Lautstark/vorlaut-diy-talker/docs/cable.md

# Content over the cable

How the editor gets pictures and sentences onto the device once there is no
server left to fetch them from: down the USB-C cable it is charged through
anyway.

The way that is being replaced — the search, the five digits, the manifest over
HTTP — is in [software.md](software.md), and it is worth reading first. Almost
every decision here is that one turned around, and the reasons it is turned
around are the interesting part.

## Why the old way stopped being possible

The device used to **pull**. It looked for the computer with a UDP broadcast,
paired itself, fetched a manifest and then fetched the files it did not have.
That worked because there was a server: something with an address, listening.

The editor is becoming a page and nothing else. Two things follow, and neither
is a matter of taste:

- **A browser tab cannot be an HTTP server.** There is no address for the
  device to fetch from. Nothing in the browser can be given one.
- **A page served over HTTPS may not talk to a plain-HTTP device on the local
  network.** That is mixed content, and it is blocked. Serving the page over
  plain HTTP instead would cost every other browser API the rewrite depends on,
  because those need a secure context too.

So the device cannot pull, and it has to be pushed to. The only wire left
between the two is the one that was always there: the cable that charges the
battery. That is why the USB-C socket has to reach an edge of the case — see
[hardware.md](hardware.md), where it is a requirement for a different reason.

## Lines, and a mark on every one of them

Everything here is `keyword value` lines, for the reason
[software.md](software.md) gives at length for the manifest and the pairing
format: **a JSON parser on the ESP32 means a library, a heap and a class of
failure a fixed line format does not have.** A reader skips keywords it does
not know, so either side can gain a field later without the other falling over.

What is new is that every line is **marked**, in both directions:

```
> hello                    the browser speaks
< vorlaut 1                the device answers
```

This wire is not a private channel. It is the same USB CDC serial port the
firmware prints its log to, and it prints all the way through a transfer —
`menu opened`, `key 1: /a8c1….wav`, `LittleFS: 486400 of 1441792 bytes used`.
Without the marks, the browser would have to guess whether a line was an answer
or a diary entry, and the device would take a serial monitor's stray keystrokes
for commands.

With them, the rule on each side is one line long:

| | |
|---|---|
| the browser | ignores everything that does not begin `< ` |
| the device | ignores everything that does not begin `> ` |

The device's log survives that instead of being crushed by it: the browser puts
every unmarked line in the transfer sheet's log, which is the most useful thing on the wire
when something has gone wrong. `tools/serialcheck.html` shows them mixed in,
and the mock in `loader/tools/cable_mock.js` chatters on purpose so that a client
which only works on a silent wire fails here rather than on a bench.

## The device is deliberately stupid

Seven verbs, and each of them is one thing:

```
> hello                      who are you
> list                       what have you got
> crc <name>                 checksum one file
> get <name>                 hand one back, as raw bytes
> put <name> <size> <crc>    one file follows, as raw bytes
> rm <name>                  throw one away
> done                       that is all
```

It does **not** work out what is missing. Over Wi-Fi the device did exactly
that — it compared the server's manifest against its own file system — and it
had to, because the server could not push. Here the browser can, and the
browser is the end with the memory, the language and the whole layout in front
of it. Everything the device would have had to hold in a `String` to do the
comparison is a `String` it does not allocate.

**`get` is the seventh verb and the newest, and it is here to keep that
sentence true rather than to soften it.** Once a device holds several
collections, removing one means working out which tiles and recordings the
collections that *stay* still name. Something has to read those layouts, and
there were only two candidates: the device parses its own files and answers a
question about them, or it hands the files over and the browser does the
arithmetic it already does for every `put`.

A device that walked its own layouts would be a device with an opinion — the
first thing here that decides rather than does, and the exact shape the Wi-Fi
version had before the push turned it around. Handing a file back is one more
thing the device *does* and no more thinking, which is the same shape `crc`
already had: the browser asks a narrow question, the device answers it without
knowing why. So the vocabulary grew and the stance did not.
[ADR 0021](../adr/0021-the-device-holds-several-collections.md) argues it at
length.

Nobody probes for the verb. `collections` in the greeting says whether a device
holds more than one, the verb and the capability arrived in the same firmware,
and only a device that named a number above one is ever sent a `get` — so an
older talker is never asked something it cannot answer. If one were, `err verb`
comes back, which is a word to act on rather than a silence to guess at.

So `list` walks the directory and prints it as it goes, and the diff happens in
`loader/tools/cable.js`. The answers:

```
< vorlaut 2                  it is one of ours, and 2 is the protocol version
< firmware v0.4              and this is the build it is carrying
< total 1441792              the partition
< free 1146880               what is left of it
< collections 16             how many collections it will hold
< tiles vt1                  and which tile forms it can draw
< audio va1                  and which recording forms it can play
< end hello

< file t3bd7….bin 26912
< file a8c1….wav 41008
< end list 37

< crc layout.bin 1a2b3c4d
< data c3bd7….bin 5104 1a2b3c4d   a file coming back: length, checksum, then bytes
< sent c3bd7….bin 5104       and that is what really went
< go 4096                    send at most this much, then wait
< ack 8192                   this much is in the file system
< ok a8c1….wav 41008
< gone t3bd7….bin
< bye 12 3 486400            stored, removed, bytes
< err nospace                may replace any of the above
```

**`hello` is how the browser knows what it is talking to at all.**

There used to be a `files` line here, and taking it out on 2026-09-02 is worth
a paragraph because of how it was found. The device could not say the number
without walking its whole root, a lookup per entry, and on a 7040 KiB partition
holding 322 files that walk took 6.4 seconds against a browser that gave any
one answer five. So a talker that had been filled up stopped answering the
loading page, and said so in the words for a device that is not there - the
cable was in and the device was awake. The browser end got patience for the
walks that remain, and then the walk that nothing needed was taken out: nothing
read the number. The page works in `total` and `free`, and what is on the
device it asks for with `list`, which walks once, when somebody wants it.

Dropping a line costs no protocol version for the same reason gaining one does
not, and the notes below say it several times over: a browser that hears no
`files` keeps whatever it started with. The direction that needs holding is the
other one - every talker flashed before that release still says it - and that
is held on the browser's side, where the reader is. The person
picks a port out of a dialog, and a laptop has several — a dongle, a printer,
another dev board. A port that does not answer `vorlaut` within a moment is
not the talker, and saying so is nicer than timing out later mid-transfer.
`free` earns its place in the same answer: it is what lets the browser refuse a
payload that will not fit *before* it starts sending one.

The `total` above is a device on the 1536 KiB table — 1441792 is what LittleFS
makes of it — because that is the number `device/fixtures/` was frozen with and
those fixtures are not re-cut for a partition table. A device flashed since
2026-08-31 answers with the 7040 KiB one instead, and nothing on either end has
to be told which: that is the point of the number being in the greeting.

**`firmware` is a different question from `vorlaut`, and that is why it is a
different word.** The protocol version moves only when the two ends can no
longer drive each other, so every talker says the same number for releases at a
time; asking it which build a device is carrying gets an answer that was true
of a dozen firmwares. So the greeting names the build as well: a release says
its own tag, because `release.yml` compiles with `-DVORLAUT_VERSION` out of
`GITHUB_REF_NAME`, and anything compiled anywhere else says `dev`. Nobody edits
a constant to cut a release — see
[`firmware/vorlaut/version.h`](../firmware/vorlaut/version.h) for why a number
somebody has to remember to move is worse than no number at all.

Nothing on either side orders two of these words. The device names its build,
the browser writes the name down, and a page that wants to say "two releases
behind" has to hold it against a version it brought itself. **A device that
says nothing here is not a fault**: it is any talker flashed before
2026-08-28, and refusing one would refuse every device already in a drawer.
`fixtures/cable/firmware-named-in-the-hello` is the transcript that names a
build, and the eight beside it are the ones that do not.

That keyword is also the first this protocol has ever gained, and it is the
extension rule the header has claimed since it was written actually running:
the device says a word older browsers skip, and `CABLE_VERSION` did not move.

**`tiles` is the second, on 2026-08-31, and it is the rule paying for itself.**
A tile may now travel compressed ([ADR 0019](../adr/0019-tiles-travel-compressed.md)),
and a device flashed before that day would draw a compressed one as a palette
followed by noise — a full panel of it, silently, in a house nobody here knows
about. So the browser sends the compressed form only to a device that named it,
and every device that says nothing keeps getting exactly the bytes it got
yesterday. `fixtures/cable/tiles-named-in-the-hello` is the transcript that
names a form; the nine beside it are devices that do not.

The word is matched whole and never ordered. There is no "newer" here: a
browser that read an unknown form as probably-compatible would be sending a
file it cannot know the other end can read, and neither end would say anything
when it was wrong.

**`collections` is the third, on 2026-09-01, and it decides whether a transfer
adds or replaces.** A talker used to carry one collection in `layout.bin`, so
what the payload did not name was stale and the sweep below is a correct sweep.
A talker that holds several has no way to tell "stale" from "belongs to the
other game" — every tile is named for its content, so two collections that use
the same picture use the same file — and there the sweep is the one edit that
silently breaks a collection nobody touched.

So the device says how many it will hold, and **silence means one**, which is
what every talker flashed before that day really holds. A number, not a flag:
the browser has to refuse a payload that would push a device past what it can
keep, and it cannot do that against a boolean.
[ADR 0021](../adr/0021-the-device-holds-several-collections.md) is the decision,
and `fixtures/cable/collections-named-in-the-hello` is the transcript.

It also runs the other way, and this is the half that is easy to get wrong. A
page that knows about collections sends `c<hash>.bin`; a device that does not
opens `/layout.bin` and no other name. Sent the new name it would store a file
it never reads and — being a one-collection device, so a device every transfer
replaces — sweep away the one it does, coming back with five black keys from a
transfer that reported success. **So the greeting picks the name too:** one
collection gets `layout.bin`, more than one gets `c<hash>.bin`, decided in
`underDeviceNames()` in `loader/src/cable.ts` at the same point the tiles pick
their form, because that is the first place that knows who is listening.

**`audio` is the fourth, on 2026-09-01, and it is the same rule with a louder
failure behind it.** A recording may now travel as IMA ADPCM
([ADR 0022](../adr/0022-recordings-may-travel-compressed.md)) — four bits a
sample instead of sixteen, still a WAV, distinguished only by the tag in its
`fmt` chunk. A device flashed before that day never opens `fmt`: it plays
whatever is in `data` as 16-bit PCM, so a compressed recording comes out as a
full-volume hiss where a word should be, at the moment somebody pressed a key
expecting one.

Two words rather than one, and that is not tidiness. Every talker flashed
between 2026-08-31 and 2026-09-01 draws a compressed tile and plays no
compressed recording, so a browser that read `tiles vt1` as a general yes would
send that device a file on the strength of an answer about pictures.
`fixtures/cable/audio-named-in-the-hello` is exactly that device, and
`fixtures/cable/audio-form-named-in-the-hello` is one that names both.

Naming the form is only half of what has to be true before a recording is
compressed. **The other half is a person**, because nothing in a package says
whether its recordings are words in a game or things somebody is understood
through, and four bits a sample is bearable only in the first case. The loader
page asks, above the button, and the answer is not remembered — ADR 0022 has
why.

**A verb the device does not know is answered, not ignored.** `err verb` comes
back. A browser waiting for a reply that never arrives looks exactly like a
broken cable, and the two are worth telling apart.

**And the number in `vorlaut 2` is compared.** It had not been until
2026-08-27: `findTalker()` tested it for truthiness, so any non-zero version was
accepted and then driven as whatever the browser spoke, and the only thing that
read it at all was a test grepping `tools/cable.js` for the digit. That was
survivable while there was one protocol. The acknowledged transfer made it two.

A version that is not this browser's is **refused, in both directions**, and
the reason is what the number means rather than caution. `cable_format.h` bumps
it exactly when the two ends can no longer drive each other, and says outright
that gaining a keyword is not that — unknown keywords are skipped on both sides
and cost no version at all. So a different number is a statement that these two
do not work together, and there is no field saying a particular bump was safe
one way round. Sending anyway means finding out mid-transfer: a browser waiting
forever for an `ack` it will not get, or a device overrun and failing on a
checksum. Either can leave a talker with silent keys, which is worse than a
sentence before anything is sent.

The two directions get different sentences, because the remedies are opposite
and neither of them is "the device is broken":

| The device says | What it is | What fixes it |
|---|---|---|
| a version below this page's | firmware older than the page | flash the device |
| a version above this page's | the page is the stale half | reload the page |

`hello` does not refuse either of them. It is also how the browser tells a
talker from a dongle, and throwing there would file a device that answered
under the same heading as a port that said nothing — which reads as "nothing
answered" and sends somebody to check a cable that is fine. So the greeting
comes back whole, `versionVerdict()` says what it means, and `findTalker()`
keeps walking the remaining ports before it reports anything: two boards
plugged in should still reach the one that works.
`fixtures/cable/version-older-device` and `version-newer-device` are the two
transcripts.

## The names already say what changed

The file names are hashes, so the manifest thinking from
[software.md](software.md) carries over whole: **the same symbol or sentence in
three sets is one file, and a name that is already on the device is already the
right content.** The browser lists, subtracts, and sends the difference. In use
that means almost nothing moves — changing one symbol and one sentence in a
five-set layout sends three files and deletes two.

`layout.bin` is the exception at both ends, exactly as it was over Wi-Fi. Its
name never changes, so presence proves nothing about it, which is why `crc`
exists as a verb. It is the only file the browser has to ask about, and asking
about it costs one line.

## A name is not a checksum

This is the trap in the paragraph above, and it is easy to read past in
[software.md](software.md), which states it plainly and then moves on:

> the names are hashes of the **input** — source image plus pipeline version,
> or text plus voice configuration — not of the output bytes.

So a name tells the device which content was *meant*. It cannot tell it what
actually *arrived*. Every `put` therefore carries a CRC-32 of the bytes, and
the device refuses the file if what it received does not match.

CRC-32 rather than something cryptographic, because what is being guarded
against is a transfer that went wrong, not somebody choosing bytes to fool us —
whoever is holding the cable can write whatever they like anyway. What it
catches is the silent set: a truncated transfer, a byte count one out, a
partition that quietly stopped accepting writes. All of those otherwise end as
a file under a name that promises whole content. It is the same CRC-32 as
`zlib.crc32`, so a value can be checked by hand.

## The order, and why layout.bin goes last

A push is: send what is missing, send `layout.bin`, then delete what is stale.

That order is not arbitrary. `layout.bin` is the table that says which file
belongs to which key, so **it is the commit**. Until it lands the device still
reads the old one — and the old one still points at files that are all still
there, because nothing has been deleted yet. The moment it lands, every file it
points at has already arrived. There is no instant at which the device holds a
layout referring to a file that is not there.

Doing it the other way round — clearing out first — has a failure that is quiet
and nasty: a transfer that breaks off halfway leaves the old layout pointing at
symbols that have been deleted, and the device comes up with silent keys and no
explanation.

The cost of the safe order is room. For the length of the transfer both the old
files and the new ones sit on the same partition — **6.9 MB** since 2026-08-31
(`spiffs` in [`firmware/vorlaut/partitions.csv`](../firmware/vorlaut/partitions.csv),
7040 KiB), and **1.5 MB** before it, on every device that has not had a whole
image written since. A full payload is around 950 KB, so on the old table
replacing *every* symbol and *every* sentence at once did not fit; on the new
one it fits several times over.

What the browser does about it has not changed and should not: the size is the
device's answer, not the page's assumption. `free` came back in the `hello`, and
if the new files will not fit alongside the old ones it falls back to clearing
out first and says so on the page. If it will not fit even then, the payload is
simply too big for the partition and nothing is sent at all. That the fallback
is now rare on a device with the new table is a property of that device, and
the page finds it out by asking.

## Half a file, and the handshake that prevents worse

Files land under `/.part` and are renamed only once they are whole and their
checksum agrees — the same rule `sync.h` followed, for the same reason. **A
transfer that breaks off leaves a fragment behind, never half a file under a
name that promises whole content.** The name was shared with the Wi-Fi sync
while both existed — deliberately, since the two never ran at once — and it is
this one's alone now.

The `go` in the middle of a `put` is the other half of that:

```
> put a8c1….wav 41008 1a2b3c4d
< go 4096
<4096 raw bytes>
< ack 4096
<4096 raw bytes>
< ack 8192
    …
<432 raw bytes>
< ack 41008
< ok a8c1….wav 41008
```

**The bytes are sent only after `go`.** By then the device has checked the name,
checked that the file will fit, and opened `/.part`. Without the handshake, a
device that refused the file would be followed by 41008 bytes of WAV arriving in
its line reader — and somewhere in a WAV there is eventually something that
looks like a command. The round trip costs about a millisecond and removes the
whole category.

**And the bytes go a window at a time.** That is the subject of [the window is
the flow control](#the-window-is-the-flow-control) below, and it is the reason
this document no longer has a receive buffer in it.

**The name is created by the rename and by nothing else.** That is worth
stating on its own, because more rests on it than on any other line of the
device's code. The order is: write every byte into `/.part`, check the
checksum, and only then rename. There is no point at which the final name
exists holding bytes that have not been checked — an interrupt leaves a
fragment under a name nobody consults, or it leaves nothing.

Two things follow that would otherwise both be wrong:

- **Keeping a file because its name is present is sound.** The browser skips
  what the device already has, on the name alone. If a transfer could leave a
  short file under its real name, that file would be kept for its name, never
  sent again, and `layout.bin` would eventually point at a truncated tile or a
  truncated recording. Silent, and permanent, because nothing ever looks at it
  again. The rename is what makes the skip safe.
- **Stopping is free, at any moment.** A cancelled push costs the fragment in
  `/.part` and nothing else, so cancelling is a matter of not sending the next
  thing rather than of undoing the last one.

The browser compares the size as well as the name — one comparison, and `list`
already reports sizes. That is a net under the rename rather than a second
opinion: if the invariant above were ever broken, by another implementation or
a damaged file system, a wrong length turns a silent-and-permanent fault into a
file that is simply sent again.

The bytes are raw rather than base64 or hex. Base64 would cost a third of the
budget — on the 1.5 MB partition of the day, a third of everything there was —
and, worse, would make the *device* do work per
byte to undo it. The device reads exactly `size` bytes and then goes back to
reading lines; it never has to look for a newline inside file content.

## Losing the thread, and finding it again

The one thing that can genuinely desynchronise this protocol is a `put` that
does not finish: the browser tab was closed, the person walked off, the cable
came out and went back in. The device is then counting down to a byte total
that will never arrive, while the rest of a file may still be in flight.

Three rules handle it, and they are the part of this protocol that most wants a
real device to be tried on:

1. **Give up on silence.** Four seconds without a byte and the transfer is
   abandoned, `/.part` is deleted and `err short` goes back. Nothing here may
   hang: a device parked in a transfer is a device that has stopped being a
   talker, which is the same rule the setup portal's three-minute timeout
   follows. A file system that stops accepting bytes partway through says
   `err lost`, which is a different word from the `err write` of a file that
   could not be opened at all — the distinction is not cosmetic, it is
   whether there are still bytes in flight to be thrown away.
2. **Drain before listening.** What is left of the window may still be coming,
   so the device throws bytes away until the wire has been quiet for 400 ms.
   Only then does it read lines again. The window is what makes that a few
   thousand bytes rather than most of a WAV — but it is not why the rule
   exists, and the rule does not change with it.
3. **Only `hello` gets back in.** Everything else is answered `err session`
   until the browser introduces itself again. A stretch of a WAV that happens
   to contain `\n> hello\n` would have to be chosen on purpose, and whoever is
   holding the cable has easier things to do.

### The four seconds, and what they are now for

`CABLE_QUIET_MS` used to be the one constant here with a real design risk
behind it: it had to be longer than any pause LittleFS could take in the middle
of a transfer, and nothing on a computer could say what that was. A run that
worked only showed the pause did not exceed four seconds *once*.

**That risk went with the window.** The device now waits only for bytes it has
just asked for, so what four seconds has to outlast is one round trip and a
browser's own scheduling — milliseconds against seconds. It stays where it is
rather than being tuned down, because what it is really for is a browser that
has gone away, and noticing that a little late costs nothing.

The browser has the mirror of it and waits five seconds for any one answer.
Longer on purpose: both ends are waiting on each other during a transfer now,
and whichever gives up first is the one that gets to say why. The device gives
up first, sends `err short` and shuts the session — which reaches the browser
as a word to act on instead of a silence to guess at.

So the device measures and reports, before every `ok`:

```
< gap 12         longest stretch this file spent with nothing arriving
< stall 340      longest single write into LittleFS
```

Two numbers, because they are two different risks and one would hide the
other. `gap` is what `CABLE_QUIET_MS` is actually compared against. `stall` is
where a garbage collection pause shows up — and it does **not** appear in `gap`,
because while it happens the device is inside `file.write()` rather than
waiting for bytes.

**What `gap` means changed with the window**, and it is worth knowing which
number is being read. It used to be the browser running late, and under a full
receive buffer it read 4001 ms because the bytes were not late at all but gone.
Now the device waits after every `ack` for a window it has just asked for, so
`gap` is a round trip: expected to be small and **not zero**. A zero over a
whole payload no longer means nothing was ever late — it means no window was
ever waited for, which is a client that is not acknowledging.

Both are ordinary keyword lines, so a reader that does not know them steps over
them. That rule is stated all through this document; these are the first lines
to depend on it, which is worth saying because until they existed the browser
client did not actually follow it. It does now, and the mock reports fixed
values so every test run goes through that path rather than only the one test
aimed at it.

The bench shows the worst of each after a push, with the margin.

**The numbers that were here were taken under version 1 and do not carry over.**
They are kept below because the reasoning is still worth reading, but they
describe a protocol in which the browser sent whether or not the device was
listening, and that is no longer what happens.

| measured 2026-08-23, protocol version 1 | |
|---|---|
| longest `gap` over a full payload | 0 ms |
| longest `stall` over a full payload | 53 ms |
| the same payload before `CABLE_RX_BUFFER` | `gap` 4001 ms, dead on the first file |

A full payload of ten files and 199 KiB, across in 3.3 s at 60 KB/s. The `gap`
of 0 did not mean the wire was fast; it meant a 64 KB buffer was swallowing the
burst, so the device never had to wait. And the 4001 ms before that buffer
existed was not lateness — the device was waiting for bytes that had been
**thrown away**, which no value of `CABLE_QUIET_MS` could have rescued.

**What version 2 has to show is different, and it is still a prediction.**
Version 2 *has* run on hardware since — that is the six-row table at the end of
this document — but every run so far was driven by hand, and none of these three
numbers was read off the page while it was sending. So this stays written down
before the measurement rather than remembered after it:

| what a bench run has to report | what it should say, and why |
|---|---|
| longest `gap` over a full payload | **small and not zero.** The device waits after every `ack` for a window it has just asked for, so the gap is now a round trip. Zero would mean no window was ever waited for. |
| longest `stall` over a full payload | around 53 ms still, or worse on a fuller partition — and it no longer matters what it is. A stall is a pause now, not a hole. |
| the rate | slower than 60 KB/s, by one round trip per window. 55 of them for that payload, so the question is whether it is 5% or 50%. |
| bytes lost | **zero, and this is the one that is not a matter of degree.** A short file, a wrong checksum or an `err short` on a payload the device had room for means the window is not doing its job. |

The last row is the whole change. The others are the price of it, and the price
is worth knowing before anybody decides it is too high.

### The window is the flow control

The device sends a number with its `go` and takes no more than that before
saying it has the bytes:

```
< go 4096          at most this much
<4096 raw bytes>
< ack 8192         and this much is now in the file system
```

`ack` carries the **running total**, not the size of the piece. A per-piece
count agrees with itself all the way down a stream that has slipped; a total
disagrees with what the browser has sent, at the first window, out loud. The
browser compares them and stops.

Three things follow, and the third is the point:

- **The browser reads the number, it does not choose one.** The device is the
  end that knows how much room it has. A browser with a chunk size of its own
  is the guess this replaced, one layer up.
- **The end of the file ends the window.** The last one is short and is
  acknowledged like the rest, so neither side has a full-or-partial case to get
  wrong. An empty file has no windows and no acks, which is the rule read
  literally rather than an exception to remember.
- **The bytes in flight are bounded by a number the device chose**, so the
  receive buffer is sized from it — `Serial.setRxBufferSize(CABLE_WINDOW)`,
  4 KB where 64 KB used to be. That is not a saving, it is the difference
  between a promise and a hope.

**`CABLE_RX_BUFFER` was a workaround and it has gone.** It was arithmetic
rather than comfort — USB fills an empty buffer at about 490 KB/s, the longest
LittleFS write measured 46 ms, so 22 KB could arrive with nowhere to go, and
16 KB had already been tried and lost 214 bytes of 26912. But it was a *bound
and not a guarantee*: a longer stall on a fuller partition would have overrun
64 KB in exactly the same silence, because the interrupt reads the USB FIFO,
finds no room and discards, and CDC has no way to tell the other end. The
browser reports every chunk written and the device is quietly short.

There is no number to get wrong now. The device cannot fall further behind than
it asked to.

**It cost a version.** `CABLE_VERSION` is 2, and the break is in both
directions: a version 1 browser pushes a whole file into a device waiting to be
asked, and a version 1 device never sends the window a version 2 browser waits
for. There is no compatibility path and there should not be one — no devices
are in the field, every one is on the desk, and a protocol carrying a path
nobody needs is worse than a clean one. It was free exactly once.

**And it did not add a second idea of a session.** That was the thing to watch:
an acknowledgement scheme is where "in a transfer" quietly becomes state that
outlives the transfer. The window and the running total live for one file and
die with it. `open` in `serve()` is untouched, so the rule below still reads the
way it did.

That third rule is not a special case. **A device that has not been greeted is
in exactly the same state as one that has just lost a transfer** — refusing
everything but `hello`. One rule, two uses, and no separate idea of "in a
session" to get wrong.

Before a greeting the device only waits a quarter of a second for a whole line,
rather than four. Until a browser has said `hello`, whatever is on this wire is
as likely to be a serial monitor or one stray byte, and every millisecond spent
here is a millisecond the keys are not being read.

## Stopping halfway on purpose

A push takes a cable's worth of time, and the page needs to be able to stop —
a dialog closing, a navigation, somebody changing their mind. That is an
`AbortSignal` passed into `push()` rather than a `cancel()` on the connection:
all the time is inside that one function, and a signal composes with the page's
own reasons to stop through `AbortSignal.any()` in a way a bespoke method
cannot.

**It is checked between files, not inside one.** It could be checked inside
one — the rename above makes stopping safe at any instant — but a push stopped
mid-file leaves the device counting down its four seconds to bytes that will
never arrive, after which the session is shut until `hello`. A step boundary is
at most one file away, well under a second, and leaves the connection usable.

An aborted push never sends `done`, which is the point: `done` is what makes
the device read its new layout in, and a half-sent payload is not one to start
reading. Closing the connection is the caller's business, not `push()`'s — the
cable was handed in, and a caller that wants to abort and retry should not find
its port shut underneath it.

## No pairing, and no key

Over the network, the device showed five digits and somebody typed them into
the page. That existed to answer one question: is the thing asking for this
content actually standing in front of the device? The digits were a way of
proving physical presence over a wire that anybody on the network shares.

**The cable is that proof.** Whoever has hold of it is in the room, with the
device in their hand. There is nothing left for five digits to establish, and
so there is no pairing, no secret, no token and nothing stored in NVS.

That does mean anyone who can plug into the device can rewrite its content.
That is worth saying out loud, and it is the same trust the project already
extends to physical access — anyone who can plug in can also reflash it
entirely. What has genuinely gone away is the harder case the digits were
really guarding: a second machine *on the network* claiming to be the device.
There is no network.

## Two facts about the browser that shaped this

**`requestPort()` needs a click; `getPorts()` does not.** Opening the port
picker requires transient user activation, which expires in about five seconds
in Chrome — so it cannot be called after a long build, and it cannot be called
from a timer. But `getPorts()` returns ports the person has already granted,
with no gesture at all. That decides the shape of the whole interaction:

> **one explicit connect, the first time, and silent reconnect forever after.**

So the page must not do anything slow between the click and the call, and it
should try `getPorts()` by itself on load. `tools/serialcheck.html` does both.

**WebSerial needs a secure context.** `https://` and `http://localhost` both
qualify; a page opened as a `file://` does not. That is not a constraint the
static site has to work around — it needs a secure context for several other
reasons already — but it does mean the harness has to be *served*.

The baud rate is a formality. `port.open()` will not run without one and the
sketch calls `Serial.begin(115200)`, so both say 115200; on the ESP32-S3's
native USB there is no UART in the path to run at it, and the throughput is
whatever USB and LittleFS manage between them.

One thing to leave alone: **DTR and RTS.** Toggling the two together in the
right pattern is exactly how `esptool` drops an ESP32 into its bootloader.
Raising DTR on its own is wanted — it is what makes the device's own `Serial`
report a connection — but nothing should ever drive the pair in sequence.

## What this does not do

- **It cannot wake a sleeping device.** After its idle timeout the talker goes
  into deep sleep, and USB traffic is not one of the things that wakes it.
  Press any key first, then push. The device stays awake for the whole session
  because every line resets the idle timer.
- **There is no other path to fall back to.** `sync.h`, `discover.h`,
  `networks.h`, `pairing.h` and `pair_format.h` were deleted on 2026-08-23,
  along with the radio and the five digits — see [The Wi-Fi path is
  gone](#the-wi-fi-path-is-gone) for why that happened before this had run once.
  The one thing the two used to share is handled: a device that was synced
  before still has `/version` on it, and because the name is now an ordinary one
  the first cable session sweeps it off.
- **The timing rules are the part a board has proved least.** A board ran
  version 1 on 2026-08-23 and produced the two numbers in [the four
  seconds](#the-four-seconds-and-what-they-are-now-for) above; version 2 has
  since run on real hardware too, and five of the six rows below are ticked —
  see [The Wi-Fi path is gone](#the-wi-fi-path-is-gone). What those runs did
  *not* produce is a number: `gap`, `stall` and the rate are reported by the
  page while it sends and nobody has written them down. So the three timing
  rules above, which are exactly the part no test without a clock can exercise,
  rest on a talker that visibly worked rather than on a measurement. Everything
  else has been checked on a computer; see [Where it lives](#where-it-lives-and-what-is-checked).

## Running it on a device

Nothing here needs sound or the case — a flashed board and a cable are
enough, so this can be tried well before [bring-up.md](bring-up.md) reaches its
last stage.

**1. Check the one setting that stops everything.** *Tools → USB CDC On Boot*
must be **Enabled**, or `Serial` is not the USB CDC and no part of this can
work. Under `arduino-cli` it is already the default for this board.

**2. Flash the firmware.** The content does not have to go with it — that is
what the cable is for — so the program alone is enough:

```bash
arduino-cli compile --fqbn esp32:esp32:adafruit_feather_esp32s3_nopsram:PartitionScheme=default_8MB firmware/vorlaut
```

Upload it with the same `--fqbn` and `-p /dev/cu.usbmodemXXXX`, as in
[firmware.md](firmware.md). A device with an empty file system is a fine
starting point here and is worth using at least once: it is the first row of
the table below.

**3. Serve the bench.** Any static server will do — it needs no back end, and
`localhost` is a secure context, which is all WebSerial asks for:

```bash
python3 -m http.server 8799
```

**4. Export the Sammlung, then open the loader page.** These are two steps and
two pages now, and [ADR 0011](../adr/0011-editor-exports-the-talker-repository-sends.md) is
why: the editor writes a file for the talker — the `⋯` beside the Sammlung's
name — and says where to take it, and `/loader/` is the page that takes one.

**5. Connect the talker there, and then send.** The page opens on one card
with one press on it. Connecting is what answers everything else — the greeting
carries the build, the free space and the collection count in one line — so the
view behind that press is the talker itself: what it is running, what it is
holding, and the way to take a collection off it.

*Send a collection* is a task entered from there rather than the page itself,
and it runs four steps down one column, saying what it found at each: what is
in the file, anything the device will not be able to do with it, what it
compiled, and then the transfer with the device's own serial output inline in
the log. Four and not five, because connecting already happened at the door;
the connect step comes back only when the connection wants something again — a
talker that went to sleep halfway, a port that was never granted.

The log stays on the page when it is over — it is the most useful thing there
is when something has gone wrong, and it must not disappear with the last
line.

**The door is not a gate.** WebSerial is Chrome and Edge, and so is
`showDirectoryPicker()`; the same card carries a second way in that needs no
device at all, and in a browser without a cable that way in is the primary
button. Checking a file and seeing the boards is worth opening this page for on
any browser, and a page that asked for a talker before it would say so would be
the mistake `gate()` was written to undo, in a better-looking shape.

**Connecting is the first press**, because a port has to be granted and
`requestPort()` needs transient activation that expires in about five seconds.
It used to be the fourth step, behind a build; at the door there is nothing
waiting behind it at all, which is the shape that rule always wanted. The card
explains what the browser is about to ask and puts *Connect the talker* under
it; that button's own click is the activation. Chrome's chooser is drawn
in the browser's chrome and no token of ours reaches it, which is why
everything around it is ours and it is not.

**Closing that chooser does nothing at all** — nothing compiled again, nothing
logged, nothing changed, and the page is still standing on the step it was on.
That is the case this got wrong twice while it lived in the editor: it used to
build anyway and then report that nothing was sent, which read as the dialog
having been ignored; then the chooser was moved out of the press altogether,
which fixed it by removing the thing somebody had pressed the button for. What
made it expensive there was that a wrong port cost a whole build — minutes of
synthesis — and that cost is gone: the compile here needs no network and takes
seconds, so a wrong port costs a second press. Every attempt after the first
goes straight through — `getPorts()` hands the port back with no gesture at
all, and the
sheet names it rather than asking again.

**Choosing a different port later needs no settings panel**, and since
2026-08-25 there is not one. A port that stops answering — a different cable, a
different talker, or one that was never the talker — fails the transfer with
`cable_no_device`; that sets `askAgain` in `release.ts`, and the next press is
back at the step with *Choose the device* on it. The error text says so, so
somebody knows a second press is worth making rather than guessing.

**What that costs is one build, and it is a real cost.** `run()` builds and
then sends, so the press that discovers a dead port has already paid for a full
build with every synthesis in it. One press, one wasted build, then the chooser
and a second build.

The fix would be to find the talker before building rather than after. Two ways
of writing it have been ruled out, and the second is why this is still the way
it is.

**Holding the cable open across the build does not work.** `hello` starts a
session, and the device ends one after `CABLE_QUIET_MS` — four seconds — of the
browser not talking (`firmware/vorlaut/cable.h`, the loop that reports "the
browser stopped talking"). A build is minutes, so that breaks every transfer
rather than only the unlucky ones. Holding it open *without* greeting is no
better: before a hello the wait is `CABLE_GREET_MS`, a quarter of a second,
after which `serve()` simply returns. There is nothing there to keep alive.

**So the probe has to be a session of its own** — open, hello, **close**, build,
open again — and that is where it stops, because `hello` is not free at the
device. It is not a quiet question: `cable.h` calls `progress("hello")`, and
`vorlaut.ino` puts *Kabel* on all five displays for it, which is deliberate and
says so in as many words — it is meant to be obvious at a glance that the keys
have stopped. Closing the port does not undo it, because nothing on the wire
tells the device the browser has gone: it waits out its four seconds, gives up,
delays 1500 ms so a count can be read, and only then redraws. **About five and
a half seconds of a talker showing *Kabel* and answering no key** — before a
build that then takes minutes, and before the real transfer greets it a second
time.

That is the trade backwards: a visible freeze on every good transfer, on a
device a child may be holding, to save one build on the rare bad one. So the
build stays first. Checked against the firmware on 2026-08-25 and deliberately
not built.

**What would make it cheap is a way to ask "are you a vorlaut" that does not
open a session** — something a device answers before `hello`, without reaching
for the displays. That is a change to `firmware/` rather than to the page, and
it is the only thing that turns this from a bad trade into a good one.

**The bench is still here for what that button cannot be.** `tools/serialcheck.html`
is where a payload can be invented with no build behind it — so that a failure
is the wire or the firmware and not one of several new things at once — or read
off the disk with *Pick a `data/` folder*. Serve it as in step 3 and open
<http://localhost:8799/tools/serialcheck.html>. It cannot reach into the
editor's storage — a different origin is a different IndexedDB — which is why
the editor writes the folder and the bench reads it.

Close the serial monitor first if one is open, and close whichever of the page
and the bench you are not using. Two programs cannot hold the same port, and
the symptom is a port that simply will not open.

**5. Watch the device, not only the page.** All five displays should show
*Kabel* with a count climbing, and the talker should come back by itself
afterwards holding the new content. The sheet's log shows the device's own
serial output inline — that is where a mount failure or a wrong partition
scheme will say so.

If nothing answers, the page says so within a moment rather than hanging: a
port that does not reply `vorlaut` to `hello` is not the talker, and that is a
different problem from a transfer that failed.

## The Wi-Fi path is gone

It was deleted on 2026-08-23, and none of the six rows below had been ticked.
This section used to say that must not happen, so it says what changed instead.

**The bar was one real end-to-end success**, and it was met on 2026-08-27 —
five of the six rows at the end of this section, recorded one at a time. The
reasoning behind it was sound: `tiles.py`, `tts.py` and `layout_format.py` had
been *oracles* — the only reason anybody knew the browser ports were right — but the firmware Wi-Fi stack
was an oracle for nothing. It was just the old transport, kept because a working
way to get content onto a device is worth having while the new one is unproven.

**What expired was not the bar but the fallback.** That argument rests entirely
on the Wi-Fi path still being a way in, and it stopped being one when `app.py`
was deleted: the device could still find a network, and there was nothing on it
to find. `build.py` and `flashing.py` went the same day. So what was being kept
as insurance was a radio, a captive portal, four stored networks and a token in
NVS, all serving a path whose other end no longer existed — 850 KB of program
space and 24 KB of RAM, and a device that would have spent seconds looking for a
server nobody was running.

**Prove first, delete second, in separate commits** was the other rule, and that
one was kept. The cable landed on its own, with the browser test that drives it
against the mock; the deletion is the commit after it. A revert of either is
still a revert of one thing.

**What that cost, and what closed it.** For a day it cost the only way back:
if the cable turned out to be wrong on hardware there was no way at all to put
content on a device — not because the radio went, but because nothing wrote the
files to disk. `build.py` had written `firmware/vorlaut/data/`, the browser
build writes IndexedDB, and the backup export leaves build output out on
purpose, so `mklittlefs` had nothing to image and this bench's folder picker
had nothing to pick.

That is what *Write the build into a folder* is for — in the `⋯` beside the
Sammlung's name, with the two exports, because it writes that one Sammlung's
files. It writes exactly what the cable would send, into a folder you choose,
and it is the second way in:

- **The bench can send it.** Pick that folder under *Pick a `data/` folder*
  below. The page and the bench are then two independent clients of the same
  protocol, which is worth having when one of them is the suspect.
- **`mklittlefs` can image it**, and `esptool` writes the image straight into
  the partition. That path uses no cable protocol at all, so it is the one that
  still works when the wire itself is wrong.

It refuses to write a build that no longer matches the board, which is the one
failure a folder cannot show you: yesterday's content looks exactly like
today's once it is on a disk.

It is no longer the gate on a deletion; it is the gate on trusting the only
path there is.

What has to be true, written down before the run rather than remembered after
it. **Results belong in this table as they come in** — a row that was checked
once and remembered is a row nobody can audit later:

| | | 2026-08-27 |
|---|---|---|
| a full payload transfers | all five sets, worst case near the 1.5 MB partition, **with nothing lost** — see the version 2 table above for what each number should say | ✅ **yes.** 25 tiles at exactly 32768 B each — five keys × five sets, none short — 20 WAVs, and a `layout.bin` of 932 B that parses. `free` 131072 of 1572864, so 91.7% full: the worst case this row asks for, met rather than approximated. |
| an incremental transfer moves only what changed | the whole point of the content-addressed names | ✅ **yes, in its strictest form.** A second export was sent and the device came back **byte-identical** — same 46 files, same `free`. Content-addressed names mean a changed file arrives under a *new* hash, so an unchanged listing is proof that **nothing** moved rather than proof that nothing was checked. A naive sender would have pushed 1.4 MB again. Still worth doing once more with one symbol altered, to watch exactly one file move. |
| an interrupted transfer leaves a fragment | pull the cable mid-transfer: `.part` and no half-file under a real name | ⬜ not tested. No `.part` appears in `list`, which is consistent with a clean run and is **not** evidence for this row. |
| the device *speaks* the new content | not merely reports success | ✅ **yes**, reported by the person at the bench. The device also names its own set — `set 1: Sprechen` — where before the transfer it said *"No content on the device."* |
| a second transfer needs no port picker | `getPorts()` finds the device again — **this one decides an interface question, see below** | ✅ **yes.** A later session found the device again with no picker: `getPorts()` returned the previously-granted port after the board had re-enumerated. This is the row that could have put a picker on every transfer, and it did not — see below for why it was never a nicety. |
| a device that already holds content is updated | rather than confused by what is already there | ✅ **yes.** The device held 46 files from an earlier build and answered *"No content on the device"*; after the transfer it holds a valid layout and speaks. |

**Five of six.** Row five was ticked after this table was first filled in, and
what is left is the one row that needs a *deliberate* act: a cable pulled
mid-send. That does not happen by accident during a run that goes well, which is
why it is still blank rather than inferred from one that did.

**Row two was nearly recorded as the wrong row.** It was reported as "a partial
transfer" and that phrase fits row three just as well; the device could not
settle it, because an incremental transfer that moves nothing and an interrupted
one that was cleaned up leave the same listing. It took asking. Worth
remembering, because the six rows are close enough in ordinary language that a
run described afterwards can tick the wrong one.

**The version 2 numbers were not captured, and still have not been.** `gap`,
`stall` and the rate are what the page reports while it is sending, and every
run so far was driven by hand without them being written down. They are not
derivable afterwards: the device answers what it *holds*, not how it came to
hold it. Next run, read them off the page as it goes — this is the one thing
above that a run which goes well will keep failing to produce, because nothing
about a good run makes anybody look.

**What the file listing does settle**, because it needed no instrumentation:
every tile is exactly 32768 bytes, which is 128 × 128 × 2 — a short file would
show here and none does. That is the *bytes lost* row of the version 2 table,
and it is the one that is not a matter of degree.

**The third is the one still open**, and the two facts about it are the same
fact: it is the only row the bench cannot produce — pulling the cable out
mid-transfer is a thing only hands can do — and the only one whose device-side
behaviour has no test at all, since it is the timeout, the drain and the refusal
that only `hello` clears. It outlasted the other five for that reason rather
than because anybody doubts it.

Two of them now have a version that runs in a browser: `e2e/loader.spec.ts`
feeds the loader page a real package, presses Send against `cable_mock.js` and
checks that the device ends up holding exactly what was compiled, and that a
second press sends nothing. That
is the second and sixth rows in everything except the part that matters here —
there is no flash, no re-enumeration and no clock in it. It is what says the
wiring is right, so that a failure on the bench is about the hardware rather
than about which file the page read. A board has since done both for real, and
that is what the two ticks record — the browser version is what makes a red run
mean something, not what earns the tick.

**Row five is not a convenience.** *Connect* on the loader page is meant to
find the talker without asking, on every session after the first. That rests
entirely on `getPorts()` returning a previously-granted port without a gesture.
If a granted port does not survive the device re-enumerating, there is a picker
on *every* transfer — so this row settles an interface question rather than
measuring a nicety, and it should be reported as such.

**The shape of that promise changed with [adr/0011](../adr/0011-editor-exports-the-talker-repository-sends.md), and the row did not.**
It used to be the editor's single button that built *and* sent, and then the
argument was sharper still: the press that would open the picker was the same
press that started the build, and by the time a build was over the transient
activation `requestPort()` needs had long expired. The loader page pulled those
apart — connecting is a step with a button of its own, for exactly that reason,
and `loader/src/main.ts` says so at the top. What survives is that a picker
appearing on every transfer is a worse page, not a broken one.

**It survived.** A later session reached the device with no picker, so the
promise holds and nothing has to be withdrawn. Worth keeping the paragraph
above rather than deleting it: what it describes is the shape of a failure that
would have arrived looking like an unreliable protocol, and the next section is
the list of things to check if it ever does.

**Before blaming the wire format, check whether opening the port resets the
board.** On classic ESP32 boards the USB-UART bridge has DTR and RTS wired to
EN and BOOT, so merely opening a connection reboots the chip. The Feather S3
has no such circuit — it is the S3's own USB — but the Arduino core's CDC stack
watches for the DTR/RTS pattern `esptool` uses and resets in software, which is
why flashing needs no buttons pressed. Whether a plain `port.open()` from
Chrome trips that depends on which signals Chrome asserts, and that is not
knowable from here.

If it does trip it, every transfer starts with a reboot, the port handle goes
stale mid-session, and the whole thing presents as an unreliable protocol
rather than as a reset. `setSignals({ dataTerminalReady, requestToSend })` is
the lever; the bench already raises DTR alone and never drives the pair in
sequence. It also asks `hello` up to three times on a first connect, so that a
board which *is* rebooting costs a second rather than looking dead — if that
retry turns out to be load-bearing, that is the symptom, and it is worth
knowing rather than being quietly absorbed.

Three things about the hardware that bear on that list, from
[bring-up.md](bring-up.md):

- ***Tools → USB CDC On Boot* has to be Enabled.** Without it `Serial` is not
  the USB CDC at all and none of this can work. It is already the default under
  `arduino-cli` for this board and a setting to check in the IDE.
- **The S3 re-enumerates when it resets**, and can come back under a different
  `/dev/cu.usbmodem…`. That is the one thing likely to make the fifth row above
  fail for a reason that is not this protocol's fault, so it is worth being
  deliberate about: reset the board between the two transfers on purpose and see
  whether the granted port survives it.
- **None of this needs sound or the case.** A flashed board and a cable are
  enough, so it can be tried at the bench well before stage 7 is finished.

When that list is genuinely true, the deletion is a clean follow-up — and it
takes the five-digit pairing with it on both sides, which is a satisfying
amount of code to remove and deserves to say so in its own commit.

## Where it lives, and what is checked

| | |
|---|---|
| [`firmware/vorlaut/cable_format.h`](../firmware/vorlaut/cable_format.h) | the wire format, with no Arduino in it |
| [`firmware/vorlaut/cable.h`](../firmware/vorlaut/cable.h) | the session: Serial, LittleFS, the half-written file |
| [`firmware/vorlaut/version.h`](../firmware/vorlaut/version.h) | what the build calls itself in the greeting, and why nobody edits it |
| [`loader/tools/cable.js`](../loader/tools/cable.js) | the browser's half, and the diff |
| [`loader/tools/cable_mock.js`](../loader/tools/cable_mock.js) | a device made of a `Map`, for when there is no board |
| [`tools/serialcheck.html`](../tools/serialcheck.html) | the bench, standalone |
| [`loader/src/cable.ts`](../loader/src/cable.ts) | the page's side: which port, where the files come from, what the page is told |
| [`loader/src/main.ts`](../loader/src/main.ts) | the page — choose a file, check it, compile it, connect, send, with progress and a way to stop |
| `tests/test_cable_format.py` | the wire format, held against the firmware's own reader |
| `device/fixtures/cable/several-windows` | the ack cadence as a transcript, with a window of its own |
| `e2e/loader.spec.ts` | the wiring: a file, a press, against the mock served into a real browser |

The split between the last two is the useful one. `loader/tools/cable.js` is the
protocol and is checked by the C; nothing above it in `src/` has any business
knowing what a `put` line looks like. What the page adds is everything the C
cannot see — that a press builds, that the build is read back out of storage
rather than passed around, that the diff is against what the device really
holds, and that a second press sends nothing. Those are the two tests, and they
are deliberately not the same test.

The format header is deliberately free of any Arduino dependency, like
`layout_format.h` and `pair_format.h`, so that the same code the device runs
can be compiled and examined on a computer.

A protocol whose two halves are only ever run against their own author's idea
of the other one is not tested, it is asserted. So the check that matters is
the one in the middle: the browser client is driven through whole sessions
against the mock, **every byte it wrote is recorded**, and those exact bytes
are then replayed into the C reader compiled out of the sketch, which starts
with an empty file system and can only be reached through the wire. Both ends
are then asked what files they are holding, and the answers have to agree down
to the checksums. The other direction is closed the same way: the C formatters
print one of every line the device can send, and the browser client is made to
read them back.

```bash
.venv/bin/python tests/test_cable_format.py
```

That needs a compiler and Node, like the other format tests.

### How we know those checks bite

A fixture that catches nothing looks exactly like one that catches everything,
because both of them pass. So the faults are introduced on purpose and the
suite is watched:

```bash
python3 tools/cablemutate.py
```

Thirty of them, one at a time, plus two changes that alter no behaviour and are
expected to survive — a run in which everything fails proves only that the
harness is broken. **30 of 30 caught, both controls surviving.**

Seven of the thirty are the acknowledged transfer, and they are worth listing
because most of them are not caught by anything the client *says*:

| the fault | what catches it |
|---|---|
| the browser sends a chunk of its own instead of the window it was given | the mock throws away what arrives past its window and gives up, the way a full receive buffer does |
| the browser stops waiting to be acknowledged | the same |
| the window is assumed rather than read off the `go` | the same, and `device/fixtures/cable/several-windows`, which announces a different number from every other transcript |
| the browser stops comparing the ack with what it sent | a scenario that forces the mock to acknowledge one byte short — nothing that is working can produce it |
| the mock stops minding a host that outruns it | a client driven past the window by hand, which has to fail |
| the mock's flash stops taking any time | a transfer that would then be too quick to have waited for anything |
| the mock can no longer be made to acknowledge the wrong total | the scenario above, which then has nothing to catch |

The last three are the guards on the guards. A mock that minds nothing and
answers instantly would let every one of the first four through, so **the
control that a client which does not wait really is caught is itself a test**,
and it runs beside them.

It did not start there. The first run caught 12, and each of the five misses
was a real hole rather than a missing assertion:

| what went unnoticed | why |
|---|---|
| a checksum losing its zero padding | every value in the fixture happened to have eight significant digits, so the case the format string exists for was the one case not present |
| `done` sent after an abort | the check inside the loop covered everything except aborting on the *last* step, which is the only case the guard before `done` is for |
| `layout.bin` no longer sent last | nothing looked at the order at all |
| the browser no longer skipping unknown keywords | it read the timing line where it expected `ok`, took a number out of it, and nothing compared that number with what was sent |
| the device no longer reporting its timings | nothing asked for them |

Two of those were worth fixing in the code rather than in the test. `put()` now
compares the length the device echoes back with what was sent — agreeing on the
name but not the length is what a slipped stream looks like from this end, and
it was the one failure that would have stayed quiet, because the next command
would still have been answered normally. And the transcript is now walked the
way the device walks it, counting the bytes after each `put` instead of
searching for text: a file's content is followed straight by the next command
with no newline between them, so counting is the only exactly right reading.

**What none of this reaches is `cable.h`.** It needs Arduino and LittleFS and
is not compiled here, so the `.part` rule, the timeouts and the drain have no
mutation testing behind them — they are the same half a run on the bench has to
answer for. The device's side of the acknowledgement is in there too: the loop
that acks *after* writing rather than before is mutated by nothing. The
stand-ins next door in `tests/` are harnesses rather than implementations, so
breaking one of those would only be breaking the test.

One thing does compile it, and it is worth naming because nothing in the suite
does:

```bash
arduino-cli compile --fqbn esp32:esp32:adafruit_feather_esp32s3_nopsram:PartitionScheme=default_8MB firmware/vorlaut
```

That is a compiler, not a bench. It says the header builds against the real
Arduino core and nothing more.

## Trying it without a device

`tools/serialcheck.html` runs against the mock with nothing plugged in, which
is the whole path apart from the wire itself: connect, list, work out what is
missing, push it, and read every file back off the device to compare. Serve the
repository and open it — WebSerial and the directory picker both need a secure
context, and `localhost` is one:

```bash
python3 -m http.server 8799
```

Then <http://localhost:8799/tools/serialcheck.html>. **Use the mock instead**
needs no hardware; **Make a payload up** needs nothing set up at all, and
**Pick a `data/` folder** takes whatever the last build left in
`firmware/vorlaut/data/` — which is now the only payload there is, since
nothing can make a new one. Ticking *change two files and the layout* is how to
see the case that matters: the second push should send three files and delete
two, and leave the rest alone.

**Take the build from the editor** was a fourth button here, and it has gone.
It could not have worked: this bench is served on its own port so that
`localhost` gives it a secure context, and a different origin is a different
IndexedDB — there is nothing of the editor's for it to read. The editor sends
its own build now, through this same `loader/tools/cable.js`, which is the answer that
button was standing in for.

What is left here is what that button cannot be: a payload with no build behind
it, and a folder read straight off the disk. Both are better for a first bench
run than anything that goes through a build, because a failure is then the wire
or the firmware rather than one of several new things at once.

Two things it did that the editor's own path does instead, and both are worth
naming because they are easy to leave out:

- **Yesterday's content is not sendable.** The bench had to check the build's
  `current` flag, because it could be pointed at a stale `data/`. The editor
  cannot be: the press builds first and then sends what that build produced, so
  there is no window in which the two disagree.
- **Each file is checked against the length the manifest declared**, which is
  what a build moving underneath the read looks like. `loader/src/cable.ts`
  does this and refuses the whole transfer rather than sending a mixture of two
  builds — a device that is half one and half another is wrong in a way nothing
  downstream would notice.

And one rule that outlives all of it. `/api/build/*` was page-facing;
`/api/device/*` was **not**, and must never be called from a page — those sat
behind the talker's own token, and handing that to anything served to a browser
hands it to whoever asked for the page. Both are gone with `app.py`, and the
test that asserted the difference went with them, so whoever writes the next
pair has only this paragraph to go on.
