Lautstark/vorlaut-diy-talker/docs/frozen-references.md

# What checks the browser, now that the Python is gone

Five subsystems used to exist twice — tile rendering, the layout binary, the
speech chain, symbol search and the Open Board Format converter — because the
app was being rewritten from a Python web app into a browser-only static site.
The Python halves were also, for a while, the only reason anybody knew the
JavaScript halves were correct.

They have now been deleted. This document is what was recorded first, and what
that recording does and does not still cover.

The precaution came from [`mitreden`](https://github.com/Lautstark/mitreden):
when that project deleted its Python half, it found that its browser audio
tests measured the output with the same function that had decided the gain. A
wrong loudness implementation would have satisfied every one of them. Real
`ffmpeg` was the only outside opinion available and it was minutes from being
deleted; it was used one last time to freeze three reference tones, and those
numbers are now the only external check left in that repository.

**A test that can only compare a thing against itself passes forever.** So the
outside opinions here were written down while there were still outside
opinions to write down. That turned out to be the last chance: on 2026-08-22
the Python halves were deleted, and this is what is left behind them.

## The five lock files

| | frozen from | needs, to check it | what it protects |
|---|---|---|---|
| [`tests/reference/tts.lock.json`](https://github.com/Lautstark/vorlaut-editor/blob/main/tests/reference/tts.lock.json) | real `ffmpeg` 9.0.1, and `tts.py` driving it | node | `node_modules/@lautstark/stimmquelle/` |
| [`tests/reference/tiles.lock.json`](../tests/reference/tiles.lock.json) | Pillow, through `tiles.py` | node | `loader/src/tiles.ts` |
| [`tests/reference/layout.lock.json`](../tests/reference/layout.lock.json) | `layout_format.py`, confirmed by the firmware's C reader | node, a C++ compiler | `loader/src/layout_format.ts` |
| [`tests/reference/symbols.lock.json`](https://github.com/Lautstark/vorlaut-editor/blob/main/tests/reference/symbols.lock.json) | `metacom._scan_files()` | node | `src/data/symbols.ts` |
| [`tests/reference/obf.lock.json`](https://github.com/Lautstark/vorlaut-editor/blob/main/tests/reference/obf.lock.json) | `obf.py` and `normalize_layout()` in `layout.py` | node | `src/data/obf.ts` |

Each was written by a tool that could only run while the Python half was here
— `tools/ttsfreeze.py`, `tools/tilefreeze.py`, `tools/layoutfreeze.py`,
`tools/symbolfreeze.py`, `tools/obffreeze.py`. The first four went with it;
`tools/obffreeze.py` is still in `tools/`, kept as the record of how its lock
was made, and cannot run — everything it imports went. The lock files carry
what produced them, when, and what would invalidate them, and git has the
tools and their oracles if one is ever needed again.

**`git add -A` before running the suite, when you have just added fixtures.**
The reason is in `tests/run.py`'s docstring and in the Tests section of
[`software.md`](software.md), where it applies to any new file. Freezing is the
worst case of it: these arrived twenty-seven files at a time.

The direction only goes one way, and it is the whole point:

> Changes to `static/` never invalidate a lock file. That is the thing being
> checked. Refreezing to make a red test green would leave the browser
> compared against itself, which is what these files exist to stop.

## What a lock file can and cannot answer

It could not be said often enough while the deletion was pending, and it still
decides what these files are worth:

**A live oracle re-derives the answer for any input. A fixture only answers for
what was recorded.** What is frozen here keeps regression detection on the
recorded set. It cannot work out the right answer for a case nobody recorded —
bump `TILE_PIPELINE`, add a field to the layout, and these files cannot say
what the new correct bytes are. Nothing in the repository can, now.

That makes them a **supplement to the oracles, not a replacement for them.**
They are insurance against a check evaporating quietly; they were never the
check itself.

The bar for removing the Python used to be **replaced and proven on the
bench** — not "replaced", and not "the hardware arrived". On 2026-08-22 that
bar was dropped by a decision rather than met: the halves went before the
cable path had ever touched hardware, on the grounds that the product has no
users, the formats are early, and carrying a second implementation to answer
questions nobody was asking was the worse trade. So this section is no longer
an argument against anything. It is the price, written down.

If that trade ever stops looking right — if the formats settle and somebody
needs to know what a *new* symbol or a *new* layout should produce — the
answer is to restore an oracle from git for as long as it takes to re-freeze,
not to guess.

One removal these do not bear on at all, because the two get conflated easily:
the firmware's Wi-Fi stack — `discover.h`, `networks.h`, `pairing.h`, `sync.h`
and the five-digit code — is not an oracle for anything. It is the old
transport, its bar is one real end-to-end cable transfer, and it is written up
in [`cable.md`](cable.md) under "Before the Wi-Fi path can go".

## What is now checked against something that is not itself

### The speech chain — the one that had nothing

`tests/test_browser_tts.py` was never a behavioural test. It parsed constants
out of `static/tts/level.js` and compared them with `tts.py` — its own docstring
said "the exported numbers out of level.js, without running any JavaScript."
Correct constants over wrong arithmetic passed every check in it. The real
verification was `tools/ttscheck.py`, run by hand,
whose result exists as a table in [`browser-tts.md`](browser-tts.md) that
nothing regenerates.

[`tests/unit/level.test.ts`](https://github.com/Lautstark/vorlaut-editor/blob/main/tests/unit/level.test.ts) now runs the
module, via [`npm test`](../npm test) so
that `python3 tests/run.py` picks it up. Four kinds of frozen reference:

- **The ruler.** Five tones measured by `ffmpeg`'s `ebur128`. `integratedLufs()`
  is what decides the gain, so measuring the output with it proves nothing —
  these break that circle. 1000 Hz at two amplitudes, 440 Hz, 60 Hz and
  10000 Hz, each somewhere the K weighting is doing something different: 440 Hz
  is deliberately not flat, 60 Hz is the only one down the high-pass skirt, and
  10000 Hz is the only one up on the head shelf. Agreement when frozen was
  0.04 LU or better on all five.
- **The peak meter.** `truePeakDb()` is the other half of the gain decision.
  Two tones sampled an eighth of a cycle off their own peaks, so every sample
  sits 3 dB below the real maximum. Three opinions frozen for each: `ffmpeg`'s
  reading, the waveform's actual peak — it is a sine, so that is arithmetic —
  and the loudest sample, which is what a meter that never interpolated would
  report.
- **Resampling.** 22050 Hz down to 16000 Hz, which is what every recording
  goes through. A tone below the new Nyquist rate must keep its level; one above
  it must disappear rather than fold back. The gap between those answers is
  about 50 dB.
- **The whole chain.** Four synthetic utterances, each put through
  `tts.postprocess()` — real `ffmpeg`, the real filter chain — and the finished
  file measured. The browser's own levelling — `static/tts/level.js` then,
  `@lautstark/stimmquelle/browser` now — gets the same bytes and must arrive at
  the same place. This is the check that would have caught anything, and it is only not
  circular because the ruler above is checked first, then used.

The three 440/1000 Hz values reproduce `mitreden`'s frozen numbers exactly
(−23.0, −9.0, −17.7), which is why they were taken rather than reinvented — a
reference that differed by 0.05 LU between two repositories for no reason
anybody could name would be worse than no shared reference.

### Tile rendering — honest, but the reference evaporated

`tests/test_tile_render_js.py` really did render both ways and compare, which
is why it could say 0 of 13456 pixels differ (16384 since the tile grew to fill
the display — see "The one lock that was rewritten" below). But it built its inputs with
`Image.new()` and took its expected bytes from `tiles.render_symbol()`, so both
sides were recomputed by Pillow on every run. Remove Pillow and the reference
did not fail loudly — it evaporated: the test skipped, said Pillow was missing,
and the suite stayed green with the renderer unchecked.

Fourteen tiles are now committed, with the pictures that made them. Frozen as
decoded pixels rather than PNGs, gzipped, so the check needs no PNG decoder and
no Pillow — node's own `zlib` is enough. The five symbols in `example/symbols/`
are in, because a fixture nobody looks at is a worse regression test than the
picture on the device; the other eight were drawn to reach a branch nothing
else reaches:

| fixture | why it is there |
|---|---|
| `wide-opaque` | METACOM's own 706×589, opaque to the edge, all four corners one colour — so the leftover strip takes that colour instead of white. Checkerboard in the middle, which is the hardest thing there is to resample |
| `tall-soft` | taller than wide, soft-edged all round, so premultiply, resample and unpremultiply all see partial alpha |
| `small-wider` | smaller than the tile in both directions: nothing is resampled and the whole answer is where it gets centred |
| `corners-differ` | fully opaque, one corner a different colour — the only fixture that reaches white by the corner test rather than the alpha test |
| `nearly-opaque` | one pixel at alpha 254, with the corners in agreement, so the two paths give *different* grounds and 39 rows of strip to show it in |
| `odd-leftover` | shrinks to 128×63, leaving 65 rows to halve — rounding instead of flooring moves every pixel |
| `quantisation` | 116×116, which `thumbnail()` will not enlarge, so nothing is resampled and the RGB565 conversion is alone. Values sit either side of every bit it throws away. It was exactly tile-sized when it was drawn and is 6 px shy of it now, which adds a centring offset to what it proves rather than taking anything away |
| `fully-transparent` | every pixel transparent over a colour, which must be dropped rather than smeared into the edges |

The test made three comparisons and was explicit about which survives: node
against the frozen bytes (needs nothing else), `tiles.py` against the frozen
bytes (catches a Pillow upgrade, skipped without Pillow), and the constants.
Two are left. `tiles.py` went with the Python half on 2026-08-22 and nothing
replaces that row: from here the frozen bytes are the only opinion there is
about what a tile should look like, and they answer only for the fourteen
symbols recorded. The test's own docstring says so in the same words.

### The layout binary — the instinct was wrong

`tests/test_layout_format.py` compiled the firmware's own C reader — the same
`firmware/vorlaut/layout_format.h` that `vorlaut.ino` includes, calling the
`parseLayout` the device calls. That reader owes Python nothing, so the obvious
conclusion was that this check survives on its own.

It does not, and the reason is worth keeping. The reader survives; what it was
compared against did not. `normalize_layout()` in `layout.py` built every input
and `loader/src/layout_format.ts` has no equivalent — only `normalizeColor`. `expected()` built the field lines the reader was held
against. And `render_layout_bin()` was the only opinion on whether the
JavaScript bytes were right. Delete Python and what is left is a reader that
parses whatever it is handed and a test with nothing to compare.

So seventeen cases are frozen: the normalized layouts, the bytes, and the fields
the reader made of them. [`tests/test_layout_frozen.py`](../tests/test_layout_frozen.py)
needs only the lock file, node and a compiler. Two independent things have to
agree for it to pass, which is what keeps it from being a mirror: the bytes are
a captured value, and on their own would only say the browser has not changed —
but the C reader is *compiled from the firmware's source at test time*, not
frozen, and its field-by-field output is what makes a frozen byte string mean
something.

The three-way comparison is still made, and it is
[`tests/test_layout_frozen.py`](../tests/test_layout_frozen.py) that makes it:
node writes the bytes, the lock says what they have to be, and the compiled C
reader says what they mean. Only the third party changed. In
`tests/test_layout_format.py` it was `layout_format.py` writing every case
alongside node — a live opinion that could answer for an input nobody had
recorded — and here it is a captured value that cannot. That test went with the
Python half on 2026-08-22, and one check went with it: that the frozen layouts
are still what `normalize_layout()` produces. Nothing else would notice that
going stale, and now nothing does — the frozen cases go on agreeing with each
other about a layout no program here generates.

### The board as a document — the only one with no second opinion

The other four have something outside Python to fall back on: Pillow is one
renderer among renderers, `layout.bin` has the firmware's own C reader
compiled at test time, the speech chain has `ffmpeg`, and symbol search is a
naming rule two implementations both state. A `.obf` is a mapping this project
invented — which set becomes which board, what a set key is, where the colour
lives — so `obf.py` was the entire outside opinion on whether
[`src/data/obf.ts`](https://github.com/Lautstark/vorlaut-editor/blob/main/src/data/obf.ts) is right.

`tests/test_obf_js.py` compared the two live and imported `obf` at the top, so
it could not survive the deletion in a form that reported anything: it would
fail to start, be removed with the Python it named, and leave nothing with an
opinion about the converter at all. That is exactly what nearly happened —
this was the last of the five to be frozen, and it was frozen hours before the
deletion rather than days.

So `tools/obffreeze.py` writes down what the oracle says, in the shape the
node driver answers in, and `tests/test_obf_frozen.py` compares the two with
nothing but node:

- **The helpers**, on the arguments where two implementations of one rule
  drift — a symbol reference split and rejoined, `image_id`'s SHA-256 over
  names of one, two, three and four byte characters, `rgb()` out of a colour
  that still needs normalizing, a locale nobody has heard of.
- **Every layout on the way out**, as the document it becomes, field by field.
- **Every document on the way in**, as the layout it becomes — the exporter's
  own, and the foreign ones, which is the half that matters. A third row of
  keys, links by path and by name, an orphan, a picture carried as pixels, a
  label and a vocalization that disagree.
- **`normalize_layout()`**, which is in `layout.py` and decides what a
  complete layout is. The browser has a copy of it now; without this the copy
  is checked against nothing.
- **The licence rule**: nine documents, seven of which have to be refused, and
  the sentence each is refused with.
- **The container.** Thirteen files under
  [`tests/reference/obf/`](https://github.com/Lautstark/vorlaut-editor/tree/main/tests/reference/obf/) — nothing compressed, no
  manifest, a manifest naming a root nobody packed, board ids that are not the
  file names, a board that is a list, three that have to be refused rather
  than answered with an empty layout — and, for every export case, the members
  `write_obz()` packed with their fixed timestamp and mode.

Byte-identical `.obz` files are not the bar and cannot be: `zlib` and the
browser's `CompressionStream` are two compressors that agree about the format
and not about the output. What is frozen is what comes out of the members, and
Python's own `zipfile` — which is not going anywhere — is what opens the
browser's file to get at it.

`tests/test_obf_js.py` kept the live comparison while `obf.py` was here, and
gained one check before it went: that the frozen answers were still the ones
the oracle gave, by running `tools/obffreeze.py --check`. Nothing else would
have noticed that going stale — the browser and a lock file would have gone on
agreeing about a mapping `obf.py` no longer had.

### Symbol search — a paraphrase, not an oracle

A symbol lives in `layout.json` as `metacom:essen`. `metacom.py` keys the
collection by the file's stem and `obf.py` reads it back that way; the browser
gets a path out of the vendored `bildquelle` package and `src/data/symbols.ts`
turns it into the same reference. If those drift, every layout that exists
points at symbols nobody can find.

`tests/test_symbol_reference.py` checked this all along, against
`"metacom:" + Path(path).stem` written out by hand. Two things were wrong with
that once `metacom.py` is going: the paraphrase survives the deletion and then
passes for ever, both sides of it being in the browser's half — and a
paraphrase can already be wrong. This one was. `_scan_files()` globs `"*.png"`
and nothing else, so for the `.jpeg` and `.webp` cases in that test
`metacom.py` files nothing at all, while the restatement confidently supplied
an answer.

So `tools/symbolfreeze.py` asks the real indexer: it builds a folder, runs
`metacom._scan_files()` over it, and writes down what that filed each case
under. Where the glob does not reach a file the name is still frozen from
Python — `path.stem` *is* the expression in `_scan_files()`, and only the glob
kept the file out — but the lock records that nothing resolves for it, which is
a fact about the collection rather than a fault in the adapter.

Those unreachable cases turned out to be load-bearing, and not for the reason
they were added. Every PNG makes *strip the last suffix* and *drop four
characters* the same rule, so a `.jpeg` is the only thing in the set that can
tell those two apart. Without it a mutation doing the latter passed every
check — found by mutation testing, not by reading.

### And one check that needs no oracle at all

Every lock file answers only for the cases in it, and for the OBF converter
that limit bites hardest: `obf.py` is gone, so no case can ever be added.

[`tests/unit/obf_roundtrip.test.ts`](https://github.com/Lautstark/vorlaut-editor/blob/main/tests/unit/obf_roundtrip.test.ts)
asks something a lock file structurally cannot:
`documentToLayout(layoutToDocument(x)) == x`. That holds for any correct
mapping on any input, recorded or not, and needs nothing outside the converter
— which is why it survives having no Python. The idea is the seam session's.

It caught something on its first run. A layout with **no sets** cannot round
trip: Open Board Format carries the locale *on a board*, and a layout with no
sets becomes a document with no boards, so the language has nowhere to travel
and comes back as the default. No change to the converter could fix that
without inventing a field nobody else would read. The case is kept, with
`language` exempted by name and the reason beside it — the only exemption in
the file.

What it cannot see is the half of the format that exists for other programs.
Breaking `border_color` on the way out passes every check in it, because the
converter reads the colour back out of `ext_vorlaut_color`. A round trip is
blind to every field written for somebody else's software, and those are the
fields that make an interchange format worth having. The lock is the only
opinion on those, for the boards in it, and there is no third thing.

## How we know the checks bite

Every claim above was tested by breaking the implementation and confirming the
suite went red. Nine of ten mutations to `level.js` were caught, and the tenth
was too after the trim check was tightened; ten of ten to `tiles.js`; nine of
ten to `layout_format.js` and the firmware header, with the tenth an equivalent
mutant that produces identical bytes for every input the format allows.

Representative, with the check that fired:

| broken on purpose | caught by |
|---|---|
| the adapter dropping four characters instead of finding the dot | the one `.jpeg` case, and nothing else |
| the OBF sleep timeout or a set colour dropped, either direction | the round trip, naming the field that went |
| the OBF set order reversed on import | the round trip, naming the first set that moved |
| OBF `border_color` written from the wrong field | **nothing here** — written for other programs, read back from elsewhere. Only another program opening the file would catch it; see the gaps list |
| the adapter cutting at the first dot | the fixture whose name carries a dot that is not the extension |
| K-weighting head shelf removed | 10000 Hz and 1000 Hz tones |
| K-weighting high pass removed | the 60 Hz tone, and only that |
| BS.1770's −0.691 offset dropped | all five tones |
| relative gate removed | the `burst` utterance against `tts.py` |
| true peak taken over the samples only | both peak tones, by 3 dB |
| resampling by linear interpolation | the 10 kHz tone folding back instead of going |
| the −1.5 dBTP ceiling ignored | `burst` landing 2 LU loud and over the ceiling |
| Lanczos support 3 → 2 | nine tiles |
| centring rounds instead of flooring | `odd-leftover`, and four others |
| RGB565 rounds instead of truncating | twelve tiles |
| alpha 254 read as opaque | `nearly-opaque`, and only that |
| `NAME_BYTES` changed under the fleet | the C reader's fields |
| a frozen case edited by hand, hash refreshed | the JavaScript writer disagreeing |
| a symbol reference losing its collection | `symbolOf`, and every board with a METACOM key in it |
| the manifest's root ignored on read | the one fixture whose root is not its first board |
| `sort_keys` dropped from the board JSON | the members of every written `.obz` |
| the zip's fixed timestamp moved to today | the stamps on all eight written zips |

## What no longer works at all

The sections above are about checks. This one is not, and the distinction
matters: a check that is missing lets a mistake through, and a capability that
is missing stops the work. The deletion on 2026-08-22 took both, and only the
first was noticed at the time. The WebSerial session read the commit rather
than its summary and found the rest.

**Nothing could build content, and now something can.** `build.py`,
`builder.py`, `manifest.py`, `tiles.py`, `tts.py`, `layout.py` and
`layout_format.py` are gone, and for a while nothing stood in for them:
`runBuild()` in the editor threw by its own admission and both sides refused.
It was written — the orchestration that was `builder.py`, against the ports of
`tiles.py` and `tts.py` that were already here and already measured — and it
has since moved rather than gone: `compileDevice()` in
[`loader/src/compile.ts`](../loader/src/compile.ts) does the same work on the
page that sends, out of a file rather than out of a store
([adr/0011](../adr/0011-editor-exports-the-talker-repository-sends.md)). Changing a symbol or a
sentence renders again.

**Both routes onto a device went, not one.** `flashing.py` made the LittleFS
image and drove `esptool`, so the cable is not merely the only *new* path — it
is the only path, and it had never touched hardware when the Python was
deleted. **That is closed as of 2026-08-27**: the browser drives it end to end —
the editor exports a file, the loader page compiles and pushes it, and
`e2e/loader.spec.ts` holds that against the mock — and a talker has now been on
the far end of it, flashed, filled and speaking. The wire format was never the
doubtful part; `tests/test_cable_format.py` feeds the client's own bytes to the
firmware's reader. What the deletion actually bet on was that the *only* path
would work, and the bet has been settled the right way. [`cable.md`](cable.md)'s
six-row table is where it is settled, one row at a time, and one row is still
open.

The Wi-Fi stack went too, on 2026-08-23, with the six-row table still unticked.
[`cable.md`](cable.md#the-wi-fi-path-is-gone) has the reasoning. For a day it
left this document's worst entry: nothing wrote the build to disk, so if the
cable turned out wrong on hardware there was no second way in — not for want of
a radio, but for want of a folder. **That is closed.** The Device panel writes
the build into a folder somebody picks, and from there the bench can send it and
`mklittlefs` can image it. `tests/unit/build_export.test.ts` holds the half that
could destroy something: which names the tidy-up may remove.

**Content is not backed up, and that is deliberate.** `firmware/vorlaut/data/`
and `content/` are both gitignored, so they survived the deletion by never
having been in git — the last built payload, the board being worked on, its
symbols and twenty recorded sentences. A board can be built again now; the
recordings cannot be reproduced whatever happens, because piper renders the
same sentence differently every time.

It is test data and its loss was accepted deliberately when this was raised.
Recorded here only so that nobody later mistakes the gitignore for an
oversight, or spends an afternoon trying to recover something nobody wanted
kept.

## The one lock that was rewritten

Every other entry in this document is about a lock that could not be rewritten.
`tiles.lock.json` was, on 2026-08-26, and how it went is the reason the rule
above is a rule and not a superstition.

**Why it could not be narrowed.** The tile stopped being the 116×116 square
inside a border and became the whole 128×128 display. Nothing about that is a
deletion: a different target size means a different scale factor, different
Lanczos weights and a different centring offset, so every pixel of every
fixture changes. There is no field to drop and no bytes to strike out — this
lock *is* the pixels. Narrowing it would have meant deleting it, and tile
rendering would have become the one subsystem here with no outside opinion at
all.

**So the oracle came back.** `tiles.py` and `tools/tilefreeze.py` were restored
from `6be078e^`, along with the four modules they import — `config`, `metacom`,
`buildbase`, `texts` — into a throwaway virtualenv with **Pillow 12.3.0**, the
version named in the lock's own provenance.

**The step that made it worth doing** was running `tilefreeze.py --check`
*before* changing anything. It answered `unchanged - this Pillow renders what
the fixtures hold`: the restored oracle reproduced all fourteen frozen tiles
byte for byte. Without that the re-freeze would have been a new opinion of
unknown relation to the old one. With it, the new bytes come from the same
renderer at the same version, differing only in the one constant that was meant
to differ.

Then `TILE_SIZE` moved in both implementations independently, `TILE_PIPELINE`
went 2 → 3, the tool re-rendered, and the browser's own hand-written Lanczos
was held to the result: **0 of 16384 pixels differ, on every one of the
fourteen**. That is the check doing its job on a reference it did not produce.

The restored files were deleted again the same session; they are in git and
nowhere else. `--check` before `--freeze` is the part to copy.

## What two locks have stopped answering for

Two things have gone out of the talker, and both locks recorded both. The
`active` flag marked which of an author's sets went onto the device, from when
one Sammlung was everything the product had; a Sammlung is the selection now,
ships all its sets, and the flag was deleted rather than migrated. The per-set
**colour** went on 2026-08-26 — from the editor, from `layout.bin`, from the
firmware and from both exports — and it reached further into these files than
the flag did. Neither can be asked again, and neither lock was touched; the
tests were narrowed instead, each naming what it gave up:

- `tests/test_layout_frozen.py`, `THE_FILTER_IS_GONE`. One case of seventeen —
  three sets with the middle one switched off — is set aside. Its right answer
  is now three sets and nothing here can say what those bytes are: `label`,
  `images` and `sounds` were frozen per *active* set, so the middle set has no
  names to be written with. The hash check still covers it, so hand-editing
  that case into agreement is still caught. The other sixteen are untouched.
- `tests/test_layout_frozen.py`, `THE_COLOUR_IS_GONE`. The per-set colour left
  the talker on 2026-08-26, so a set entry is 184 bytes where every frozen case
  has 186, and the version byte is 2 where every frozen case has 1. This one is
  not a case set aside but a transformation applied: the frozen bytes have two
  struck out of each set entry and the version raised, by hand, at a stated
  offset, and *then* the comparison runs. Every other byte is still what
  `layout_format.py` wrote, and the C reader still has to read them into the
  frozen fields, so a wrong offset shifts the name and all sixteen slot hashes
  and fails loudly. It is a deletion rather than a guess, which is the only
  reason it is not the refreeze this document forbids — nothing new had to be
  known. What is lost outright is `older_file`: a layout.bin from before the
  language byte, frozen to show that it stayed readable, is refused for its
  version now and is held to being refused for *that* rather than for its
  length.
- `tests/test_obf_frozen.py`, `ACTIVE_IS_GONE` and `THE_CAP_MOVED`. Two field
  names — `active` on a set, `ext_vorlaut_active` on its board — drop out of
  every comparison, 151 recorded answers between them. Separately, the two
  caps collapsed into one of five sets, so six `normalizeLayout` cases that
  hand it more than that are held to *refusing* rather than to the sentence
  `obf.py` refused them with; one of the six the oracle answered rather than
  refused. Everything else keeps its full value, including the zip members,
  which are still compared as text and so still hold the writer to sorted keys
  and its indent.
- `tests/test_obf_frozen.py`, `THE_COLOUR_IS_GONE`. The widest of the four, and
  worth reading for how differently its three parts land. `color` on a set
  drops out of every compared layout — 27 imports, 54 `normalizeLayout` calls,
  the containers' layouts, the round trip. `ext_vorlaut_color` on a board and
  `border_color` on every button drop out of the exports and out of the zip
  members, **but only where this module wrote them**: a document read back from
  a container keeps both compared, because a foreign board arrives as the
  dictionary it was parsed from and preserving a field nobody here writes is
  the one thing about those names still worth checking. That scoping was
  verified by breaking it — dropping `border_color` on read turns the container
  comparison red, which is what says the narrowing is a narrowing and not a
  hole. The third part is a straight loss: `cssColor()` is gone, so its ten
  frozen answers about malformed colours can be asked of nothing.

Each is the case its lock's own `invalidated_by` anticipates — "a change to
render_layout_bin()", "a change to the structure in
firmware/vorlaut/layout_format.h", "a change to the mapping in obf.py". That is
what makes them a price rather than a fault, and none is recoverable: the
oracles went on 2026-08-22, and the only thing left that could write either
lock is the module it checks.

**Anticipated is not the same as answerable, and that is the distinction to
carry forward.** An `invalidated_by` line says a change of this kind was
expected to break the lock. It does not say the lock can be rewritten
afterwards, and here it cannot. So the question a change of this kind faces is
not "may I refreeze" but "how much of the frozen answer survives the change" -
a case set aside, a field dropped from the comparison, or two bytes struck out
of it. Refreezing from the module under test is still the one thing that is
never the answer.

## What is still only checked against itself

An honest list is worth more than a claim of coverage. In rough order of how
much it would cost to be wrong:

1. **A real browser is in CI, but only far enough to open the page.**
   `e2e/page.spec.ts` drives headless Chrome over the DevTools
   protocol from plain node, and asserts that the page loads with no exception,
   no console error and no 404, that a board renders, and that nothing asks a
   server for anything. It runs against the clone in the suite and again
   against `dist/` before the deploy — which is the check whose absence let a
   page that rendered nothing at all ship green.

   It is shallow on purpose, and everything below it is still unexercised in a
   tab. The vendored chain and `loader/src/tiles.ts` are checked under node,
   where they are deliberately free of the DOM, so node is a fair stand-in for
   the arithmetic — but `tools/ttscheck.html` and `tools/tilecheck.html`, the pages
   that drove them in a real tab, were deleted with the Python harnesses that
   fed them, and nothing has replaced those.
2. **No other program has ever opened a `.obz` this wrote**, and that is the
   only real test of an interchange format. Not a unit test, not a freeze, not
   the round trip: export a container and load it in something else that reads
   Open Board Format. That is the one thing which checks the fields nothing
   here can — `border_color`, the grid, `load_board`, each image's
   `symbol.set` — because they exist for somebody else's software and this
   project never reads them back. It needs no code and no oracle and can be
   done by hand in an afternoon, and until somebody does, "other AAC software
   can read this" is a claim rather than a result. The seam session's point,
   and the honest answer to the row in the table above where the answer is
   otherwise "nothing".

3. **PNG decoding is not covered at all.** The tile fixtures are frozen
   *after* the decode, because that is the one step the browser does and this
   test does not. `tools/tilecheck.py` measured it lossless for these symbols
   — once, by hand, and it no longer exists. A browser that decoded a PNG differently would not be
   noticed here.
4. **No real speech is frozen.** `piper` is not installed on this machine and
   is not deterministic anyway — three renders of one sentence gave three
   different files. The utterances are synthetic. Agreement on real sentences
   is still only [`browser-tts.md`](browser-tts.md)'s hand-run table, and
   nothing regenerates it.
5. **The voice path has no behavioural test.** `static/tts/speak.js` is now
   `@lautstark/stimmquelle`'s, and vits-web and Azure are reached through it;
   nothing here runs one. What checked the vendored side at all was
   `tests/test_browser_tts.py` — that the bundle, the catalogue and
   `CONTRACT.md` were present, and that `tts.py`'s constants matched the
   contract's — and it went with the Python half on 2026-08-22. The
   `onnxruntime-web` pin is written in three places, `package.json`,
   `src/backend/local.ts`'s CDN URL and `src/types/cdn.d.ts`; `renovate.json5`
   explains in a comment why they have to name one version, and no test says
   it.
6. **Symbol search is frozen for the name only.** What the adapter makes of
   a path is now checked without `metacom.py` — but that is the whole of it.
   Whether the vendored `bildquelle` *finds* the right symbol is the package's
   own business and has its own tests upstream; nothing here exercises the
   search or the index it builds. The METACOM `.asar` reader was
   `metacom.py`'s, and `tests/test_metacom_index.py` was the only thing that
   checked it; both went on 2026-08-22, and no `.asar` reader of this
   repository's remains to check.
7. **`normalize_layout()` now exists in the browser too**, in
   `src/data/obf.ts`, because an imported board has to be given a colour and its
   four slots. It was checked against `layout.py` in `tests/test_obf_js.py`;
   both went on 2026-08-22, so what is left is the frozen answers in
   `obf.lock.json`, read by `tests/test_obf_frozen.py` — only on the inputs
   recorded there, and no case can be added to them. `tests/reference/layout.lock.json`'s
   layouts are still `layout.py`'s output rather than something the browser
   reproduces.
8. **Tolerances.** The speech checks allow 0.15 LU on the ruler and 0.2 LU
   end-to-end, against agreement of 0.04 and 0.05 when frozen. The slack is
   room for a different `ffmpeg` build, not measured error — but a systematic
   mistake smaller than it would pass.
9. **`ffmpeg` 9.0.1 is taken on trust.** If it is wrong, everything here
   inherits that. Two things argue against it: `mitreden` froze the same three
   tones from an earlier build and got the same numbers, and
   `Lautstark/stimmquelle` ported this measurement independently and agreed
   within 0.03 dB.
10. **The lock files only answer for what was recorded**, which is the whole
   shape of the deal with golden files and is why "this does not make the
   Python removable" is at the top of this document rather than here. All
   four freeze tools import Python modules, deliberately: it is what stops a
   red test being "fixed" by refreezing, and it is what makes regenerating
   them impossible after a deletion rather than merely inadvisable.
