Lautstark/vorlaut-diy-talker/adr/0008-audio-masters-derived-artefacts.md

# ADR 0008 — One master per utterance, at the voice's native rate; everything else is derived

**Status:** accepted · **Date:** 2026-08-24 · **Applies to:** the recording
chain in vorlaut, SPEC.md 1.0.0 §6

## Context

Two consumers want the same spoken sentence in two different shapes.

**The DIY talker** wants 16 kHz mono 16-bit PCM WAV. That is not a preference:
it is what the ESP32 firmware plays through the MAX98357A, and the recording
chain is called with `rate: 16000` for it.

**An app package** wants Ogg Opus — royalty-free, decoded natively by Android
since API 21, and about a tenth the size, which decides whether a vocabulary of
several hundred utterances is a file you can send in a message.

piper synthesises at neither. Its voices are native at 22.05 kHz or 24 kHz
depending on the voice, with exactly one exception in the catalogue:
`de_DE-kerstin-low` is native at 16 kHz, which is why she alone reaches the
device without a resample.

So both artefacts involve a rate conversion, and there is an obvious shortcut in
front of anyone implementing the second one. The WAVs already exist — the talker
path has been rendering them all along. Encoding Opus from those WAVs is one
ffmpeg invocation and needs no new synthesis at all.
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
