Lautstark/vorlaut-diy-talker/example/symbols/hilfe.png

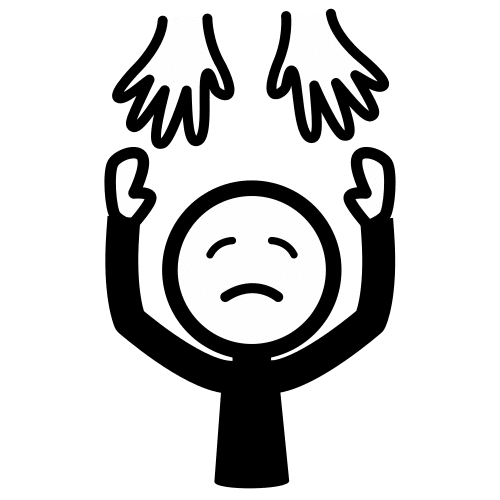
example/symbols/hilfe.png
