Lautstark/vorlaut-diy-talker/example/symbols/start.png

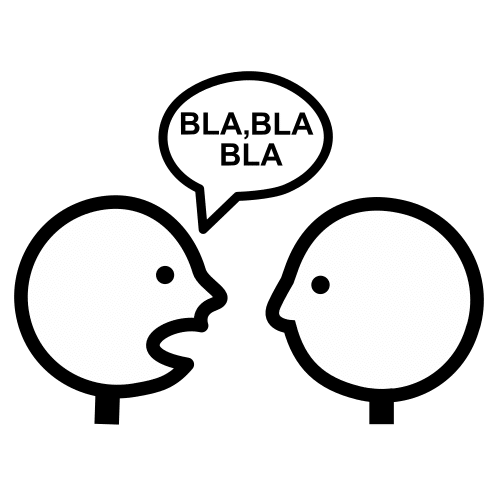
example/symbols/start.png
