Lautstark/vorlaut-diy-talker/example/symbols/stopp.png

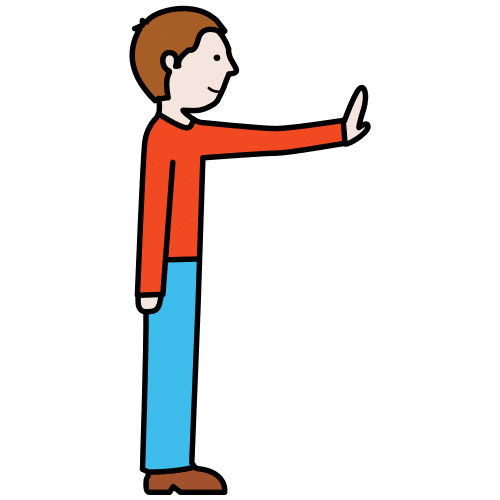
example/symbols/stopp.png
