Lautstark/vorlaut-diy-talker/(list of files, cad)

Other CAD files:
gehaeuse/vorlaut-gehaeuse.scad
