Lautstark/vorlaut-diy-talker/case/building.md

# Building the case

Three printed parts, six screws, an evening's work. All the dimensions are in
[`vorlaut-case.scad`](vorlaut-case.scad); this file explains what to do with
them.

> **Once built.** The first set of parts was printed and assembled in August
> 2026, and five things came back from it: the carrier fouled the speaker
> chamber wall, the ScreenKeys turned out to screw from behind and not into
> bosses on the front plate, the key cutouts were a touch loose, the case was
> too shallow above the carrier, and the raised logo wanted feet it no longer
> needs. All five are in the model now. What is still assumption rather than
> measurement is below under [Measure first](#measure-first).

## The three parts

| Part | What it does | Outer size |
|---|---|---|
| **Tub** | front plate, walls, speaker chamber, lid bosses | 129.9 × 111.4 × 35.5 mm |
| **Carrier** | holds the five ScreenKeys and the Feather, separates wiring from battery | 124.7 × 106.2 × 29.7 mm |
| **Lid** | back panel with the logo cut into it | 127.1 × 108.6 × 3.0 mm |

All three sizes are measured on the exported STL, not merely calculated. The
tub's footprint on the bed is exactly 145.9 × 99.4 mm — with the logo cut in
rather than raised, nothing stands proud of the walls any more.

The case lost 16 mm of width and 9.9 mm of depth in one pass, and neither came
from a clever rearrangement — both were slack. The width was air between the
keys; the depth was the Feather standing on stilts and a cable allowance
measured before the wiring was dressed. Both are covered below.

The carrier changed job without changing shape. It used to be a floor; it is
now also the plate the five ScreenKeys hang off — but it holds them with
nothing but twenty holes, because each module brings its own 8 mm threaded
spacers. So it is still the same flat plate, and it still prints flat.

```bash
openscad -o tub.stl -D 'part="tub"' case/vorlaut-case.scad
```

The same with `carrier` and `lid`. `part="assembly"` shows everything put
together, `part="exploded"` pulled apart, `part="printbed"` all three side by
side in print orientation.

If OpenSCAD does not start — on macOS Gatekeeper blocks the app when launched
from Finder — opening it once via *right click → Open* helps. For checking the
dimensions you do not need OpenSCAD at all:

```bash
python3 case/verify.py
```

The script reads the dimensions from the `.scad` and checks them independently
— key spacing, depth budget, collisions, wall thicknesses, print bed, centre of
gravity. Exit code 0 means everything works out.

And once the STL files exist, a second script checks what OpenSCAD actually
built — outer dimensions and whether the decisive places hold material or air:

```bash
python3 case/check-stl.py tub.stl carrier.stl lid.stl
```

That catches mistakes which stay invisible at parameter level: a cutout with
the wrong depth, say, or a boss that another solid has cut away. Both scripts
need nothing but Python 3.

> **Read what OpenSCAD says, not just its exit code.** A misspelled module is
> not an error:
>
> ```
> WARNING: Ignoring unknown module 'carrier_umriss' in file vorlaut-case.scad
> ```
>
> It leaves that part out, warns, and writes an STL anyway. Renaming a module
> and missing one call site cost the tub 12400 of its 30990 triangles once,
> and the exit code stayed 0. So after every rename, compare the geometry -
> triangle count, volume and bounding box - against the previous render.
>
> Byte comparison does not work for that: OpenSCAD does not order the
> triangles deterministically, and two runs of the same file give different
> checksums. Volume via the divergence theorem and the bounding box are
> independent of the order.

## Printing

Simple FDM printer, one colour. The tub and the lid need **no support
material**: the inner space gets wider towards the back in steps, so every step
is an upward-facing bearing surface instead of an overhang, and all chamfers
are 45°.

**The carrier is the exception, and it is deliberate.** The Feather's bracket
hangs off its underside, and that face is otherwise flat — so support goes
under the bracket and nowhere else, a 51 × 8 mm footprint 19 mm deep. The
battery brackets, the amp bed and everything else still grow upward and take
none. That is what standing the Feather on edge costs, and it buys 13.3 mm off
the case.

Worth knowing that an earlier draft wanted support for a worse reason: printed
poles standing off the carrier to reach the ScreenKey boards, putting geometry
on both faces for nothing. The modules already carry 8 mm threaded spacers —
those poles were bridging a bridge.

| Setting | Value | Why |
|---|---|---|
| Nozzle | 0.4 mm | the wall thicknesses are whole multiples of it |
| Layer height | 0.2 mm | plates are whole multiples of it |
| Perimeters | 3 | 3 × 0.4 = 1.2 mm per side, a 2.4 mm wall is then solid |
| Bottom / top | 5 / 5 layers | 1.0 mm — the front plate carries the keys |
| Infill | 25 % grid | more gains nothing, less flexes |
| Material | PLA or PETG | PETG is tougher, PLA holds size better |
| Supports | **off** for tub and lid, under the Feather bracket on the carrier | see above |
| Brim | 5 mm on the tub | 146 mm of flat surface tends to lift |

No ABS: the device lies around near a small child, and ABS edges splinter when
something is dropped.

### Orientation on the bed

Print all three parts **exactly as they sit in the `.scad`** — `part="printbed"`
shows it. Do not rotate them, that is no accident:

- **Tub**: front face on the bed, opening upwards. The front plate becomes
  smooth that way (bed side), and the lid bosses grow upwards. The other way
  round the key cutouts would be overhangs and the bosses would need support.
- **Carrier**: flat, ribs upwards. The face that goes down is the one the
  ScreenKeys bolt against, so it wants to be the bed side: flat and true, which
  is what sets how far the key caps stand out of the front.
- **Lid**: **inside on the bed, logo upwards.** The logo is a pocket that only
  ever widens going up, so it is no overhang at all — the same reasoning the
  screw countersinks are already built on. Nothing stands proud of this face
  any more, so the lid is 3.0 mm on the bed instead of 4.6.

The only unsupported span is the top edge of the USB window: an **8.4 mm
bridge** in a vertical wall. Every printer manages that; if the first layer
above it sags, turn the fan up.

### What can go wrong

- **Key cutouts too tight.** If the printer runs a little wide, the cap jams.
  The air gap is 0.3 mm all round (`gap_cap`) — half what it was, so this is
  now worth a test print of one corner of the front plate before committing to
  the whole part.
- **Elephant foot on the tub.** The front face lies on the bed; a squashed
  first layer makes the key cutouts smaller. Set *elephant foot compensation*
  to 0.2 mm in the slicer.
- **Lid bosses break off.** Only if you insist on pre-drilling. Do not
  pre-drill, the pilot holes are already there. The ScreenKey holes in the
  carrier are a different matter — those are *clearance* holes, not pilot
  holes, because their screw goes into the module's spacer and not into
  plastic. Nothing to drill there at all.
- **Speaker grille.** 37 holes of 3.0 mm at a 4.6 mm pitch — 1.6 mm of web, four
  passes with a 0.4 nozzle, and about 31 % open area over the cone. Do not make
  the holes bigger to "let more through": 31 % is already far more than a voice
  needs, and from about 4 mm a child's pencil reaches the cone. The cone is the
  one part of this device that cannot be repaired. `verify.py` holds both ends
  of that — the web and the open area.
  Only whole holes are placed, never part-holes cut off at the rim: those come
  out as slivers a fraction of a millimetre wide and stay behind on the print
  bed, because the front face is the face that lies on it.

## Tolerances

All clearances are named variables in section 3 of the `.scad`.

| Where | Variable | Value | Meant for |
|---|---|---|---|
| Around the key cap | `gap_cap` | 0.30 mm | the key must never jam — but no child's finger in it |
| Around the Feather in its well | `feather_play` | 0.30 mm | tighter than the rest — see below |
| Lid in the rebate | `lid_play` | 0.40 mm | the lid should drop in, not jam |
| Carrier | `carrier_play` | 0.40 mm | same |
| Around battery and amplifier | `part_play` | 0.40 mm | insert the part without force |
| Around the speaker frame | `chamber_clearance` | 2.00 mm | the driver never sits tight in the frame |

`gap_cap` was 0.60 mm on the first build and the caps visibly floated in their
holes. 0.30 mm is what it is now: still four times the layer width, still far
too narrow for a finger, and no longer readable as a gap from across the room.

If the printer generally prints fat, do **not** fiddle here but calibrate the
extrusion multiplier. These numbers are design dimensions, not printer
corrections.

## Screws instead of snap fits

Six **M3 × 12 countersunk**, from the back through the lid into the bosses of
the tub. Plus four **M2 × 6 countersunk** per ScreenKey (20 pieces), from the
back of the carrier into the module's own spacers. **Nothing for the speaker** —
see below.

The ScreenKey screws went into printed bosses on the front plate until the
modules were in hand, and that was wrong twice over. **The thread is in the
module, not in the case**, so a screw needs material *behind* the board to pull
against — and the only thing behind the board is the carrier. And the standoff
that gets it there is not something the case has to supply either: each module
carries **threaded spacers, 8 mm**, off the back of its PCB. Those are the
poles. The carrier's whole contribution is twenty clearance holes and twenty
countersinks.

Getting that wrong in the other direction is worth recording, because the model
briefly did: poles printed onto the carrier, reaching forward to the boards
across a gap that the spacers already fill. Two standoffs in series, and a part
that no longer printed flat.

Screw length follows and the `.scad` prints it: 2.4 mm of plate + about 4 mm
into the spacer = 6.4 mm, so **M2 × 6**. If the spacer thread turns out to be
M2.5 rather than M2, `sk_screw_d` and `sk_csink_d` both move.

Why no snap hooks:

- A snap hook is a thin, flexible tongue. Exactly that kind of thing breaks off
  and then lies inside the device as a swallowable small part — with a
  three-and-a-half-year-old that is the deciding factor.
- Printed snap hooks fatigue. This case is a prototype; it gets opened often,
  not once.
- A hook does not pull the joint closed. For the speaker we need as sealed a
  volume as possible at the back, and that means: lid tightened firmly onto a
  flat bearing surface.

The default is **self-tapping M3 straight into the plastic**
(`boss_core = 2.5`). That needs no tool but a screwdriver and lasts a
prototype's lifetime. Whoever opens the case often sets, at the top of the
`.scad`,

```
threaded_insert = true;
```

and gets bosses for **M3 heat-set threaded inserts** (Ø 4.0 × 5 mm). The bosses
grow to 8 instead of 6 mm, and because they sit against the inner wall the case
grows along with them to 149.9 × 103.4 mm. That is not an oversight but
derived: `inner_margin` follows the boss size.

## The speaker is not screwed down

`spk_front_screws = false` in the `.scad`. The driver is located sideways by
the four guide ribs, sealed against the front plate with tape or foam, and
pressed onto that seal by a block of open-cell foam behind it that the lid
compresses. No fastener, and nothing visible on the face of the device.

That is not laziness. Bolting through the front plate costs three things at
once:

- Four countersunk heads sit on the front, next to the grille, and they are the
  only visible hardware on an otherwise plain face.
- The front plate is 2.4 mm of PLA and holds no thread, so each screw needs a
  **nut inside the chamber** — a chamber that can only be reopened by taking
  the driver out again. A nut that works loose in there rattles against the
  cone.
- Four 2.9 mm holes go straight through the front plate into the sealed volume.
  The chamber is meant to be closed; those are four leaks that no amount of
  hot glue on the cable passage makes up for.

Pressing the rim onto the seal was the only real job those screws had, and the
lid already does that — its six M3 pull the whole stack together, which is the
same reasoning that ruled out snap hooks.

**Open-cell foam only.** That is stuffing, and acoustically it behaves like
slightly more volume, not less. A closed-cell block would take 11 cm³ straight
out of the box and lift the resonance with it.

The block got a good deal thicker when the case did. There are now **20.7 mm**
of chamber behind the magnet, not 6.7 — cut the foam to roughly 40 × 40 × 22 mm
so it still goes in with a little compression. The chamber came out at about
78 cm³ net instead of 41.5, which is the one side effect of the extra depth
that is pure gain: a bigger sealed box behind a small driver puts its
resonance lower, not higher.

If the driver rattles once it is playing, set

```
spk_front_screws = true;
```

and the four countersunk holes come back, along with `verify.py` checking the
countersink depth against the front plate. You then need four **M2.5 × 8** with
nuts — and it is worth checking first whether the driver's own frame holes
carry a thread, in which case the nuts are spare.

## No feet on the lid

There used to be four pads, 10 mm across and 1.6 mm proud, near the corners.
They are gone, and the argument that removed them is the one that put them
there in the first place.

The lid is the back of the device, so whatever stands proudest of it is what
the device lies on. With the logo embossed 0.8 mm proud, that was a 70 mm
speech bubble and nothing else: the thing rocked on a table and the embossing
was the first surface to wear through. Four pads taller than the logo fixed
that, at the cost of four pads.

Cut the logo **in** instead and the problem does not need fixing. Nothing
stands proud of the lid, so the device lies on the whole of its flat back —
144 × 97 mm of bearing surface instead of four 10 mm discs. It cannot rock,
there is no embossing left to wear through, and the lid is 3.0 mm on the bed
instead of 4.6.

Bare PLA still slides on a table. Four self-adhesive rubber discs near the
corners land on a flat face just as well as on a printed pad, and now they are
optional rather than structural.

Both decisions are one word each, and both checks stay in place:

```
logo_recessed = false;   // back to the raised logo
feet_on       = true;    // and then the feet are needed again
```

`verify.py` refuses the combination that does not work — raised logo, no feet —
rather than letting it through quietly.

## How small it goes, and what stops it

Two numbers set the width and one sets the depth, and all three are now at or
near a wall rather than at a comfortable guess.

**The key grid.** The floor is 12.00 mm and `gap_block` is set to **14.00**.

The floor is where two independent rules land almost on top of each other: a
child's hand wants at least 12 mm between caps or it presses two at once, and
the *boards* underneath want `pitch_y > sk_board_h + 2`, which is 11.99.

The two millimetres above it are bought deliberately. At the floor, three
separate clearances on the carrier sat within 60 microns of their limits *at
the same time* — board to board 2.010, ScreenKey screw to support post 0.509,
Feather pad to peg hole 0.561 — and a first layer running 0.1 mm fat moves all
three together. At 14 they are 4.010, 1.668 and 0.811. Two millimetres of case
width for that is cheap; the last millimetre of width costs every remaining
margin in the part.

`gap_set_block` is 20.00 mm, its own absolute floor, still 1.4× the air inside
the block — the four speech keys go on reading as one group and the set key
goes on reading as not part of it.

**The depth.** The battery lying on the carrier, at z = 31.9, and behind it the
40 mm driver needing 31.7. Nothing else is close — which is the point, because
the Feather used to set this number on its own.

`feather_headroom` is 14.0 mm and it is a requirement, not an allowance: the
cables arrive in black push-on Dupont shells that slide down over the headers
and stand well above them, and they have to go on and come off. What changed is
the *direction* it is needed in. Standing the board on edge turns the shells
sideways, so the 14 mm comes out of the plan instead of the depth.

Worth writing down how that number nearly got lost. It went in as
`extra_above_carrier`, generic "cable headroom" above whatever part happened to
be tallest, and generic allowances are exactly what gets trimmed when somebody
is shrinking a case. It was cut to 6.00, then to 0.00, and each time that looked
like removing slack when it was really taking the connectors' room away. Named
after the thing that needs it, it stops moving by accident.

## The Feather stands on edge

It is not on the carrier any more, it hangs under it, on edge, in a bay in the
top margin. The board runs from the front plate at z = 2.4 up to z = 25.2, so
its 22.8 mm of width is what it occupies in depth — and the connectors point
sideways instead of up.

That last part is the whole trick. Turning the board on the spot buys nothing:
its 22.8 mm width and its 22.0 mm connector stack are the same number, so on
edge it would simply swap them. What buys the depth is getting it out of the
stack above the plate altogether, and that needs somewhere to put it.

The price is plan area — a bay of 50.8 × 22.3 mm that did not exist. It goes in
the **top margin**, which grows from 7.00 to 19.00 (`margin_top`): the block
already left 6 mm of the component rectangle above it, so the case grows 12 mm
on that one edge and loses 15.9 mm of thickness. Nothing else moves. The key
grid is built from board sizes and the two gaps, never from margins, so the
keys, the speaker and the chamber all stay exactly where they were.

Three things fall out of it:

- **The USB-C swaps sides.** The board's length runs along x, so its short edge
  — where the socket is — faces the −x wall, which from the front is the
  child's right. The window turns with it: 10.4 mm tall and 4.6 wide instead of
  the other way round, and low enough (z 13.8) to sit in the thicker wall of
  the board plane rather than above the carrier ledge. `usb_y_shift` then moves
  it 5.00 mm further up that wall — measured on the printed case rather than
  derived.
- **One lid screw moves.** The −x top boss would sit in the bay, so it drops
  down the same wall to just below it, and that corner of the lid is held by
  its neighbours.
- **The amplifier moves** to where the Feather used to lie. That is the only
  piece of carrier left which takes 24.2 × 22.6: the battery fills everything
  to the −x side and the chamber everything above y = 34.49.

### How the board is held, and the one thing still unknown

A bracket hanging off the **underside** of the mid plate: a wall the full
length of the board on the face the connectors do *not* come out of, plus one
clip at the far end wrapping three sides so the board cannot lean away from it.

Two details there are deliberate. The clip is at the far end because the near
end is where the USB socket is. And the bay starts *at* the board rather than a
bracket-wall below it — cut the bay down to the bracket and the bracket hangs
off a 1.7 mm tab at one corner, which is neither strong nor 2-manifold. The
strip of plate below the bay is what it hangs from.

### What the first build changed

Three things came back from the printed parts:

- **The mid plate reaches 2 mm further toward the speaker.**
  `carrier_chamber_gap` goes 2.80 → 0.80. That is the cutout's edge, so no hole
  moves — and 0.80 is still four times the 0.20 that made the very first plate
  run into the chamber wall. A side effect worth knowing: at 0.80 the cutout's
  edge is already past the set key's upper screws, so the tabs that used to be
  kept under them are no longer cut or needed.
- **The USB window moved 5 mm up the wall** — `usb_y_shift`.
- **The bracket's slot went from 2.00 to 5.00 mm**, below.

**The slot is 5.00 mm, not the board plus a little.** That was the first build's
mistake and a plain one: the header pin tails stick out of one face of the
board, and the bracket's long wall is on exactly that face. At 2.00 — board 1.60
plus 0.40 — the Feather would not go in at all. 5.00 leaves 3.40 mm for the
tails.

**Widening it loosens where the board sits, and the socket goes with it.** In a
5.00 mm slot the board can lie anywhere across 3.40 mm. `usb_y_shift` was
measured against the old 2.00 mm slot — the one nothing fitted into — so that
5 mm is owed a re-measurement on the first case a Feather actually goes into.

**`feather_br_clip` is 8.00 mm and it is still the open question.** The clip has to
miss the Feather's header rows, and where those start along the board is the
one figure here taken from a drawing rather than from the board itself.
Dry-fit before printing.

**What can't be shrunk.** The 40 mm driver. It needs 25.3 mm plus 4 mm of
clamping foam, so front plate + driver + foam + lid is **34.7 mm** whatever
happens to the electronics, and its 40.3 mm frame plus the set key below it is
what fixes the 99.4 mm height. Every remaining millimetre of case is the cable
headroom, and that is a number to re-measure rather than reason about.

## The Feather's pins go through the carrier

It used to stand on four 2 mm standoffs on top of the plate. Those standoffs
existed for one reason: to give the header pin tails somewhere to go. Cut a
**well** through the plate under the board and the tails go through it instead,
and the board lies straight on the plate's top face — 2.0 mm lower, top at
z = 31.8 instead of 33.8, just under the battery's 31.9.

It is worth being exact about where the saving comes from, because the first
attempt at this got it wrong in a way that looked right. That version sank the
board *into* the well, resting it on four 1.20 mm pads made of the plate's own
bottom layers. Same 1.9 mm — but it left the M2 three threads of PLA to bite,
and 2.10 mm of hole to bite them in, which is a clearance hole and not a pilot
at all. **The saving was never the sinking. It was deleting the standoff.**

So the pads are ordinary plate, full 2.4 mm thickness — they are what is *left*
of the plate, not something added back to it — and the M2 self-taps into six
threads, which is what the lid bosses already rely on. Pilot `feather_screw_core`
is 1.60, as `sk_boss_core` was.

Three things fall out, and two of them are free:

- **1.9 mm of case.** The Feather stops being the tallest thing behind the
  plate and the battery takes over.
- **It still prints flat, with no support.** The well is a hole and the pads
  are plate. Each pad is hulled out to the edge of the well so it hangs off the
  surrounding plate — a disc on its own in the middle of a cutout is neither
  printable nor connected to anything.
- **The USB-C window drops 2.0 mm**, to z = 27.0, because it is measured off
  the board and the board came down by the height of the standoff. It stays
  above the carrier, so nothing needs notching for it — but the well still has
  to reach the plate edge or the plate stands in front of the socket, and
  `verify.py` checks that it does.

`feather_pad_d` is 4.50 rather than 5.00 on purpose: the nearest header pin is
not far from the corner mounting hole, and the pad has to miss it. **Dry-fit one
Feather before printing the plate** — this is the one dimension here taken from
a drawing rather than from the board.

**`feather_y` is not free.** The well has to pass *between* the set key's two
rows of screw pads, which leave 25.00 mm clear for a 23.40 mm well: 0.8 mm of
play each side. 6.25 sits in the middle of that. At 8.00 — where it sat before
the case was narrowed — the well swallows the set key's two upper screws
outright. That was found by hand and is now an assert, so it cannot come back.

The cable slot that used to run up the gap between the set key and the block is
gone. The well occupies that gap and is a far bigger opening than the slot ever
was; squeezing the slot into the 5 mm of plate left beside it would have left a
rib half a millimetre wide.

## Assembly

The order is not arbitrary — front to back, because each layer holds down the
one beneath it.

1. **Deburr.** Run a finger over all edges once. The front edge has a 1.2 mm
   chamfer, the key cutouts 0.8 mm; if a string is still hanging, remove it.

2. **Speaker into the tub.** From the inside against the front plate, into the
   four guide ribs — they locate it, nothing is screwed. **First put a strip of
   sealing tape or foam between the driver rim and the front plate** —
   otherwise air whistles around the driver and the closed volume is not one.
   Then cut a block of **open-cell** foam to roughly 40 × 40 × 22 mm and lay it
   in behind the magnet: **20.7 mm** of chamber depth are free there, so it goes
   in with a little compression. That block is what holds the driver — the lid
   presses on it in step 10, and you should feel the lid meet the foam before it
   seats. Nothing else holds the driver: no block, and it sits loose in its
   ribs and buzzes on the words that move it, which is how this was found on
   2026-08-31.

   > This step said **8 mm** against 6.7 mm of depth until then, which was the
   > shallower case. The depth trebled when the case grew and the corrected
   > figure was written into *The speaker is not screwed down* above; the step
   > somebody actually builds from was left behind. A block cut to 8 mm is
   > 14 mm short of touching the lid, so it holds nothing at all. Lead the wires out through the passage in the
   chamber wall — it goes through on the amplifier's side of that wall.

3. **Seal the chamber passage.** The cable passage is deliberately generous
   (7 × 5 mm). After threading, close it with hot glue — that is the only
   remaining leak of the chamber.

4. **Five ScreenKeys onto the carrier — outside the case.** This is the step
   that changed. The modules do not go into the tub on their own any more:
   they bolt to the carrier first, on the bench, where you can see what you are
   doing. Each module stands on its own four **8 mm threaded spacers**; the
   carrier lies against the ends of those, and four **M2 × 6 countersunk** per
   key go in from the carrier's back side, heads down into their countersinks.
   Metal thread into metal thread, so these may be pulled up properly — nothing
   printed is being clamped.

5. **Wire it up, still outside the case.** Everything according to
   `docs/hardware.md`. Far easier now than it used to be: the five boards sit
   on a flat plate on the bench instead of in the bottom of a box. Bring the
   cables up through the slots in the carrier as you go, and leave enough slack
   that the 6 mm between board and carrier is where the connectors live.

6. **Lower the carrier assembly into the tub.** All five caps go through their
   cutouts from the inside at once, so bring it down square and take it slowly.
   It comes to rest on the step all round; the two locating pegs it still meets
   keep it from wandering sideways. The caps should stand **9.6 mm** out of the
   front face, 6.6 mm with a key held down. **Check now: does every key press
   cleanly and spring back?** If a key is stiff it is catching on its cutout —
   stop and read [Measure first](#measure-first) below.

7. **Feather into the carrier.** It drops into the well now rather than standing
   on top of the plate: board down onto the four pads in the floor of the well,
   header pin tails through into the space below, USB-C socket out through the
   notch at the plate edge and into the window in the side wall the speaker
   chamber stands against — the same end of the case as the speaker and the set
   key, which from the front is the child's left. The socket has to **reach**
   the wall and not jam in it: side loads on the cable should be taken by the
   wall, not by the soldered socket.

8. **Amplifier.** Into the rib bed on the far side of the chamber wall from
   the speaker, with a strip of double-sided tape. Two screw holes would be
   guesswork as long as the hole positions have not been measured.

9. **Battery.** Flat into the four corner brackets, JST connector to the
   Feather. The battery is **not** glued — it is the part the case can be
   opened for. Do not lay cables under the battery.

10. **Lid on, tighten six M3.** Crosswise and hand tight only. Going down, the
    lid meets the foam block behind the driver first — that resistance is
    expected, it is what clamps the speaker. The lid no longer touches the
    carrier on its way past: there are 24.6 mm above the carrier now, and the
    carrier is held where it is by its step and by the five modules bearing on
    the front plate.

## Measure first

These numbers are assumptions. If they are wrong, the design changes — in part
considerably.

### How far do the caps stand out?

**The number the whole stack now hangs off.** Three measured figures set it and
nothing else does:

| | |
|---|---|
| `sk_total_depth` | 23.0 mm — cap face to the back of the PCB, key not pressed |
| `sk_total_depth_pressed` | 20.0 mm — the same with the key held down, so 3.0 mm of travel |
| `sk_spacer_l` | 8.0 mm — the threaded spacers off the back of the PCB |
| `sk_hole_pitch_x/y` | 20 × 30 mm — where those spacers sit, centre to centre |

The mid plate lies against the ends of those spacers, so the plate sits
23.0 − 9.6 + 8.0 = **21.4 mm** behind the front face, and the caps stand
**9.6 mm** proud — 6.6 mm with a key pressed. That is 1.0 mm further out than
the first build managed with bosses on the front plate, which is exactly the
"too sunken" complaint, fixed by the change rather than tuned away.

If you want them further out or further in, `sk_cap_overhang` is the one
number: the mid plate and its ledge in the tub follow it. `verify.py` refuses
to let the plate and the spacers disagree, and it also refuses a cap that would
sit less than 3 mm proud when pressed — a key a child has to find with a
fingernail is not a key.

### Does the key cap sit centred on the board?

It used to be the biggest open unknown, with a budget of 0.595 mm before the
design started dropping bosses. **That budget no longer exists.** Nothing in
front of the board holds it any more — the module hangs off the mid plate on
its own spacers — so there is nothing an off-centre cap can foul.

The number is still there and still worth measuring:

```
cap_offset_y = 0.00;   // offset of the cap centre, positive = upwards
```

Measure: distance from cap top edge to board top edge, minus distance from cap
bottom edge to board bottom edge, divided by two. Enter it, done — the five
front cutouts and their chamfers move with it and nothing else has to change.

The only limit left is the obvious one: the cap has to stay over its own board.
That leaves roughly 5 mm of room vertically and 2 mm sideways, and `verify.py`
says so if it runs out.

### Where the mounting holes sit

Measured on the module, **20 × 30 mm centre to centre** — not worked out from a
margin off the board edge, which is what the first version did and got wrong by
about a millimetre. It could not have got it right, either: a single margin
cannot describe this pattern. 20 × 30 on a 25.94 × 35.29 board leaves 2.97 mm
at the sides and 2.645 mm top and bottom.

So `sk_hole_pitch_x` and `sk_hole_pitch_y` are the input and the twenty screw
positions follow. Everything they have to clear on the mid plate — cable slots,
lid bosses, support posts, the chamber cutout — got roomier when the real
figures went in, which is the usual sign that a guess had been drifting.

### The remaining assumptions

| Variable | Assumed | Check |
|---|---|---|
| `sk_screw_d` | 2.40 mm | is the spacer thread M2? If it is M2.5, this and `sk_csink_d` both move |
| `sk_screw_engage` | 4.00 mm | how far into the spacer the screw goes — it sets the screw length |
| `sk_hole_d` | 2.20 mm | hole diameter |
| `sk_board_d` | 1.60 mm | board thickness |
| `feather_h` | 8.00 mm | the board with its soldered headers |
| `feather_headroom` | 14.00 mm | **measured.** Clear air the push-on connectors need — sideways, now the board stands |
| `feather_br_clip` | 8.00 mm | how much of the board's far end the clip wraps — it has to miss the header rows |
| `feather_br_l` | 19.00 mm | how far down the bracket grips. Only sets the carrier's build height |
| `usb_overhang` | 1.50 mm | how far does the socket protrude past the board edge? |
| `usb_centre_above_pcb` | 1.60 mm | height of the socket centre above the board |
| `amp_b`, `amp_h` | 19.4 × 17.8 | dimensions of the MAX98357A breakout |
| `spk_hole_diagonal` | 46.20 mm | bolt circle of the speaker — only matters with `spk_front_screws = true` |
| `spk_depth` | 25.30 mm | how deep the driver is; what is left behind it is chamber, and 20.7 mm of that is where the foam block goes |

After measuring, run

```bash
python3 case/verify.py
```

once. Whatever no longer works out shows up as `FAIL` — with actual and target
value, so you can see how far off it is.

## The name and the icon on the front

The top margin the Feather's bay opened up leaves a band above the keys, and
the device's name goes there with the speech bubble beside it — icon first,
then the name, as the child reads them.

```
name_text = "Bente";   // "" for none
```

That is the whole customisation. Everything else follows: `mark_y` is derived
from whatever reaches highest on the face — the key cutouts or the speaker
grille — and the top edge less its chamfer, so the band cannot be got wrong by
moving something else. The pair is centred, and at 18 mm of icon, 6 mm of gap
and a 34 mm name it comes to 52 mm on a face with 123.5 mm of flat.

**Cut in, not raised, and that one is not a choice.** The tub prints front face
down on the bed, so anything standing proud of the front would have to print
below it. Raising these would mean turning the tub over, which makes overhangs
of all five key cutouts and stands the lid bosses in mid air.

**The bubble is an outline here and stays filled on the lid**, and that is
because of the same print orientation. Cutting into the bed-facing face means
the floor of the cut is a bridge — and that floor is exactly the surface you
look at. An outline spans nothing wider than its 1.2 mm stroke. A filled bubble
would have spanned its whole width and sagged in the one place it shows. The
eyes and the smile stay solid: at 18 mm they are already only 2.2 and 1.3 mm
across.

### Two things to know before you change the name

**It needs a font, and that is a real dependency.** `text()` draws with
whatever the machine has. Everything else in this file is hand-built geometry
precisely so that nothing outside it can change the part — the logo is
redrawn from the SVG rather than imported, for exactly this reason. `name_font`
is pinned to make the dependency visible rather than accidental, and it is the
price of a name you can type instead of trace. Set `name_text = ""` and the
`text()` call is skipped entirely: no name, no font, no dependency.

`verify.py` cannot check this. A missing font does not fail — OpenSCAD quietly
substitutes another and renders a different name. The check that *does* work is
`check-stl.py`'s probe on the icon, which is fixed geometry: it proves the marks
were cut at all, and that the bubble came out as an outline rather than filled.

**`name_w` has to be set by hand.** OpenSCAD cannot measure text, so this is
how wide the name comes out — 34.00 mm for "Bente" at size 10 in Helvetica,
measured off a render. It only centres the pair and checks it fits; it does not
scale anything. The echo at the end of a render prints roughly what it should
be, and *roughly* is the word: it assumes 0.68 × size per character, and a name
of narrow letters comes out shorter. Get it wrong by a little and the pair sits
slightly off centre; get it wrong by a lot and the fit check fails.

## The logo

Speech bubble with two eyes and a smile, rebuilt from
[`assets/icon.svg`](../public/icon.svg) — not imported. An `import()` of the
SVG would have tied the file to a second path and silently changed the case
with every change to the icon. Instead the SVG coordinates sit unchanged in the
`.scad` (512 box, y downwards), so a glance at both files is enough to compare.

It sits on the device twice, and it is **cut in** both times:

- **On the lid**, 70 mm wide, **0.8 mm deep** — four layers at 0.2 mm. Less
  than that a worn printer no longer reproduces cleanly; more and it starts
  eating into a 3 mm plate. The floor of the pocket is 0.4 mm narrower than its
  mouth: the same printed chamfer as before, turned over, so the edge is not
  sharp and the pocket only ever widens going up.
- **On the bottom edge**, 20 mm wide, 0.6 mm deep — where the device is picked
  up. That leaves 1.8 mm of the 2.4 mm wall standing.

Raised was the earlier decision, and the case against recessing it was that a
recess in a single colour reads only as a shadow and collects dirt. Both are
still true. What outweighed them is what the raised version cost: the lid is
the back of the device, so a 0.8 mm bubble was the only thing the device stood
on, and it took four printed feet to stop it rocking on its own logo. Cut in,
the device lies flat on all of its back, the feet are unnecessary, and there is
nothing left that can wear through — a shadow that stays a shadow beats an
embossing that rubs off. Feeling it out with a finger works either way; a
groove is as legible to a hand as a ridge.

One word puts it back, and the feet come with it:

```
logo_recessed = false;
feet_on       = true;
```
