Lautstark/vorlaut-diy-talker/firmware/vorlaut/vorlaut.ino

// vorlaut - small talker with five Screenkey buttons
//
// Four keys speak, the fifth switches the set. While the device is awake all
// five displays are on. After the configured idle time it goes into deep
// sleep and wakes on any of the five keys - that first press deliberately
// triggers nothing.
//
// The collection files and the content beside them are produced in the browser
// - renderLayoutBin() in loader/src/layout_format.ts writes the table, and
// either the cable or the folder export puts the lot on the file system. They
// were layout.h and data/, written by build.py, until the Python half went on
// 2026-08-22.
//
// There may be several collections and the menu switches between them, which
// is 2026-08-31 and adr/0021. A device holds one file per collection, reads
// the name out of the head of each and parses only the one it is showing, so
// what it costs to hold a second game is disk and not RAM. A talker carrying a
// single /layout.bin from before that day goes on working, as the one
// collection it has always been.

#include <Arduino.h>
#include <SPI.h>
#include <LittleFS.h>
#include <Adafruit_GFX.h>
#include <Adafruit_ST7735.h>
#include <ESP_I2S.h>
// Where the volume is kept. The only thing in NVS - see volumeNow below.
#include <Preferences.h>
#include <driver/rtc_io.h>
#include <driver/gpio.h>
#include <esp_sleep.h>

// --- Display ----------------------------------------------------------------
// The image files contain the symbol area only; the border in the set colour
// is drawn by the firmware itself.
#define DISPLAY_W 128
#define DISPLAY_H 128
// The menu draws its own frame; the talker's tiles have none, and fill the
// display edge to edge. TILE_W and TILE_H are what is left of a tile that used
// to be the square inside a border - the file is the whole panel now.
#define MENU_BORDER 6

// TILE_W and TILE_H were two more #defines here, which is the reason nothing
// ever compared them with the browser's TILE_SIZE: a number in a .ino is a
// number no test can include. They are in a header of their own now and the
// two ends are held against device/fixtures/tile/ from either side.
#include "tile_format.h"
static_assert(TILE_W == DISPLAY_W && TILE_H == DISPLAY_H,
              "a tile file is the whole panel - see tile_format.h");

// --- Structure of the content ------------------------------------------------
// How many sets there are and which file belongs to which key is NOT in the
// firmware but in a collection file on the file system. Otherwise a new set
// would have to be flashed over a cable.
//
// Structure and read logic live in layout_format.h - the same file gets
// compiled on the computer by tests/test_layout_frozen.py and checked against
// a real layout.bin. That was tests/test_layout_format.py's job until
// 2026-08-22; what changed with it is what the bytes are compared against, not
// that this reader parses them.
#include "layout_format.h"

// And which of the files on the device are collections, what each of them is
// called, and which one is showing. A collection is one layout.bin under a
// name of its own, so nothing about the FORMAT changed for this - what arrived
// is the three questions that only exist once there is more than one of them.
// In a header for the same reason the strides are, and adr/0021 is the
// decision.
#include "collections.h"

// And what the device DOES with a key, which is the other half of version 3
// and was missing until 2026-08-31: keyPress(), the hold times, and the
// ordered steps between a key that goes somewhere and the board it goes to.
// In a header for the reason the strides are - a number in a .ino is a number
// no test can include - and held by device/fixtures/ from both ends.
#include "key_press.h"

// hashPath(), which turns a slot's sixteen bytes into the file to open. It
// was here as a static function, which is why the one rule stated in three
// places had nothing holding the three together.
#include "name_format.h"

#include "pins.h"

// The file's five keys and the device's five buttons are the same five, in the
// same order. Two headers say so separately - SLOT_COUNT + 1 in the format,
// five wired panels in pins.h - and nothing was holding them together.
static_assert(DISPLAY_COUNT == KEY_COUNT,
              "one panel per key of a set - see layout_format.h");
static_assert(SET_BUTTON == SET_KEY_INDEX,
              "the set key is the fifth in the file and the fifth on the "
              "board - see key_press.h");

// Everything the device shows in words, and the way it gets onto a panel
// that only knows code page 437.
#include "texts.h"
#include "panel_text.h"

// What counts as a recording, and where its samples start. seekToWavData()
// used to be further down this file, which meant the acceptor and the format
// were the same thing and neither could be asked about on its own.
#include "wav_format.h"

// And how to read the compressed one. A recording is a WAV either way - IMA
// ADPCM is WAVE format tag 0x11 - so this is a second codec behind the same
// acceptor rather than a second kind of file. adr/0022.
#include "adpcm_format.h"

// --- Fetching content over the cable ----------------------------------------
//
// The editor is a page with no server behind it, and a tab cannot be something
// the device fetches from. So the browser pushes instead, down the USB-C cable
// the device is charged through anyway - docs/cable.md.
//
// It is the only way in. There was a Wi-Fi path here - the device found a
// server with a UDP broadcast, proved itself with five digits on the displays,
// and pulled a manifest - and it is gone, along with the radio, the captive
// portal, the stored networks and the key in NVS. What decided it was not the
// cable being better: it was that the server half went with app.py, so the
// device was carrying a stack that had nothing left to talk to.
#include "cable.h"


// --- Behaviour ---------------------------------------------------------------

// How long the MAX98357A gets between SD going high and the first sample.
// 5 ms was a guess and audibly too short - the start of every word arrived
// while the amplifier was still coming up. 50 ms is inaudible as latency and
// well past its settling time.
static const uint32_t AMP_WAKE_MS = 50;

// DEBOUNCE_MS and SET_HOLD_MS were two more numbers here. They are in
// key_press.h with the two that were added beside them - the pause after a
// word and the stretch of deafness after a board change - because all four are
// one question ("how much accidental switching is too much") and one of them
// having a test while the other three did not is how they would drift apart.
// The menu is reached only by two keys at once, held for five seconds. Those
// two sit diagonally furthest apart - hard to hit with a child's hand. While
// holding, a countdown runs; letting go cancels it.
static const uint32_t MENU_HOLD_MS = 5000;
static const uint8_t MENU_KEY_A = SET_BUTTON;   // the set key
static const uint8_t MENU_KEY_B = 1;            // key 2, diagonally opposite
// Back to normal operation without input. A device stuck in the menu no
// longer speaks - that must not happen.
static const uint32_t MENU_IDLE_MS = 30000;
// The rate the build writes the WAVs at. In wav_format.h with the rest of
// what a recording is, rather than as a literal here.
static const uint32_t SAMPLE_RATE = WAV_SAMPLE_RATE;
static const size_t AUDIO_CHUNK = 1024;

// A whole word, held in RAM before a single sample of it is played.
//
// The reason is timing, not tidiness. Streaming a word meant one LittleFS read
// of AUDIO_CHUNK every 32 ms for the length of the word, with nothing read
// ahead; a read that takes longer than that leaves the I2S DMA with nothing to
// send, and a starved stream is the crackle this repository has already
// written down once - "the click is the I2S stream running dry", bring-up
// stage 5. Streaming worked on a fresh file system and turned the same key
// into a lottery on a full one: 92% full when this was noticed, where LittleFS
// does markedly more work per read and how much varies with where the blocks
// sit.
//
// So the read happens once, up front, and it costs nothing in latency because
// it happens inside the wait the amplifier needs anyway - see playWav().
//
// 48 KiB is 1.5 seconds at 16 kHz, against the longest word in the collection
// this was measured on at 1058 ms. Anything longer still plays, streamed the
// old way: a rule that silently refused to say a long sentence would be far
// worse than one that says it with the old timing.
static const size_t AUDIO_PRELOAD = 49152;
static uint8_t spoken[AUDIO_PRELOAD];

// How loud, as a percentage of what is in the file.
//
// The only volume control this device has, and it is here rather than on the
// amplifier because there is nowhere else for it: the MAX98357A's GAIN pin is
// strapped on the board, not wired to a GPIO, so nothing in software can move
// it. What is left is the samples themselves, scaled on their way past in
// playWav() - which costs one multiply per sample at 16 kHz and is not
// measurable beside a read from LittleFS.
//
// 50 is half the amplitude, about 6 dB down. **This is only where a device
// starts**: the menu has leiser and lauter on a screen of its own, what they
// set is kept in NVS, and this is what a device that has never been told
// anything uses - a fresh flash, or one whose stored setting could not be
// read. 100 is exactly what the device did before this existed, and the
// scaling is written so that 100 leaves every sample untouched.
//
// It is deliberately not settable from a layout. That would put a volume in
// layout.bin, which means a field in the format, a control in the editor -
// which lives in another repository - and a version of the device interface,
// for something the person holding the talker should be able to change in the
// room they are in. The menu is where that belongs - one screen down from the
// screen it opens on, see drawVolume() - and it needs no format at all.
//
// The default can still be moved without editing this line, the same way
// FORCE_SLEEP_S is:
//
//   arduino-cli compile --build-property \
//     "compiler.cpp.extra_flags=-DAUDIO_VOLUME_PERCENT=35" ...
#ifndef AUDIO_VOLUME_PERCENT
#define AUDIO_VOLUME_PERCENT 50
#endif

// The range the two volume keys move in, and the step they move by.
//
// Ten steps, and the bottom one is not silence. A talker that says nothing is
// indistinguishable from a broken one - the whole device is five keys that
// speak - so the quietest setting is still audible in a quiet room, and
// somebody who wants silence has a device they can put down. 100 is the top
// because the samples are what they are: there is no headroom above the file.
static const uint8_t VOLUME_MIN = 10;
static const uint8_t VOLUME_MAX = 100;
static const uint8_t VOLUME_STEP = 10;
// Chunks of silence pushed after a word, before the amplifier is switched
// off. 1024 bytes is 512 samples, so at 16 kHz each of these is 32 ms.
static const uint8_t AUDIO_TAIL_CHUNKS = 3;

// --- Zustand -----------------------------------------------------------------

// setColRowStart is protected in the library. This subclass makes the panel
// offset reachable without touching the library.
class Panel : public Adafruit_ST7735 {
 public:
  using Adafruit_ST7735::Adafruit_ST7735;
  void setOffsets(int8_t col, int8_t row) { setColRowStart(col, row); }

  // Everything initR() would have left behind, without initR().
  //
  // For a panel that is already initialised and was never switched off, the
  // init sequence is 760 ms of waiting for nothing: 150 for a software reset,
  // 500 for sleep-out, 10 and 100 for the display coming on. Five panels, one
  // after another, is 3.8 seconds - which was nearly all of the 4.3 the device
  // took to wake, and long enough that a press made into it got thrown away
  // and looked like a device that had not heard.
  //
  // What the panel needs is nothing. What the *driver object* needs is the
  // state initR() computes, and the library keeps the one field it hangs on -
  // tabcolor - private, so there is no way to hand it over. This is
  // Adafruit_ST7735::setRotation() for INITR_144GREENTAB, written out.
  //
  // It is a copy of somebody else's arithmetic and will not follow them if
  // they change it. The check is the screen: wrong here and the picture is
  // visibly offset or mirrored, which is not a subtle failure.
  void adoptAwake(uint8_t turn) {
    // The SPI half of what initR() does, which is the half that is not about
    // the panel at all: the clock frequency and initSPI(). Skipping it cost
    // seventeen seconds of drawing five screens through an unconfigured bus -
    // four times slower than the init this was meant to avoid. It sends the
    // panel nothing, so it is free.
    begin();

    rotation = turn & 3;
    WIDTH = HEIGHT = 128;
    _width = _height = 128;
    _colstart = PANEL_COL_OFFSET;
    _rowstart = (rotation < 2) ? 3 : 1;   // the 128 panel's own rule
    if (rotation & 1) { _xstart = _rowstart; _ystart = _colstart; }
    else              { _xstart = _colstart; _ystart = _rowstart; }

    uint8_t madctl;
    switch (rotation) {
      case 1:  madctl = ST77XX_MADCTL_MY | ST77XX_MADCTL_MV | ST7735_MADCTL_BGR; break;
      case 2:  madctl = ST7735_MADCTL_BGR; break;
      case 3:  madctl = ST77XX_MADCTL_MX | ST77XX_MADCTL_MV | ST7735_MADCTL_BGR; break;
      default: madctl = ST77XX_MADCTL_MX | ST77XX_MADCTL_MY | ST7735_MADCTL_BGR;
    }
    sendCommand(ST77XX_MADCTL, &madctl, 1);
    cp437(true);
  }
};

static Layout layout;

// Survives deep sleep: she should wake up in the same set.
RTC_DATA_ATTR static uint8_t rtcCurrentSet = 0;

static Panel *display[DISPLAY_COUNT];
static I2SClass i2s;

struct ButtonState {
  uint32_t downSince;  // 0 = not pressed
  bool reported;       // this press has already been handled
};
static ButtonState button[DISPLAY_COUNT];

static uint32_t lastActivity = 0;
static bool filesystemReady = false;
static bool contentReady = true;

// How loud this device is, right now, as a percentage of the file.
//
// In NVS rather than on LittleFS, and that is the whole reason Preferences is
// back in this sketch after the radio took it away. LittleFS is the browser's
// half: the cable lists it, diffs it and deletes out of it, and a setting
// living there would be one more thing to teach that sweep about. NVS is a
// partition nothing else in this repository touches, it survives a content
// transfer, and it is wiped by the one thing that should wipe it - the whole
// image, written at 0, which is what a brand new talker gets.
static Preferences settings;
static uint8_t volumeNow = AUDIO_VOLUME_PERCENT;

// What the device holds, and which of it is showing.
//
// The names and the file names only - collections.h is where the economy of
// that is written down. Which one is active is kept in NVS beside the volume
// and for the same reason the comment on AUDIO_VOLUME_PERCENT gives: it is
// something the person in the room should be able to change, and therefore not
// a field in a format. A collection that says which collection is showing
// would be a file that has to be rewritten to answer a key press.
static Collections held;
static char activeFile[COLLECTION_FILE_CHARS + 1] = "";

enum Mode {
  MODE_NORMAL,
  MODE_MENU,        // the way to the two below it, and nothing else
  MODE_VOLUME,      // how loud, on a screen of its own
  MODE_COLLECTIONS, // which collection - and, on an empty device, why not
};
static Mode mode = MODE_NORMAL;
static uint32_t menuSince = 0;
static uint32_t comboSince = 0;   // since when both menu keys have been held
static int8_t countdownShown = -1;
// Which screenful of collection names is up. Only ever non-zero where there
// are more than four of them - see collectionsPerPage().
static uint8_t collectionPage = 0;

// --- Loading the content -----------------------------------------------------------

// Reads one collection file and hands it to parseLayout from layout_format.h.
// If the file is missing or does not fit, there simply is no content - that is
// not an error but the state after the first flash.
//
// **One at a time, and that is the whole reason a device can hold sixteen.**
// The buffer below is LAYOUT_MAX_BYTES and there is one of it; what holding
// another collection costs is a name and a file name in `held`, not a second
// 13580 bytes. Parsing every collection at boot would have put the count into
// SRAM, where 64 sets already sit.
static bool loadLayout(const char *file) {
  if (!filesystemReady || !file || !*file) return false;
  char path[1 + COLLECTION_FILE_CHARS + 1];
  snprintf(path, sizeof(path), "/%s", file);
  File handle = LittleFS.open(path, "r");
  if (!handle) {
    Serial.printf("%s missing - no content on the device yet.\n", path);
    return false;
  }
  static uint8_t buffer[LAYOUT_MAX_BYTES];
  const size_t got = handle.read(buffer, sizeof(buffer));
  handle.close();

  const LayoutResult result = parseLayout(buffer, (uint32_t)got, layout);
  if (result != LAYOUT_OK) {
    Serial.printf("%s unusable (reason %d, %u bytes)\n",
                  path, (int)result, (unsigned)got);
    return false;
  }
  // From here on the device talks in the language the content asks for.
  setLanguage(layout.language);
  Serial.printf("%s: %u set(s), language %u, sleep %u s\n",
                path, layout.setCount, layout.language, layout.sleepSeconds);
  return layout.setCount > 0;
}

/** Every collection on the file system, in the order the menu lists them.
 *
 * The head of each file and nothing more - COLLECTION_HEAD_BYTES is 44 bytes,
 * which is the twelve of the header and the first set's name after it. What a
 * collection is CALLED is a question the whole file does not have to be read to
 * answer, and that is what keeps this a directory walk.
 *
 * Every decision here is in collections.h so that a test can make the same
 * ones: which names are collections, which heads are readable, and what order
 * they come out in. This function is the part that needs LittleFS. */
/** Every file in the root, looked at once. The slow way, and the true one.
 *
 * The cost here is the directory walk, not the reads: openNextFile() is a
 * lookup per file on the partition, and the partition holds a tile and a
 * recording for every key of every collection. It is hundreds of files on a
 * device somebody actually uses, and all of it happens in setup() with the
 * backlight deliberately off - which is to say inside the gap between a
 * child's press and a picture. scanCollections() is what keeps it off the
 * ordinary wake. */
static void walkCollections() {
  collectionsClear(held);
  if (!filesystemReady) return;
  File dir = LittleFS.open("/");
  if (!dir) return;
  for (File entry = dir.openNextFile(); entry; entry = dir.openNextFile()) {
    if (entry.isDirectory()) continue;
    const char *name = entry.name();
    if (name && name[0] == '/') name++;   // LittleFS is not consistent about it
    if (collectionKind(name) == COLLECTION_NOT) continue;
    uint8_t head[COLLECTION_HEAD_BYTES];
    const int got = entry.read(head, sizeof(head));
    collectionsOffer(held, name, head, got > 0 ? (uint32_t)got : 0);
  }
  dir.close();
  sayCollections("walked");
}

/** The list, from the cache where there is one and from the partition where
 *  there is not. Everything that wants the list calls this. */
static void scanCollections() {
  if (loadCollectionsCache()) return;
  walkCollections();
  saveCollectionsCache();
}

/** The collection the device shows, and the content read in from it.
 *
 * The one that was asked for where it is still there, the first one where it
 * is not, and nothing at all where there are none. Falling back is said out
 * loud on the serial port and is deliberately not written back to NVS - see
 * collectionsChoose(). */
static bool openActive() {
  const CollectionChoice choice = collectionsChoose(held, activeFile);
  if (choice == COLLECTION_NOTHING) {
    Serial.println("no collection on the device.");
    return false;
  }
  if (choice == COLLECTION_FELL_BACK && activeFile[0]) {
    Serial.printf("%s is not here any more - showing %s instead\n",
                  activeFile, held.at[held.active].file);
  }
  return loadLayout(held.at[held.active].file);
}

// --- Displays ----------------------------------------------------------------

// stillAwake: the panels kept their power, their registers and their picture
// through the sleep, because goToSleep() held CS high on all five and RST high
// as well, so the floating bus could not reach them. Then there is nothing to
// initialise and nothing to wait for - only the driver objects to tell.
static void setupDisplays(bool stillAwake) {
  if (stillAwake) {
    SPI.begin(PIN_SCK, -1, PIN_MOSI, -1);
    for (uint8_t i = 0; i < DISPLAY_COUNT; i++) {
      pinMode(PIN_CS[i], OUTPUT);
      digitalWrite(PIN_CS[i], HIGH);
      display[i] = new Panel(&SPI, PIN_CS[i], PIN_DC, -1);
      display[i]->adoptAwake(PANEL_TURN[i]);
    }

    // goToSleep() sent DISPOFF and SLPIN, and holding the pins kept that
    // faithfully - the panels are off because they were told to be. Waking
    // them is two commands and two waits, and the waits are the panel
    // settling rather than the bus: send to all five first, then wait once.
    // That is 600 ms for five instead of 600 ms each, which is the whole
    // trick the library cannot do because it only ever knows about one panel.
    for (uint8_t i = 0; i < DISPLAY_COUNT; i++) {
      display[i]->sendCommand(ST77XX_SLPOUT);
    }
    delay(120);   // datasheet wants 120 ms before the next command
    for (uint8_t i = 0; i < DISPLAY_COUNT; i++) {
      display[i]->sendCommand(ST77XX_DISPON);
    }
    delay(100);
    return;
  }

  // RST is common to all five panels. So pulse it once by hand and hand the
  // drivers -1 - otherwise initialising display 3 would reset displays 1 and
  // 2 again.
  pinMode(PIN_RST, OUTPUT);
  digitalWrite(PIN_RST, HIGH);
  delay(10);
  digitalWrite(PIN_RST, LOW);
  delay(20);
  digitalWrite(PIN_RST, HIGH);
  delay(150);

  // Every select high before any panel is spoken to, which is what the waking
  // path above has always done and this one never did.
  //
  // A panel's CS becomes an output when its Panel is constructed, and the five
  // are constructed one at a time inside the loop below - so while display 1
  // is being initialised, four selects are still inputs. A floating select is
  // not a deselected one: it reads as whatever the pin happens to sit at, and
  // a panel that reads it low takes its neighbour's initialisation as its own.
  //
  // What that looked like, 2026-08-31, on the assembled talker: keys 2 and 3
  // came up rotated half a turn after a flash and were right again after the
  // first sleep and wake. That is the difference between these two paths and
  // nothing else - the rotation table is the same for both, and the library's
  // setRotation() and adoptAwake() were held against each other and compute
  // the same MADCTL, byte for byte, for this panel.
  for (uint8_t i = 0; i < DISPLAY_COUNT; i++) {
    pinMode(PIN_CS[i], OUTPUT);
    digitalWrite(PIN_CS[i], HIGH);
  }

  SPI.begin(PIN_SCK, -1, PIN_MOSI, -1);

  for (uint8_t i = 0; i < DISPLAY_COUNT; i++) {
    display[i] = new Panel(&SPI, PIN_CS[i], PIN_DC, -1);
    display[i]->initR(PANEL_INITR);  // 128x128, settled in stage 2
    display[i]->invertDisplay(PANEL_INVERT);  // IPS panels, settled in stage 2
    display[i]->setOffsets(PANEL_COL_OFFSET, PANEL_ROW_OFFSET);
    display[i]->setRotation(PANEL_TURN[i]);
    // Without this the font treats bytes above 0x7F as a legacy special case
    // and draws the wrong glyph. With it they are code page 437, which is
    // what panel_text.h converts to.
    display[i]->cp437(true);
    display[i]->fillScreen(ST77XX_BLACK);
  }
}

// Draws the whole display from the file (DISPLAY_W x DISPLAY_H, RGB565
// big-endian).
//
// There were six pixels of border round a smaller tile. They were the set's
// colour, drawn here rather than baked into the file so that one symbol was
// one file across differently coloured sets; the colour went, they were being
// blacked out for nothing, and a symbol has them now - about a tenth wider in
// each direction on a key 15.21 mm across.
//
// Nothing is cleared first any more, and that is the point of a tile that
// reaches the edge: it covers whatever was on the panel, including the grey
// frame drawMenuKey() leaves behind. The only case that still clears is a file
// that will not open, below.
static void drawTile(Panel *tft, const char *path) {
  static uint16_t line[TILE_W];

  File file = (filesystemReady && path) ? LittleFS.open(path, "r") : File();
  if (!file) {
    if (path) Serial.printf("missing: %s\n", path);
    tft->fillScreen(ST77XX_BLACK);
    return;
  }

  // Which of the two forms this is, and the palette if it is the compressed
  // one. Static because it holds a 256-colour palette and a read buffer, and
  // one tile is drawn at a time.
  static TileStream stream;
  if (!tileBegin(file, (uint32_t)file.size(), stream)) {
    // Neither form: not TILE_BYTES long and not carrying the magic. Black,
    // which is what a file that will not open draws - see tile_format.h.
    Serial.printf("not a tile: %s\n", path);
    tft->fillScreen(ST77XX_BLACK);
    file.close();
    return;
  }

  tft->startWrite();
  tft->setAddrWindow(0, 0, TILE_W, TILE_H);
  for (uint16_t y = 0; y < TILE_H; y++) {
    // Short rows come back filled with black, and nothing is said about it -
    // see tileNextRow() in tile_format.h and device/fixtures/tile/short.
    tileNextRow(file, stream, (uint8_t *)line);
    // bigEndian = true: the bytes go out exactly as they stand in the file.
    // The build already writes them in panel order, and the decoder puts the
    // compressed form back into that same order.
    tft->writePixels(line, TILE_W, true, true);
  }
  tft->endWrite();
  file.close();
}

// Two lines centred on a display, without a file. For states where there is
// nothing to show yet - at the very first start for instance, when the
// firmware is on but no content is.
// Two lines, each centred. Both go through toPanelText: it hands back the
// bytes the font draws and the number of glyphs, and the glyphs are what the
// centring has to count. Counting bytes would push every line with an umlaut
// in it off to the left.
static void drawTwoLines(Panel *tft, const char *first, const char *second,
                         int16_t width, uint8_t size) {
  const int16_t glyphW = 6 * size, glyphH = 8 * size;
  char panel[MENU_MAX_CHARS * 2 + 1];
  tft->setTextColor(ST77XX_WHITE);
  tft->setTextSize(size);
  for (uint8_t i = 0; i < 2; i++) {
    const char *line = i == 0 ? first : second;
    if (!line || !*line) continue;
    const uint8_t glyphs = toPanelText(line, panel, sizeof(panel));
    tft->setCursor((width - (int16_t)glyphs * glyphW) / 2,
                   DISPLAY_H / 2 - glyphH + i * (glyphH + 4));
    tft->print(panel);
  }
}

static void drawMessage(Panel *tft, const char *first, const char *second) {
  tft->fillScreen(ST77XX_BLACK);
  drawTwoLines(tft, first, second, DISPLAY_W, 2);
}

// All five displays with the same notice, so it cannot be missed.
static void showNoContent() {
  for (uint8_t i = 0; i < DISPLAY_COUNT; i++) {
    drawMessage(display[i], text().empty1, text().empty2);
  }
  Serial.println("No content on the device.");
  Serial.println("  Build and upload it - see docs/firmware.md");
}

static void drawCurrentSet() {
  if (!contentReady) {
    showNoContent();
    return;
  }
  const SetEntry &e = layout.sets[rtcCurrentSet];
  char path[2 + HASH_BYTES * 2 + 5];
  for (uint8_t i = 0; i < SLOT_COUNT && i < DISPLAY_COUNT - 1; i++) {
    hashPath(path, 't', e.slots[i].image, ".bin");
    drawTile(display[i], path);
  }
  hashPath(path, 't', e.key.image, ".bin");
  drawTile(display[SET_BUTTON], path);
  Serial.printf("set %u: %s\n", (unsigned)(rtcCurrentSet + 1), e.name);
}

// --- Menu --------------------------------------------------------------------
//
// Deliberately without files: text and frame are drawn. That way the menu
// works on a freshly flashed device with nothing on it yet - and that is
// exactly where it is needed first.
//
// A grey frame, where a talker key has none: one sees at a glance that this is
// not the talker. It used to be grey against the set's colour, and the
// distinction is if anything plainer now - a frame against no frame.
static const uint16_t MENU_FRAME = 0x8410;   // mid grey in RGB565

// The one that is showing, marked as quietly as anything on this device is
// marked. A brighter frame and not a character in front of the name: the menu
// already tells itself apart from the talker by a frame against no frame, so a
// frame against a duller frame is the same language said again, and a name has
// nine characters to be recognised in without one of them being a dot.
static const uint16_t MENU_FRAME_ACTIVE = ST77XX_WHITE;

static void drawMenuKey(Panel *tft, const char *first, const char *second,
                        uint16_t frame = MENU_FRAME) {
  const int16_t inner = DISPLAY_H - 2 * MENU_BORDER;
  tft->fillRect(0, 0, DISPLAY_W, MENU_BORDER, frame);
  tft->fillRect(0, DISPLAY_H - MENU_BORDER, DISPLAY_W, MENU_BORDER, frame);
  tft->fillRect(0, MENU_BORDER, MENU_BORDER, inner, frame);
  tft->fillRect(DISPLAY_W - MENU_BORDER, MENU_BORDER, MENU_BORDER, inner,
                frame);
  tft->fillRect(MENU_BORDER, MENU_BORDER, DISPLAY_W - 2 * MENU_BORDER, inner,
                ST77XX_BLACK);
  if (!first && !second) return;   // a key with nothing behind it stays dark

  drawTwoLines(tft, first, second, DISPLAY_W, 2);
}

// Only show what actually exists. Entries appear once the function behind
// them exists - not before.
//
// **Nothing on this screen changes anything. Every live key on it leads
// somewhere.** The volume and the collections, one key each, a screen apiece
// below - and two keys standing dark, because there is no third thing yet.
// Fetching content, setting up Wi-Fi and pairing were keys 1 to 3 once, and
// all three went with the radio.
//
// The volume used to be right here, three keys of it, and the reason written
// down beside it was that it is the one thing in the menu somebody presses
// more than once. That reason is still true and the decision is reversed
// anyway, because it was the wrong thing to weigh. **A first screen that
// carries controls of its own does not grow.** This one was already full at
// two things, so whatever came third would have had to go a level down, and
// then some of what the menu does would sit above and some below with no rule
// anybody could see from the outside. A screen per thing scales. One more
// press for the volume is what that costs, and two dark keys are what it looks
// like until the third thing arrives.
//
// Info was key 1 and is not a key any more. Its job was to tell a device with
// no content from a device with no file system, and that is exactly what the
// collection screen says when it has no names to show - see drawCollections().
static void drawMenu() {
  drawMenuKey(display[0], text().volume, nullptr);
  drawMenuKey(display[1], text().collections, nullptr);
  drawMenuKey(display[2], nullptr, nullptr);
  drawMenuKey(display[3], nullptr, nullptr);
  drawMenuKey(display[SET_BUTTON], text().back, nullptr);
}

/** How loud, and the two keys that move it.
 *
 * **The pair either side of the number are a control somebody can read** rather
 * than two keys that do something invisible, and the number is on the same
 * screen as the keys that move it on purpose: somebody making a device quieter
 * is listening, not navigating. None of that changed when this stopped being
 * the screen the menu opens on - only the way in did.
 *
 * The fourth key stays dark. There is no fourth thing the volume needs, and a
 * key borrowed from the screen above to fill the gap would put one thing in two
 * places. */
static void drawVolume() {
  char percent[8];
  snprintf(percent, sizeof(percent), "%u%%", (unsigned)volumeNow);
  drawMenuKey(display[0], text().quieter, nullptr);
  drawMenuKey(display[1], text().volume, percent);
  drawMenuKey(display[2], text().louder, nullptr);
  drawMenuKey(display[3], nullptr, nullptr);
  drawMenuKey(display[SET_BUTTON], text().back, nullptr);
}

// --- All five at once --------------------------------------------------------
//
// A transfer takes seconds, and a device that looks switched off during them
// invites a second press. So every display says the same thing while one runs.

// Defined further down with the other key handling. Needed up here because a
// transfer has to be interruptible while it is running.
static bool isDown(uint8_t index);
static int8_t pollButtons();

// A key pressed while a word was playing. playWav() blocks for the length of
// the word, and nothing read the buttons during it - so on real hardware four
// presses in ten simply never happened. Not because they were too quick or
// too weak: the device was inside playWav() and deaf.
//
// Interrupting the word was tried and was worse; dropping the press is what
// made a third of them do nothing. So it is remembered instead, and spoken
// when the word it arrived during has finished. One press, not a queue: after
// several the last one is what she still means.
static int8_t pendingKey = -1;

// How long setup() took, said later. Saying it at the end of setup() stopped
// working the moment setup() got quick: on the S3's native USB the port is not
// enumerated for the first second or so, and a line printed before that is
// simply gone. The measurement had become too good to report itself.
static uint32_t t_displays = 0, t_audio = 0, t_littlefs = 0;
static uint32_t t_layout = 0, t_drawn = 0;
static uint32_t readyMs = 0;
static bool wokeUp = false;
static bool readySaid = false;

static void showOnAll(const char *first, const char *second) {
  for (uint8_t i = 0; i < DISPLAY_COUNT; i++) {
    drawMenuKey(display[i], first, second);
  }
}

// --- The cable ----------------------------------------------------------
//
// Nothing has to be chosen in the menu for this. The browser starts talking
// and the device answers, which is the whole point: the five digits that used
// to prove somebody was standing in front of the device were needed because a
// network is shared, and whoever has hold of the cable is standing in front of
// it already.

static void cableProgress(const char *what, uint16_t done, uint32_t bytes) {
  (void)bytes;
  char count[12];
  snprintf(count, sizeof(count), "%u", done);
  if (strcmp(what, "hello") == 0) {
    // Before anything can be written, rather than when something is. The
    // browser may be about to add a collection or take one away, and the
    // window between the partition changing and NVS being told must not
    // contain a cache that is confidently wrong - so it contains no cache.
    // The end of the session puts one back.
    forgetCollectionsCache();
    // All five, so it is obvious at a glance that this is not the talker and
    // that the keys are not going to say anything for a moment.
    showOnAll(text().cable, nullptr);
  } else if (strcmp(what, "done") == 0) {
    showOnAll(text().done, count);
  } else {
    showOnAll(text().cable, count);
  }
}

// The way out. A transfer that has to be stopped is stopped here, not by
// pulling the plug - a half-written file left behind by a cable coming out is
// exactly what the .part rule is there to survive, but it should not be the
// normal way to say no.
static bool cableAbort() {
  return isDown(SET_BUTTON);
}

/**
 * Which collection, and - on a device that has none - why not.
 *
 * **The diagnosis is this screen's empty state rather than a screen of its
 * own.** Info used to be a key here, and what it was for is written down in
 * docs/bring-up.md, stage 7: a talker with five black keys is either a device
 * with no content on it or a device whose file system will not mount, and those
 * two look identical from the outside and are answered completely differently.
 * A device with no collections has no names to draw and four keys standing
 * empty, which is exactly the room that sentence needs - so the screen that
 * lists collections is also the screen that says there are none and what the
 * file system is doing. One screen, one press, and nothing lost.
 *
 * Free space is on it because a person looking at this is deciding whether
 * something will fit, and because the number was already being fetched and
 * written only to Serial.
 */
static void drawCollections() {
  if (held.count == 0) {
    char free[12];
    snprintf(free, sizeof(free), "%u",
             (unsigned)(filesystemReady
                            ? (LittleFS.totalBytes() - LittleFS.usedBytes()) / 1024
                            : 0));
    drawMenuKey(display[0], text().storage1, text().storage2);
    drawMenuKey(display[1],
                filesystemReady ? text().storagePresent : text().storageMissing,
                nullptr);
    drawMenuKey(display[2], text().free1, text().free2);
    drawMenuKey(display[3], free, nullptr);
    drawMenuKey(display[SET_BUTTON], text().back, nullptr);
    if (filesystemReady) {
      Serial.printf("LittleFS: %u of %u bytes used, no collection on it\n",
                    (unsigned)LittleFS.usedBytes(),
                    (unsigned)LittleFS.totalBytes());
    } else {
      Serial.println("LittleFS is not mounted - see docs/bring-up.md stage 7.");
    }
    return;
  }

  const bool paging = collectionsPaging(held.count);
  for (uint8_t key = 0; key < COLLECTION_KEYS; key++) {
    if (paging && key == COLLECTION_KEYS - 1) {
      drawMenuKey(display[key], text().next, nullptr);
      continue;
    }
    const int8_t at = collectionsOnPage(held.count, collectionPage, key);
    if (at < 0) {
      drawMenuKey(display[key], nullptr, nullptr);
      continue;
    }
    char first[MENU_LINE_BYTES], second[MENU_LINE_BYTES];
    collectionMenuLines(held.at[at].name, first, second);
    drawMenuKey(display[key], first, second,
                (uint8_t)at == held.active ? MENU_FRAME_ACTIVE : MENU_FRAME);
  }
  drawMenuKey(display[SET_BUTTON], text().back, nullptr);
  Serial.printf("collections: page %u of %u, showing %s\n",
                (unsigned)(collectionPage + 1),
                (unsigned)collectionsPages(held.count),
                held.at[held.active].file);
}

/** One step, kept, and heard.
 *
 * Three things in that order and none of them optional. The number on the
 * screen is what somebody is looking at; NVS is what makes the setting outlast
 * the next sleep, which is minutes away; and the note is the only way to tell
 * whether the step went far enough, on a device that may be holding no words
 * at all yet.
 *
 * At either end nothing is written and nothing is saved, but the note still
 * plays: pressing quieter at the quietest setting should sound like the
 * quietest setting rather than like a key that has stopped working. */
static void changeVolume(int8_t by) {
  const int16_t asked = (int16_t)volumeNow + by;
  const uint8_t next = (uint8_t)(asked < VOLUME_MIN ? VOLUME_MIN
                                 : asked > VOLUME_MAX ? VOLUME_MAX : asked);
  if (next != volumeNow) {
    volumeNow = next;
    saveVolume();
    Serial.printf("volume: %u%%\n", (unsigned)volumeNow);
  }
  drawVolume();
  playTone();
}

/** Whatever mode the device is in, on the panels.
 *
 * One function rather than the `mode == MODE_MENU ? drawMenu() : drawCurrentSet()`
 * that stood in four places. It was already the sort of line that gets forgotten
 * in the fifth place, and a second menu screen would have made every one of the
 * four wrong instead of merely repetitive. There are three of them now, which
 * is the same argument again with a bigger number. */
static void redraw() {
  switch (mode) {
    case MODE_MENU: drawMenu(); break;
    case MODE_VOLUME: drawVolume(); break;
    case MODE_COLLECTIONS: drawCollections(); break;
    default: drawCurrentSet(); break;
  }
}

static void enterMenu() {
  mode = MODE_MENU;
  menuSince = millis();
  countdownShown = -1;
  Serial.println("menu opened");
  drawMenu();
}

static void leaveMenu() {
  mode = MODE_NORMAL;
  countdownShown = -1;
  Serial.println("menu left");
  drawCurrentSet();
}

/** One level down, to the volume.
 *
 * Deliberately the same shape as enterCollections() below - the mode, the idle
 * clock, a word to the log, draw. Two screens under the menu and one way of
 * getting into either; a second mechanism for the second one would be two
 * things to keep in step for no gain. */
static void enterVolume() {
  mode = MODE_VOLUME;
  menuSince = millis();
  Serial.println("volume opened");
  drawVolume();
}

// Both defined further down, with the settings and the key handling. Needed up
// here because choosing a collection writes one and waits on the other.
static void saveCollection();
static void waitForRelease();

/** One level down, to the collections - and to the diagnosis where there are
 *  none. */
static void enterCollections() {
  mode = MODE_COLLECTIONS;
  menuSince = millis();
  // From the page the active collection is on, so that the one that is showing
  // is the one somebody sees first. On a device with four or fewer this is
  // always zero and the arithmetic says so.
  collectionPage = held.count
      ? (uint8_t)(held.active / collectionsPerPage(held.count)) : 0;
  Serial.println("collections opened");
  drawCollections();
}

/**
 * On to the collection at `at`, and out of the menu with it.
 *
 * Out, because choosing a collection is not a setting somebody adjusts twice -
 * it is the answer to "show me the other game", and the answer is the other
 * game on the screen rather than a menu that now looks slightly different.
 *
 * rtcCurrentSet goes back to nothing, and that is not tidiness: a set index
 * means something different in every collection, and set 4 of the one that was
 * showing is not set 4 of the one being asked for.
 */
static void goToCollection(uint8_t at) {
  if (at >= held.count) return;
  held.active = at;
  strncpy(activeFile, held.at[at].file, sizeof(activeFile) - 1);
  activeFile[sizeof(activeFile) - 1] = '\0';
  saveCollection();
  Serial.printf("collection: %s (%s)\n", held.at[at].file, held.at[at].name);
  contentReady = loadLayout(activeFile);
  rtcCurrentSet = 0;
  // Her finger is still on the key that did this - CHANGE_RELEASE in
  // key_press.h, and the same worry for the same reason.
  waitForRelease();
  leaveMenu();
}

static void backlight(bool on) {
  digitalWrite(PIN_BL, on ? HIGH : LOW);
}

// --- Sound ---------------------------------------------------------------------

static void setupAudio() {
  pinMode(PIN_AMP_SD, OUTPUT);
  digitalWrite(PIN_AMP_SD, LOW);  // amplifier off until something actually plays

  i2s.setPins(PIN_I2S_BCLK, PIN_I2S_LRCK, PIN_I2S_DIN);
  if (!i2s.begin(I2S_MODE_STD, SAMPLE_RATE, I2S_DATA_BIT_WIDTH_16BIT,
                 I2S_SLOT_MODE_MONO)) {
    Serial.println("I2S would not start.");
  }
}

static void playWav(const char *path) {
  // A slot without text has no audio file - then it stays silent.
  if (!filesystemReady || !path) return;
  File file = LittleFS.open(path, "r");
  if (!file) {
    Serial.printf("no sound: %s\n", path);
    return;
  }
  uint32_t remaining = 0;
  WavShape shape;
  if (!seekToWavData(file, remaining, &shape)) {
    Serial.printf("not a valid WAV: %s\n", path);
    file.close();
    return;
  }

  // Which codec the samples are in. A file whose tag this build has never
  // heard of is played as PCM, which is what it would have been yesterday and
  // is the only answer that cannot make an older recording stop working.
  //
  // The block length comes out of fmt and is brought inside what a block can
  // be rather than trusted: it decides how many bytes are read into `chunk`
  // and handed to the decoder, and a corrupt fmt claiming 40000 would be a
  // read past the end of a 1024-byte buffer. On a board with no memory
  // protection that is not a failure, it is whatever was next in RAM.
  const bool adpcm = shape.formatTag == WAV_FORMAT_IMA_ADPCM;
  const uint32_t block =
      (shape.blockAlign >= 5 && shape.blockAlign <= ADPCM_BLOCK_BYTES)
          ? shape.blockAlign : ADPCM_BLOCK_BYTES;

  static uint8_t chunk[AUDIO_CHUNK];
  // One block's worth of samples, decoded. Static for the same reason `spoken`
  // and `chunk` are: playWav() is never re-entered - a key pressed during a
  // word is dropped, deliberately - so one of these is enough for the device,
  // and 1010 bytes on the stack of a function that also holds the panel poll
  // is not a thing to find out about the hard way.
  static int16_t decoded[ADPCM_BLOCK_SAMPLES];
  digitalWrite(PIN_AMP_SD, HIGH);

  // The whole word, read while the amplifier is coming up rather than while it
  // is playing. Both of these happen inside the wait below, so a word that
  // fits costs nothing extra to start - and once it is in RAM, nothing the
  // file system does can interrupt it.
  const uint32_t readBegan = millis();
  uint32_t held = 0;
  if (remaining <= AUDIO_PRELOAD) {
    held = (uint32_t)file.read(spoken, remaining);
    if (held != remaining) {
      // Short of what the header promised. Not fatal and not silently ignored:
      // what was read is played, and the number says how much was missing.
      Serial.printf("  short read: %u of %u bytes\n",
                    (unsigned)held, (unsigned)remaining);
      remaining = held;
    }
  }
  const uint32_t readMs = millis() - readBegan;
  // AMP_WAKE_MS and not the 5 ms this had: the MAX98357A is nowhere near full
  // gain that quickly, so every word began quiet and a word cut short by the
  // next key was mostly ramp - which is what made the loudness differ between
  // presses on real hardware.
  //
  // Holding it on for the whole waking time was tried instead and was worse:
  // with nothing feeding I2S between words the amplifier sits there
  // amplifying an idle bus, and it hisses audibly. Stage 5 had already shown
  // the pair of them - SD high AND silence written through the gaps was the
  // combination that was clean - and keeping I2S fed everywhere needs loop()
  // restructured or an audio task of its own, not a line moved.
  // Whatever is left of the wake time after the read. On a file system that
  // answered quickly this is still the full 50 ms; on one that took 30 ms to
  // hand the word over, the amplifier has been coming up throughout and only
  // the remainder is spent waiting.
  if (readMs < AMP_WAKE_MS) delay(AMP_WAKE_MS - readMs);

  // A word is not interrupted, and that is a decision rather than an
  // omission. Letting the next key cut this one off was tried on real
  // hardware and was worse: pressed quickly, nine presses out of ten were
  // clipped after a few tens of milliseconds, which is far too short to
  // recognise. Every press did start a word - the log said so - and it still
  // sounded exactly like a device ignoring a third of them.
  //
  // So a press during a word is dropped, and pressing quickly gives fewer
  // words rather than broken ones. For someone learning that a key makes the
  // device speak, a whole word she did not ask for is a better wrong answer
  // than a fragment she cannot make out.
  // How loud this word actually is, measured on the way past. Nothing in the
  // browser normalises any more - that went with the Python - so one word can
  // be a fraction of another, and AUDIO_VOLUME is one number for all of them
  // rather than something that could even that out. A word that is merely
  // quiet and a word that is silent look identical from the outside, and this
  // is the difference between them.
  //
  // Measured before the scaling, so it stays a fact about the file. What
  // reaches the amplifier is this times AUDIO_VOLUME percent, and a peak that
  // moved every time somebody turned the volume down would answer a different
  // question from the one it was put here for.
  int16_t peak = 0;
  const uint32_t sampleBytes = remaining;
  const uint32_t began = millis();

  // Where the next chunk comes from: out of RAM for a word that fitted, and
  // straight off the file system for one that did not. One loop rather than
  // two, because everything after the read - the peak, the volume, the writing
  // and the button poll - is the same work either way, and two copies of it
  // would drift.
  //
  // A compressed recording adds a step and not a path: the bytes arrive the
  // same way, become samples here, and everything after that is the loop that
  // was already here. That is deliberate and it is the whole of why the
  // decoder takes a buffer rather than a file - docs/bring-up.md stage 5 is
  // what a starved I2S stream sounds like, and the one thing this loop must
  // never gain is a second place it can go to the file system.
  uint32_t at = 0;
  uint32_t played = 0;
  while (remaining > 0) {
    // A block at a time when it is compressed, because a block is the unit the
    // decoder reads: it carries its own first sample and step index in a
    // four-byte header, and half of one decodes to nothing.
    const size_t unit = adpcm ? (size_t)block : AUDIO_CHUNK;
    size_t want = remaining < unit ? remaining : unit;
    size_t got;
    if (held) {
      memcpy(chunk, spoken + at, want);
      at += want;
      got = want;
    } else {
      got = file.read(chunk, want);
    }
    if (got == 0) break;
    remaining -= got;

    // What is about to be scaled and written: the bytes as they arrived for a
    // plain recording, and the samples they decode to for a compressed one.
    // The decoder writes int16 in the machine's own order and the loop below
    // reads them back little-endian, which is the same thing on this board and
    // is the same assumption playWav() has always made about a data chunk.
    uint8_t *samples = chunk;
    size_t bytes = got;
    if (adpcm) {
      const uint32_t made = adpcmDecodeBlock(chunk, (uint32_t)got, decoded);
      if (made == 0) continue;         // a tail too short to hold a sample
      samples = (uint8_t *)decoded;
      bytes = made * 2;
    }
    played += (uint32_t)bytes;

    for (size_t i = 0; i + 1 < bytes; i += 2) {
      const int16_t sample =
          (int16_t)((uint16_t)samples[i] | ((uint16_t)samples[i + 1] << 8));
      // INT16_MIN has no positive counterpart, so its size is taken as the
      // largest one that has. Only the measurement needs this; the sample
      // itself is scaled below and keeps its sign.
      int16_t loud = sample == INT16_MIN ? INT16_MAX : sample;
      if (loud < 0) loud = (int16_t)-loud;
      if (loud > peak) peak = loud;

      // And the volume, written back into the buffer that is about to be
      // handed to I2S. In 32 bits because 32767 * 100 does not fit in 16, and
      // rounded towards zero, which at this size is inaudible and is what
      // keeps a setting of 100 an exact no-op.
      const int16_t quieter =
          (int16_t)(((int32_t)sample * (int32_t)volumeNow) / 100);
      samples[i] = (uint8_t)((uint16_t)quieter & 0xff);
      samples[i + 1] = (uint8_t)(((uint16_t)quieter >> 8) & 0xff);
    }
    i2s.write(samples, bytes);

    const int8_t caught = pollButtons();
    if (caught >= 0) pendingKey = caught;
  }

  // The read and the playing, side by side, because they answer different
  // questions. The playing should be the length of the word and no more; a
  // number well above that is the DMA having been starved, which is what
  // preloading is here to prevent and what the log has to be able to show if
  // it ever happens anyway. The read is the file system's own time, and it is
  // interesting when it approaches AMP_WAKE_MS - that is the point where a
  // word starts costing latency rather than hiding inside the wake.
  // Expected out of what was actually played rather than out of the file's
  // size, because those are no longer the same number: a compressed recording
  // is a quarter of the bytes and the same length of word. The file's size is
  // still said, beside the form it was in, because "smaller than I expected"
  // is how somebody notices a talker being sent the wrong form.
  Serial.printf("  %u bytes %s, read %u ms, played %u ms (%u expected)%s, "
                "peak %d of 32767 (%d%%)\n",
                (unsigned)sampleBytes, adpcm ? "adpcm" : "pcm",
                (unsigned)readMs,
                (unsigned)(millis() - began),
                (unsigned)(played / (SAMPLE_RATE / 500)),
                held ? "" : " streamed",
                (int)peak, (int)((int32_t)peak * 100 / 32767));

  // Silence before the amplifier is switched off, or it clicks. Three chunks
  // and not the eight it was: at AUDIO_CHUNK and SAMPLE_RATE that is 96 ms
  // rather than 256, and those 160 ms were the fattest part of the ~740 ms a
  // press costs. The shorter that is, the less often two presses land inside
  // one word - which is the whole of what is still being lost.
  //
  // If the click comes back, this is the number that brought it back. It is
  // not the click stage 5 measured, though: that one was the I2S stream
  // running dry, and no amount of tail here addresses it.
  memset(chunk, 0, AUDIO_CHUNK);
  for (uint8_t i = 0; i < AUDIO_TAIL_CHUNKS; i++) {
    i2s.write(chunk, AUDIO_CHUNK);
    const int8_t caught = pollButtons();   // this counts too
    if (caught >= 0) pendingKey = caught;
  }
  digitalWrite(PIN_AMP_SD, LOW);
  file.close();
}

// --- How loud ----------------------------------------------------------------

/** The stored setting, or the compiled-in default if there is none.
 *
 * Read once, in setup(). A value from a future firmware with a wider range is
 * brought inside this one's rather than trusted, the same way
 * layoutIdleSeconds() treats a sleep timeout: what is on the other side of a
 * flash is not this build's business to believe. */
static void loadVolume() {
  settings.begin("vorlaut", true);          // read-only
  const uint32_t stored = settings.getUInt("volume", AUDIO_VOLUME_PERCENT);
  settings.end();
  volumeNow = (uint8_t)(stored < VOLUME_MIN ? VOLUME_MIN
                        : stored > VOLUME_MAX ? VOLUME_MAX : stored);
  Serial.printf("volume: %u%%\n", (unsigned)volumeNow);
}

static void saveVolume() {
  settings.begin("vorlaut", false);
  settings.putUInt("volume", volumeNow);
  settings.end();
}

/** What was found, however it was found. One printer rather than two, because
 *  the walked list and the remembered list have to be the same list - and a
 *  log that said so in two different shapes would be the first place to doubt
 *  it. The word is which path it came down: a device that is slow to wake and
 *  says "walked" every time is a cache that is not sticking. */
static void sayCollections(const char *how) {
  Serial.printf("collections: %u found (%s)", (unsigned)held.count, how);
  if (held.refused) Serial.printf(", %u not readable", (unsigned)held.refused);
  Serial.println();
  for (uint8_t i = 0; i < held.count; i++) {
    Serial.printf("  %s  %s\n", held.at[i].file, held.at[i].name);
  }
}

// --- Which collection ---------------------------------------------------------

/** The collection last chosen, by file name, or empty for none.
 *
 * Beside the volume and in NVS for the same reason, said once in the comment
 * on AUDIO_VOLUME_PERCENT and not repeated here: it is something the person in
 * the room changes, so it is not a field in a format. It also must not be on
 * LittleFS - that is the browser's half, swept and diffed by the cable, and a
 * setting living there would be one more name to teach that sweep about.
 *
 * The FILE name and not an index. An index would mean something different the
 * moment a collection is added or removed, and adding and removing is the whole
 * of what this change is for. The name is checked against what is really there
 * before it is used - collectionsChoose() - so a name left over from a
 * collection that has since gone is a fallback rather than a fault. */
static void loadCollection() {
  settings.begin("vorlaut", true);          // read-only
  const size_t got = settings.getString("collection", activeFile,
                                        sizeof(activeFile));
  settings.end();
  if (got == 0) activeFile[0] = '\0';
  // A name from a future firmware with a longer one is not trusted, the same
  // way the volume is brought inside this build's range: what is on the other
  // side of a flash is not this build's business to believe.
  if (collectionKind(activeFile) == COLLECTION_NOT) activeFile[0] = '\0';
  if (activeFile[0]) Serial.printf("collection: %s was showing\n", activeFile);
}

static void saveCollection() {
  settings.begin("vorlaut", false);
  settings.putString("collection", activeFile);
  settings.end();
}

// --- The list, kept across a sleep -------------------------------------------

/**
 * The collection list, remembered, so that waking does not walk the partition.
 *
 * A deep sleep is a restart: setup() runs in full on every press that wakes
 * the device, and walkCollections() was in it. That walk costs a lookup per
 * file, the file count grows with every collection, and all of it happens
 * before the backlight comes on - so it is paid in the one place nobody can
 * afford it, by a child holding a talker that looks broken.
 *
 * **What makes this safe is that the device never writes content itself.**
 * Tiles, recordings and collections arrive over the cable and leave over the
 * cable, and nothing else on this device creates or removes one - removing is
 * on the loader page rather than in the menu, which adr/0021 argues for on its
 * own grounds and which happens to be why this cache can exist at all. So
 * there is exactly one moment the list can change, and it is a moment this
 * firmware is present for.
 *
 * The cache is therefore dropped when a cable session opens, not when it
 * writes. Dropping it at `hello` is what makes a power cut safe: the window
 * between "the list changed" and "the cache says so" never contains a stale
 * cache, only no cache, and no cache costs one slow wake and nothing else.
 * cableProgress() drops it; the end of the session puts it back.
 *
 * Two things it still checks on the way in, because NVS outlives things it
 * should not. The mark catches a cache written by another build. The existence
 * check catches a partition that has been formatted underneath it - LittleFS
 * .begin(true) does that to a file system it cannot mount - and costs sixteen
 * lookups at worst against the whole directory.
 *
 * It cannot catch a file that appeared without a cable session. Nothing makes
 * one.
 */
#define COLLECTIONS_CACHE_KEY "collections"

/** Bumped when the shape below changes, so that a cache from another build is
 *  discarded rather than read as this one. */
#define COLLECTIONS_CACHE_MARK 1

struct CollectionsCache {
  uint8_t mark;
  uint8_t count;
  uint8_t refused;
  Collection at[MAX_COLLECTIONS];
};

/** Only the entries that are used. Usually one or two collections, so this is
 *  a couple of hundred bytes rather than the table's full 1136. */
static size_t collectionsCacheBytes(uint8_t count) {
  return offsetof(CollectionsCache, at) + (size_t)count * sizeof(Collection);
}

static void forgetCollectionsCache() {
  settings.begin("vorlaut", false);
  settings.remove(COLLECTIONS_CACHE_KEY);
  settings.end();
}

static void saveCollectionsCache() {
  CollectionsCache cache;
  cache.mark = COLLECTIONS_CACHE_MARK;
  cache.count = held.count;
  cache.refused = held.refused;
  for (uint8_t i = 0; i < held.count; i++) cache.at[i] = held.at[i];
  settings.begin("vorlaut", false);
  settings.putBytes(COLLECTIONS_CACHE_KEY, &cache,
                    collectionsCacheBytes(cache.count));
  settings.end();
}

/** True when `held` was filled from the cache. False leaves it untouched, so
 *  the caller walks. */
static bool loadCollectionsCache() {
  if (!filesystemReady) return false;

  CollectionsCache cache;
  settings.begin("vorlaut", true);          // read-only
  const size_t got = settings.getBytes(COLLECTIONS_CACHE_KEY, &cache,
                                       sizeof(cache));
  settings.end();

  if (got < collectionsCacheBytes(0)) return false;
  if (cache.mark != COLLECTIONS_CACHE_MARK) return false;
  if (cache.count > MAX_COLLECTIONS) return false;
  // The length has to agree with the count it carries. A blob that is one
  // entry short would otherwise be read as a list ending in whatever was on
  // the stack.
  if (got != collectionsCacheBytes(cache.count)) return false;

  // Still there? A formatted partition is the case this is really for, and it
  // shows up as the first name not being found.
  for (uint8_t i = 0; i < cache.count; i++) {
    cache.at[i].file[COLLECTION_FILE_CHARS] = '\0';
    cache.at[i].name[NAME_BYTES] = '\0';
    if (!LittleFS.exists(String("/") + cache.at[i].file)) return false;
  }

  collectionsClear(held);
  held.count = cache.count;
  held.refused = cache.refused;
  for (uint8_t i = 0; i < cache.count; i++) held.at[i] = cache.at[i];
  sayCollections("remembered");
  return true;
}

/** A short note at the current volume, so a press can be heard as well as read.
 *
 * A volume control nobody can hear is a number on a screen, and the menu is
 * reachable on a device with no content at all - where there is no word to
 * play instead. So this is generated: 500 Hz, which at 16 kHz is 32 samples
 * per period and therefore a whole number of periods in a chunk of 512. That
 * is not tidiness, it is why the loop below can repeat one buffer without a
 * step in the waveform at every join, and why the tone starts and ends at a
 * zero crossing.
 *
 * The amplifier is woken and put back to sleep exactly as playWav() does it,
 * including the silence afterwards: the click that arrangement avoids has
 * nothing to do with which samples are being sent. */
static void playTone() {
  static int16_t wave[512];
  // A quarter of full scale is about where a normalised word sits, so the
  // note is a fair sample of what the setting will do to speech rather than
  // a beep at the top of the range.
  const float peak = 8192.0f * (float)volumeNow / 100.0f;
  for (size_t i = 0; i < 512; i++) {
    wave[i] = (int16_t)(peak * sinf(2.0f * PI * 500.0f * (float)i / SAMPLE_RATE));
  }
  digitalWrite(PIN_AMP_SD, HIGH);
  delay(AMP_WAKE_MS);
  for (uint8_t i = 0; i < 6; i++) i2s.write((uint8_t *)wave, sizeof(wave));
  memset(wave, 0, sizeof(wave));
  for (uint8_t i = 0; i < AUDIO_TAIL_CHUNKS; i++) {
    i2s.write((uint8_t *)wave, sizeof(wave));
  }
  digitalWrite(PIN_AMP_SD, LOW);
}

// --- Keys ------------------------------------------------------------------

static bool isDown(uint8_t index) {
  return digitalRead(PIN_BUTTON[index]) == LOW;  // buttons go to GND
}

static bool anyDown() {
  for (uint8_t i = 0; i < DISPLAY_COUNT; i++) {
    if (isDown(i)) return true;
  }
  return false;
}

static void clearButtonStates() {
  for (uint8_t i = 0; i < DISPLAY_COUNT; i++) {
    button[i].downSince = 0;
    button[i].reported = false;
  }
}

// After waking: wait until no key is really pressed any more. The press that
// woke the device must not trigger anything - she is pressing blind.
//
// It costs more than one press, though, and that was watched happening on a
// real morning: three presses before the first word. One to wake, which is
// this rule working. One during the boot that follows, which is this rule
// again - clearButtonStates() throws away anything pressed while the screens
// were still dark, and from the outside that press simply does nothing. And
// one that finally speaks.
//
// The rule is right and the cost is not: pressing blind at a dark device is
// exactly what she is doing for the whole of the boot, not just for the
// waking press. Either the dark stretch gets short enough that nobody presses
// into it - "ready N ms after waking" at the end of setup() is there to say
// how long it really is - or a press made during it should be remembered the
// way one made during a word now is.
static void waitForRelease() {
  while (anyDown()) delay(10);
  delay(DEBOUNCE_MS);
  clearButtonStates();
}

// Both menu keys held? Shows the countdown and reports once the five
// seconds are full. Letting go cancels, and nothing happens.
static bool menuComboReady() {
  const uint32_t now = millis();
  if (!(isDown(MENU_KEY_A) && isDown(MENU_KEY_B))) {
    if (comboSince != 0 && countdownShown >= 0) {
      // Cancelled: back to whatever was on screen before.
      countdownShown = -1;
      redraw();
    }
    comboSince = 0;
    return false;
  }
  if (comboSince == 0) comboSince = now;
  const uint32_t held = now - comboSince;
  if (held >= MENU_HOLD_MS) {
    comboSince = 0;
    countdownShown = -1;
    return true;
  }
  const int8_t left = (int8_t)((MENU_HOLD_MS - held) / 1000) + 1;
  if (left != countdownShown) {
    countdownShown = left;
    char seconds[4];
    snprintf(seconds, sizeof(seconds), "%d", left);
    for (uint8_t i = 0; i < DISPLAY_COUNT; i++) {
      drawMenuKey(display[i], text().menu, seconds);
    }
  }
  return false;
}

// Returns the index of a newly recognised key, or -1.
static int8_t pollButtons() {
  const uint32_t now = millis();
  for (uint8_t i = 0; i < DISPLAY_COUNT; i++) {
    if (isDown(i)) {
      if (button[i].downSince == 0) button[i].downSince = now;
      if (!button[i].reported && now - button[i].downSince >= keyHoldMs(i)) {
        button[i].reported = true;
        return (int8_t)i;
      }
    } else {
      button[i].downSince = 0;
      button[i].reported = false;
    }
  }
  return -1;
}

/**
 * On to the set a key names.
 *
 * The four steps are ChangeStep in key_press.h and this walks them in the
 * order that enumeration gives them, rather than doing four things in a row
 * and describing the order in a comment. The order is the part that goes
 * wrong, it is the part no test can read out of this file, and both of those
 * stop being true when it is data - device/fixtures/press.expected.json states
 * it from outside, and reordering the enumeration reorders what happens here.
 *
 * Not a mode and not a game. Nothing is remembered about how the device got
 * here, so there is no state to be stuck in: the next press is read off the
 * new set exactly the way the last one was read off the old.
 */
static void goToSet(uint8_t to) {
  Serial.printf("  on to set %u\n", (unsigned)(to + 1));
  for (uint8_t step = 0; step < KEY_CHANGE_STEPS; step++) {
    switch ((ChangeStep)step) {
      case CHANGE_PAUSE:
        // Deliberately long. See CHANGE_PAUSE in key_press.h - this second is
        // the whole of what the device gives back for getting it right.
        delay(KEY_WORD_PAUSE_MS);
        break;
      case CHANGE_RELEASE:
        // Her finger is still on the key that did this.
        waitForRelease();
        break;
      case CHANGE_SHOW:
        rtcCurrentSet = to;
        drawCurrentSet();
        break;
      case CHANGE_DEAF:
        // Deaf, not queued: clearButtonStates() afterwards throws away a key
        // held through the wait rather than reporting it the moment the wait
        // ends. pendingKey goes with it - a press caught during the word was
        // meant for the board that is no longer up.
        delay(KEY_SETTLE_MS);
        clearButtonStates();
        pendingKey = -1;
        break;
    }
  }
  lastActivity = millis();
}

// --- Sleep ----------------------------------------------------------------

static void goToSleep() {
  Serial.println("going to sleep");
  Serial.flush();

  backlight(false);
  for (uint8_t i = 0; i < DISPLAY_COUNT; i++) {
    display[i]->fillScreen(ST77XX_BLACK);
    display[i]->sendCommand(ST77XX_DISPOFF);
    display[i]->sendCommand(ST77XX_SLPIN);
  }

  digitalWrite(PIN_AMP_SD, LOW);
  i2s.end();

  // Hold the backlight low through the sleep. Deep sleep stops driving the
  // digital pins unless it is asked not to, so PIN_BL floated and the
  // ScreenKeys lit themselves back up the moment the chip went under -
  // displays properly off, five backlights on, all night, on a battery. It
  // looks like a device that is awake and has nothing to say, which is the
  // worst of both.
  //
  // The amplifier's SD wants the same treatment for the same reason: floating
  // is not off, and a floating enable on a class-D amplifier is how a sleeping
  // device hisses.
  gpio_hold_en((gpio_num_t)PIN_BL);
  gpio_hold_en((gpio_num_t)PIN_AMP_SD);

  // And the panels' own lines, for a different reason than the backlight's.
  // They keep their power through the sleep, so they keep their registers and
  // their picture - but only if nothing reaches them. Deselected and not
  // reset, they are deaf to whatever the floating bus does, and waking needs
  // no init at all. That is 3.8 seconds of the 4.3 this used to take.
  for (uint8_t i = 0; i < DISPLAY_COUNT; i++) {
    digitalWrite(PIN_CS[i], HIGH);
    gpio_hold_en((gpio_num_t)PIN_CS[i]);
  }
  digitalWrite(PIN_RST, HIGH);
  gpio_hold_en((gpio_num_t)PIN_RST);
  gpio_deep_sleep_hold_en();

  // Pull-ups have to stay active during sleep, otherwise the inputs float.
  uint64_t mask = 0;
  for (uint8_t i = 0; i < DISPLAY_COUNT; i++) {
    gpio_num_t pin = (gpio_num_t)PIN_BUTTON[i];
    rtc_gpio_pullup_en(pin);
    rtc_gpio_pulldown_dis(pin);
    mask |= 1ULL << PIN_BUTTON[i];
  }
  esp_sleep_enable_ext1_wakeup(mask, ESP_EXT1_WAKEUP_ANY_LOW);
  esp_deep_sleep_start();
}

// --- Arduino -----------------------------------------------------------------

void setup() {
  // Room for exactly one window, which is the most that can be in flight.
  //
  // The browser sends CABLE_WINDOW bytes and then waits to be told they are in
  // the file system, so this is not sized against how fast USB can push - it
  // is sized against a number the device itself chose and announces. That is
  // the difference from what stood here before: 64 KB picked to be bigger than
  // the worst burst anybody had measured, on a protocol where a burst that was
  // bigger still would have been discarded in silence.
  //
  // Has to come before begin() - the buffer is allocated there.
  Serial.setRxBufferSize(CABLE_WINDOW);
  Serial.begin(115200);


  for (uint8_t i = 0; i < DISPLAY_COUNT; i++) {
    pinMode(PIN_BUTTON[i], INPUT_PULLUP);
  }
  const bool wokeFromSleep =
      esp_sleep_get_wakeup_cause() == ESP_SLEEP_WAKEUP_EXT1;

  // Let go of what goToSleep() held. Until this the pins keep the level they
  // slept at and pinMode/digitalWrite are quietly ignored, so the backlight
  // would stay dark for the whole session rather than the whole sleep.
  if (wokeFromSleep) {
    // Drive each pin to the level it was held at *before* letting go of it.
    // A hold released onto an unconfigured pin floats for the moment in
    // between, and on RST that moment is a reset - which would throw away the
    // very panels this is keeping alive. So: take over, then let go.
    pinMode(PIN_RST, OUTPUT);
    digitalWrite(PIN_RST, HIGH);
    for (uint8_t i = 0; i < DISPLAY_COUNT; i++) {
      pinMode(PIN_CS[i], OUTPUT);
      digitalWrite(PIN_CS[i], HIGH);
    }
    pinMode(PIN_BL, OUTPUT);
    digitalWrite(PIN_BL, LOW);
    pinMode(PIN_AMP_SD, OUTPUT);
    digitalWrite(PIN_AMP_SD, LOW);

    gpio_deep_sleep_hold_dis();
    gpio_hold_dis((gpio_num_t)PIN_BL);
    gpio_hold_dis((gpio_num_t)PIN_AMP_SD);
    for (uint8_t i = 0; i < DISPLAY_COUNT; i++) {
      gpio_hold_dis((gpio_num_t)PIN_CS[i]);
    }
    gpio_hold_dis((gpio_num_t)PIN_RST);
  }

  pinMode(PIN_BL, OUTPUT);
  backlight(false);  // switch on only once there is really a picture

  setupDisplays(wokeFromSleep);
  t_displays = millis();
  setupAudio();
  // Before anything can be played, and after every wake: a deep sleep is a
  // restart, so this is read on the way out of one as well as on the way out
  // of the box.
  loadVolume();
  loadCollection();
  t_audio = millis();

  // Formats when there is nothing to mount, and that changed with the release
  // becoming program-only. The merged image covers the whole flash and leaves
  // the file area as 7040 KiB of 0xFF, so a device flashed from one comes up
  // with a partition that is there and holds no file system. With begin(false)
  // that is a device which cannot mount, and therefore cannot be written to
  // over the cable either - the one way content reaches it would be shut on
  // exactly the devices that have none.
  //
  // It is not a silent wipe. begin(true) formats only when a partition named
  // "spiffs" exists and carries no file system; a table without one still
  // fails, so the hints below still point at the right thing. What it can cost is the content on a file system that has
  // become unreadable - and that content is one press away in the editor,
  // while a talker that will not mount is a talker that cannot be given any.
  filesystemReady = LittleFS.begin(true);
  t_littlefs = millis();
  if (!filesystemReady) {
    // Most common cause: the wrong partition table. This sketch brings its
    // own, partitions.csv beside this file, and the ESP32 core copies it over
    // whatever the FQBN's PartitionScheme names - a build that did not do
    // that has the board's default (tinyuf2), whose data area is called
    // "ffat", and LittleFS looks for one called "spiffs".
    Serial.println("LittleFS would not mount, and would not format either.");
    Serial.println("  1. did partitions.csv reach the build? the flash needs");
    Serial.println("     a partition named \"spiffs\", 7040 KiB at 0x120000.");
    Serial.println("  2. if that is right, the flash itself is the suspect.");
  }

  // Only here, because the file system has to be up for them.
  scanCollections();
  contentReady = openActive();
  t_layout = millis();
  if (contentReady && rtcCurrentSet >= layout.setCount) rtcCurrentSet = 0;

  drawCurrentSet();
  t_drawn = millis();
  backlight(true);

  clearButtonStates();
  if (wokeFromSleep) {
    // The waking press expires: only the displays come on, nothing else.
    waitForRelease();
  }

  // Which build is actually running, and the settings that are usually the
  // question. On a device flashed a dozen times in an evening "did that
  // upload take?" is a real question, and guessing wastes more than the line
  // costs. Deep sleep restarts the sketch, so waking reprints it.
  //
  // Down here rather than beside Serial.begin(): on the S3's native USB the
  // port is not enumerated for the first moment after begin(), and anything
  // printed into that gap is simply lost. It was, which is how this comment
  // came to be written.
  Serial.printf("vorlaut build %s %s (amp wake %u ms, cable window %u)\n",
                __DATE__, __TIME__, (unsigned)AMP_WAKE_MS,
                (unsigned)CABLE_WINDOW);
  // How long the press-to-picture gap is. Everything up to here happens with
  // the backlight deliberately off, so this number is exactly how long the
  // device looks broken to somebody who has just pressed a key.
  readyMs = millis();
  wokeUp = wokeFromSleep;

  lastActivity = millis();
}

void loop() {
  if (!readySaid && millis() > 2500) {
    readySaid = true;
    Serial.printf("  ready %u ms after %s"
                  " (displays %u, audio %u, littlefs %u, layout %u, drawn %u)\n",
                  (unsigned)readyMs, wokeUp ? "waking" : "power-on",
                  (unsigned)t_displays, (unsigned)t_audio, (unsigned)t_littlefs,
                  (unsigned)t_layout, (unsigned)t_drawn);
  }

  // A browser on the cable comes first. Cable::waiting() is one call to
  // Serial.available() when nothing is there, and when something is there it
  // is the most explicit thing anybody can be doing with this device.
  //
  // Serve() returns at once unless a browser really says hello, so a serial
  // monitor left open costs a quarter of a second and nothing else.
  if (Cable::waiting()) {
    const CableResult cable = Cable::serve(cableProgress, cableAbort);
    if (cable.ran) {
      Serial.printf("cable: %u stored, %u removed, %u bytes%s%s\n",
                    cable.stored, cable.removed, (unsigned)cable.bytes,
                    cable.error ? " - " : "", cable.error ? cable.error : "");
      if (cable.stored || cable.removed) {
        // Read the new content in straight away. Otherwise the device would
        // go on showing yesterday until somebody restarts it, which is a bad
        // way to find out whether the transfer worked.
        //
        // And show the collection that was just sent, where one was. Sending a
        // second game to a talker that goes on showing the first is a transfer
        // that looks from the outside exactly like a transfer that failed, and
        // the person who would find out otherwise is standing at the desk with
        // the cable in their hand. Where nothing was sent - a session that only
        // removed things - whatever was showing stays showing, unless it is the
        // thing that went, and then openActive() falls back.
        if (cable.collection[0]) {
          strncpy(activeFile, cable.collection, sizeof(activeFile) - 1);
          activeFile[sizeof(activeFile) - 1] = '\0';
          saveCollection();
          rtcCurrentSet = 0;
        }
        scanCollections();
        contentReady = openActive();
        if (contentReady && rtcCurrentSet >= layout.setCount) rtcCurrentSet = 0;
        // The screen below may be listing a collection that has just gone, or
        // missing one that has just arrived.
        if (mode == MODE_COLLECTIONS) {
          collectionPage = held.count
              ? (uint8_t)(held.active / collectionsPerPage(held.count)) : 0;
        }
      } else {
        // Nothing was stored and nothing removed - a session that only looked.
        // The list in RAM is still the list on the partition, so it goes back
        // into NVS rather than leaving the next wake to walk for it. Reading
        // the collections back is exactly what the loader page's "Have a look"
        // does, and it would otherwise cost a slow wake every time somebody
        // checked what was on the device.
        saveCollectionsCache();
      }
      delay(1500);            // long enough to read the count on the displays
      waitForRelease();
      redraw();
      lastActivity = millis();
      menuSince = millis();
      return;
    }
  }

  // The gesture takes precedence - otherwise letting go would count as a press.
  if (menuComboReady()) {
    // Out of the menu from wherever in it the device is, and that is the one
    // place the screens below are NOT one level deeper: the gesture that opens
    // the menu closes it, and having to climb back up first before the way out
    // worked would make the gesture depend on where somebody happens to be
    // standing. The set key is the one that counts levels.
    if (mode == MODE_NORMAL) enterMenu(); else leaveMenu();
    // Both keys are still being held. Without the wait, the set key would
    // switch again 400 ms later.
    waitForRelease();
    lastActivity = millis();
    menuSince = millis();
    return;
  }
  if (comboSince != 0) {
    lastActivity = millis();
    delay(5);
    return;   // while the countdown runs, nothing else may trigger
  }

  int8_t pressed = pollButtons();
  if (pressed < 0 && pendingKey >= 0) {
    pressed = pendingKey;
    Serial.printf("key %d: was pressed while the last word played\n", pressed + 1);
  }
  pendingKey = -1;

  if (mode == MODE_MENU) {
    if (pressed == SET_BUTTON) {
      // **The set key is back on every screen it appears on, and this is the
      // top one, so back is out.** One word, one key, one rule; the two screens
      // below go up a level with the same key and the same label, and neither
      // of them has to say anything else.
      leaveMenu();
    } else if (pressed == 0) {
      enterVolume();
    } else if (pressed == 1) {
      // Which is also MENU_KEY_B. Someone leaving the menu by the gesture whose
      // finger lands here a few milliseconds before the set key opens the
      // collections on the way, and the gesture then still closes the menu from
      // where it now is - so this costs a flicker and never a wrong screen. The
      // set key has had exactly this property since the menu existed.
      enterCollections();
    }
    if (pressed >= 0) {
      lastActivity = millis();
      menuSince = millis();
    }
    // Do not get stuck in the menu: back after a while without input.
    if (millis() - menuSince >= MENU_IDLE_MS) leaveMenu();
    delay(5);
    return;
  }

  if (mode == MODE_VOLUME) {
    if (pressed == SET_BUTTON) {
      // Back up one, not out - the same two lines the collection screen has
      // below, because it is the same key doing the same thing.
      mode = MODE_MENU;
      Serial.println("volume closed");
      drawMenu();
    } else if (pressed == 0) {
      changeVolume(-(int8_t)VOLUME_STEP);
    } else if (pressed == 2) {
      changeVolume((int8_t)VOLUME_STEP);
    }
    if (pressed >= 0) {
      lastActivity = millis();
      menuSince = millis();
    }
    // **Out of the menu altogether, not up one level.** Word for word the
    // reason the collection screen gives below, and it has to be said again
    // here rather than borrowed: the depth is what a device stuck in the menu
    // does not care about.
    if (millis() - menuSince >= MENU_IDLE_MS) leaveMenu();
    delay(5);
    return;
  }

  if (mode == MODE_COLLECTIONS) {
    if (pressed == SET_BUTTON) {
      // Back up one, not out. The set key is the way back on every screen it
      // appears on, and on the screen above it is the way out - which is the
      // whole of the navigation, said in one key.
      mode = MODE_MENU;
      Serial.println("collections closed");
      drawMenu();
    } else if (pressed >= 0 && pressed < COLLECTION_KEYS) {
      if (collectionsPaging(held.count) && pressed == COLLECTION_KEYS - 1) {
        // Round rather than stopping at the last page. There is no "back a
        // page" key to be had and no room for one, so the only way to reach a
        // page you have gone past is to keep going.
        collectionPage = (uint8_t)((collectionPage + 1)
                                   % collectionsPages(held.count));
        drawCollections();
      } else {
        const int8_t at = collectionsOnPage(held.count, collectionPage,
                                            (uint8_t)pressed);
        // A dark key, and the diagnosis screen's keys, do nothing. Neither is
        // a name, and a key that did something anyway would be a device
        // answering a press nobody made.
        if (at >= 0) goToCollection((uint8_t)at);
      }
    }
    if (pressed >= 0) {
      lastActivity = millis();
      menuSince = millis();
    }
    // **Out of the menu altogether, not up one level.** A device that is in
    // here is a device that is not speaking, and how deep in it is makes no
    // difference to that. leaveMenu() is the same call the screen above makes.
    if (millis() - menuSince >= MENU_IDLE_MS) leaveMenu();
    delay(5);
    return;
  }

  if (pressed >= 0) {
    lastActivity = millis();
    if (!contentReady) {
      // Without content there is nothing to switch and nothing to say. The
      // notice stays up, but the device does respond - it is not broken, it
      // is just empty.
      showNoContent();
      return;
    }
    // What the key does is in the file, and this is where the device does it.
    // All five keys go through the same two lines, because since version 3 the
    // set key is a key like the other four: it has a picture, a word and a
    // target of its own, and a talker's ring - on to the next set, round to
    // the first from the last - is what a builder writes into that target
    // rather than something this file works out with a modulo.
    //
    // Which means a set nothing leads out of is a set the device stays in, and
    // that is right rather than a hole to be plugged. A set key that switched
    // anyway would be a way past every round of the joining game that has
    // nothing to do with the word - the skip gesture this device deliberately
    // does not have - and layoutKeyGoesTo() already refuses to invent a
    // destination for the same reason.
    const KeyPress press = keyPress(layout, rtcCurrentSet, (uint8_t)pressed);
    if (press.plays) {
      char path[2 + HASH_BYTES * 2 + 5];
      hashPath(path, 'a', press.key->audio, ".wav");
      Serial.printf("key %d: %s\n", pressed + 1, path);
      playWav(path);
    } else {
      Serial.printf("key %d: nothing to say\n", pressed + 1);
    }
    if (press.goesTo >= 0) goToSet((uint8_t)press.goesTo);
    lastActivity = millis();  // do not count playing time against the timeout
  }

// Overriding the idle timeout is for testing the sleep path, and it is kept
// rather than tidied away: at the real LAYOUT_SLEEP_DEFAULT of 600 s, every
// attempt at a bug that only shows on waking costs ten minutes of waiting,
// which is why that path went untested until it had four seconds of fault in
// it.
//
//   arduino-cli compile --build-property \
//     "compiler.cpp.extra_flags=-DFORCE_SLEEP_S=60" ...
#ifdef FORCE_SLEEP_S
  const uint32_t idle = FORCE_SLEEP_S;
#else
  // layoutIdleSeconds() rather than a `? :` with a number in it. It is in
  // layout_format.h, where a test can include it - this file is the one no
  // test can - and it is what keeps the multiplication below from wrapping.
  const uint32_t idle = layoutIdleSeconds(layout.sleepSeconds);
#endif
  if (millis() - lastActivity >= idle * 1000UL) {
    goToSleep();
  }

  delay(5);
}
