Lautstark/vorlaut-diy-talker/(commit log)

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2026-08-19 Gesprochene Saetze mit ins Repo
    Bisher lagen sie nur oertlich in cache/. Sie kosten aber Azure-Guthaben
    und den Key, um sie wiederherzustellen - anders als die Bilder in
    firmware/mitreden/data/, die build.py jederzeit gratis neu erzeugt.
    1,4 MB gegen 800 KB, aber die 800 KB sind in Sekunden zurueck.
    - .gitignore: cache/* ignorieren, cache/tts/ ausnehmen
    - tts.py: cache/tts/index.json ordnet jeder Pruefsumme ihren Text zu,
    damit der Cache lesbar bleibt
    - build.py: bricht nicht mehr ab, wenn der Key fehlt, sondern nutzt was
    im Cache liegt. Ein frischer Klon ist damit ohne Azure-Zugang baubar,
    solange sich die Texte nicht geaendert haben. Nur ein neuer Text
    verlangt den Key und sagt da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
2026-08-19 Set-Taste muss 400 ms gehalten werden, Gehaeusemasse ins README
    Ein versehentlicher Set-Wechsel nimmt ihr das Wort weg, das sie gerade
    sagen wollte, und sie muss erst wiederfinden, wo sie ist. Das wiegt
    schwerer als ein falsch getroffenes Wort, deshalb braucht die Set-Taste
    eine laengere Mindest-Druckdauer als die Sprechtasten.
    Dazu die Gehaeusemasse aus den Datenblaettern: Raster 37 x 45,3 mm fuer
    die vier Sprechtasten, 25 mm Abstand zur Set-Taste, aussen etwa
    131 x 95 x 35 mm. Die Platinen duerfen sich nicht beruehren - dann
    blieben seitlich nur 3,9 mm zwischen den Tastenkappen.
    [mitreden.ino]
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2026-08-19 Suche ohne Treffer richtig behandeln und anzeigen
    Zwei Fehler in einer Meldung:
    ARASAAC antwortet auf ein Wort ohne Treffer mit HTTP 404 und einer
    leeren Liste. Der Code hat daraus "ARASAAC nicht erreichbar: HTTP Error
    404" gemacht - fachlich falsch, der Dienst laeuft ja. Jetzt kommt eine
    leere Trefferliste zurueck und die Oberflaeche sagt schlicht, dass es zu
    diesem Wort nichts gibt.
    Und die Meldung stand als Zelle im Ergebnisraster und damit in einer
    96px-Spalte, was sie nach jedem Wort umbrach. Meldungen laufen jetzt
    ueber die volle Breite.
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2026-08-19 Bearbeiten vom Handy: --host und Umbruch fuer schmale Bildschirme
    app.py hoert weiterhin voreingestellt nur auf 127.0.0.1. Mit
    --host 0.0.0.0 ist die Oberflaeche im eigenen WLAN erreichbar; beim
    Start nennt sie die Adresse fuers Handy und sagt dazu, dass es keine
    Anmeldung gibt.
    Unter 620 px Breite bricht das Raster um: Set-Kachel ueber die volle
    Breite, die vier Sprechtasten als 2x2 darunter. Vorher passte in die
    Textfelder ein einziger Buchstabe.
    Startmeldungen jetzt mit flush - in eine Datei umgeleitet blieben sie
    sonst im Puffer haengen.
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2026-08-20 README kürzen, Details in docs/ aufteilen
    Aus 642 Zeilen README werden 56 plus vier Themendateien. Oben steht nur
    noch, was das Gerät ist, was es tut und wie man es startet; alles Weitere
    ist verlinkt.
    - docs/hardware.md Bauteile, Pinbelegung, Gehäusemaße
    - docs/software.md Weboberfläche, layout.json, Bauvorgang, Sprachausgabe
    - docs/firmware.md Übersetzen, Partitionsschema, Flashen
    - docs/betrieb.md vom Handy bearbeiten, Betrieb auf einem NAS
    Dazu inhaltlich:
    - Die Einleitung war Werbetext. Jetzt zwei Sätze in der ersten Person.
    - Sachlicher Fehler behoben: der Talker ist beantragt, nicht vorhanden.
    Ich hatte geschrieben, das Kind nutze bereits einen.
    - "Wie ehrlich ist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
2026-08-20 doctor.py: prüft die Voraussetzungen und sagt, was fehlt
    Ersetzt drei Absätze README durch etwas, das sich nicht von der
    Wirklichkeit entfernen kann. Läuft mit blankem Python ohne
    Abhängigkeiten - gerade dann, wenn noch nichts eingerichtet ist, soll es
    ja etwas Sinnvolles sagen.
    Unterscheidet, was wirklich nötig ist (Python, Pillow, ffmpeg) von dem,
    was nur Teilbereiche betrifft (Azure-Schlüssel, arduino-cli, Docker), und
    nennt für jedes Fehlende den passenden Befehl je nach Betriebssystem.
    Geprüft mit vollständiger Einrichtung und in einer nackten Umgebung ohne
    venv, .env und Inhalte - dort meldet es zwei fehlende Pflichtteile und
    gibt 1 zurück.
    Läuft in CI mit.
    Co-Authored-B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
2026-08-20 Verdrahtungszeichnung
    Aus der Tabelle liest man schlecht heraus, was geteilt wird und was pro
    Modul einzeln geht - genau das ist beim Löten die Frage. Die Zeichnung
    stellt das nebeneinander: sieben Leitungen an alle fünf, nur CS und KEY
    einzeln.
    Bewusst ohne verschlungene Leitungsführung. Bei fünf Modulen mit je neun
    Anschlüssen wird daraus ein Knäuel, das niemand liest; Farbe verbindet
    hier besser als Linien.
    Der Zeichner liegt als tools/verdrahtung.py mit im Repo. Ein PNG allein
    könnte niemand korrigieren, und korrigiert wird es sicher - die Angaben
    sind gerechnet, nicht gemessen.
    [verdrahtung.py]
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2026-08-20 Fachbegriffe auf Englisch, Fließtext bleibt deutsch
    "Container-Abbild" sagt kein Mensch. Deutscher Text mit englischen
    Fachwörtern ist das übliche Register - und "Partition Scheme" heißt im
    Arduino-Menü ohnehin so.
    Abbild -> Image Artefakt -> Artifact
    Bauvorgang -> Build Zwischenspeicher -> Cache
    Prüfsumme -> Hash Ablauf -> Workflow
    Partitionsschema -> Partition Scheme
    Über eine feste Wortliste ersetzt, nicht über ein Muster. Befehlszeilen
    und Bezeichner blieben unberührt: die vier FQBN-Aufrufe mit
    PartitionScheme=default_8MB stehen unverändert da.
    Geprüft: Python importierbar, Firmware übersetzt bei 14 %, build.py und
    der Formattest laufen durch.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
    [mitreden.ino]
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2026-08-20 Gehäuse: Kappen-Freiraum, Tiefenbudget und Innenlayout korrigiert
    Nachgerechnet statt geschätzt — vier Fehler im Entwurf gefunden:
    - Der Feather ragte 1,3 mm in den Deckel. Der Assert prüfte nur
    akku_d gegen die Innentiefe und vergaß die Distanzsockel. Die
    Innentiefe folgt jetzt aus dem höchsten Stapel auf dem Träger.
    - Die Fußkegel der ScreenKey-Dome standen 0,755 mm in der Bahn der
    beweglichen Tastenkappe. Alle fünf Tasten hätten geklemmt.
    - Das Bett des Verstärkers ragte 1,9 mm über die Trägerkante hinaus.
    - Der Schwerpunkt lag 8 mm über der Gehäusemitte.
    kappe_versatz_y wirkt jetzt wirklich als eine Stellschraube:
    kappen_freiraum() räumt die Kappenbahn über die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
    [mitreden-gehaeuse.scad]
2026-08-20 Gehäuse: Nachrechnung als Skript, Akku-Winkel 2-mannigfaltig
    nachrechnen.py liest die Maße aus der .scad und rechnet unabhängig
    nach — 60 Prüfungen von der Kinderhand über das Tiefenbudget bis zum
    Druckbett. Es dupliziert die Zahlen nicht, es prüft sie, und es
    braucht kein OpenSCAD.
    python3 gehaeuse/nachrechnen.py
    python3 gehaeuse/nachrechnen.py --versatz 1.5
    Dabei aufgefallen und behoben:
    - Die vier Akku-Eckwinkel bestanden aus je zwei Quadern, die sich nur
    an einer Kante berührten. OpenSCAD warnte beim Export, der Körper
    sei nicht 2-mannigfaltig. Jetzt ist jeder Winkel ein Polygon.
    - Wand- und Plattenstärke brauchen verschiedene Kriterien: senkrechte
    Wände sind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
    [mitreden-gehaeuse.scad]
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2026-08-20 Textfeld aus dem gewaehlten Symbol vorbelegen
    Beide Quellen liefern ein Wort zum Symbol mit - ARASAAC als Stichwort
    der API, METACOM aus dem Index. Bisher wurde es nur fuer den Dateinamen
    benutzt und danach verworfen.
    Jetzt fuellt es ein leeres Textfeld. Ausdruecklich nur ein leeres:
    das Symbol heisst "zustimmen", die Taste soll aber "Ja!" sagen -
    ueberschreiben wuerde die Texte verschlechtern. Die andere Richtung
    gab es schon, der Slot-Text ist das Suchwort beim Oeffnen des Dialogs.
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2026-08-21 Warnen, wenn kein Set mehr aktiv ist
    Zwischen einem und fuenf aktiven Sets war schon alles erlaubt - die
    Firmware rechnet mit setCount, geprueft von 5 bis 1 herunter. Auch null
    faengt sie sauber ab: showNoContent() zeigt einen Hinweis, das Geraet
    bleibt bedienbar.
    Gewollt ist dieser Zustand aber selten, und im Zaehler ging er als
    schlichtes "0 von 5" unter. Jetzt wird die Zeile bei null zu einem
    schmalen Warnfeld in denselben Farben wie der Speicherkonflikt und sagt,
    was das fuer das Geraet heisst.
    Bewusst keine Sperre: beim Umsortieren kurz alles abzuschalten bleibt
    moeglich.
2026-08-21 Schalter am Set heisst "Aktiv" statt "Auf dem Geraet"
    Im Kopf steht "Geraetevorschau", in der Set-Spalte stand "Auf dem
    Geraet" - zweimal dasselbe Wort in einer Ansicht, obwohl es um voellig
    Verschiedenes geht.
    "Aktiv" ist kurz und deckt sich mit dem Feld "active" in layout.json;
    wer die Datei aufmacht, findet dasselbe Wort wieder. Was es bedeutet,
    sagt jetzt der Titel des Schalters.
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2026-08-21 Kommentare auf Englisch: Firmware
    Vierter Schritt. Alle .ino und .h unter firmware/: die Hauptfirmware,
    die sechs Teststufen und die drei Kopfdateien.
    Deutsch geblieben ist, was das Geraet zeigt oder sagt: die Menuetexte
    ("Info", "zurueck", "Sets", "Datei-system", "da", "fehlt"), der Hinweis
    "Keine Inhalte auf dem Geraet." und die seriellen Meldungen. Die liest
    jemand beim Aufbauen, und zwar in der Sprache des Projekts.
    Die Begruendungen sind wieder mitgewandert, sie sind hier besonders
    wertvoll - warum die Set-Taste laenger gehalten werden muss (ein
    versehentlicher Wechsel nimmt ihr das Wort weg, das sie sagen wollte),
    warum der Rahmen nicht in der Bilddatei steht (dasselbe Symbol in zwei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
    [layout_format.h, pins.h, test1_board.ino, test2_display.ino, test3_displays.ino, vorlaut.ino]
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2026-08-21 Die Texte des Geraets kommen aus einer Tabelle, Englisch ist Standard
    Die Firmware zeigt selbst kaum Text - vier Menuebeschriftungen und den
    Hinweis auf einem leeren Geraet. Aber es ist das Einzige am Geraet, das
    an einer Sprache haengt, und es lag als Literale mitten im Zeichencode.
    Jetzt steht es in texts.h, eine Tabelle pro Sprache, en und de. Welche
    gilt, sagt der Inhalt: im Kopf von layout.bin lag bei Offset 7 ein
    reserviertes Byte, das build.py immer als Null geschrieben hat. Null ist
    Englisch, also bleibt eine aeltere layout.bin lesbar und die
    Formatversion darf auf 1 stehenbleiben.
    Damit gilt fuer die Sprache dasselbe wie fuer Sets und Farben schon
    laenger: sie reist mit dem Inhalt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
    [layout_format.h, texts.h]
2026-08-21 Firmware zieht die Texte aus der Tabelle, Rest auf Englisch
    Alle Zeichenketten im Sketch gehen jetzt ueber text(), und das Zeichnen
    zweier zentrierter Zeilen steht einmal in drawTwoLines statt zweimal
    fast gleich in drawMessage und drawMenuKey.
    Dabei den Rest der Uebersetzung nachgeholt, die beim letzten Durchgang
    nur halb passiert war. Es standen noch Bezeichner wie puffer, gelesen,
    ergebnis, pfad, zahl, jetzt, gehalten, schlaf im Code, und ein paar
    Kommentare waren mittendrin umgekippt:
    // holding, a countdown runs; whoever lets go
    // bricht ab.
    // Most common cause: the wrong partition scheme. The default of the
    // Boards (tinyuf2) legt den Datenbereich als "ffat" an, LittleFS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
    [pins.h, vorlaut.ino]
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2026-08-21 Doku und README zur Sprache des Geraets
    docs/software.md beschreibt das Feld "language" in layout.json,
    docs/firmware.md was sich zeichnen laesst und was nicht, samt der neun
    Zeichen pro Zeile. Die Zahlen zum Speicherverbrauch dort waren leicht
    veraltet und sind jetzt gemessen.
    Die README sagt bisher, das Produkt sei durchgehend deutsch. Fuer den
    Talker stimmt das nicht mehr.
    Nebenbei zwei Reste: "removed:" war im Bau-Protokoll auf Englisch
    gerutscht, obwohl das Protokoll in der Oberflaeche landet und deutsch
    ist. Und in build.py hiessen zwei Variablen breite und höhe - ein
    Umlaut in einem Bezeichner.
2026-08-21 Eine Tabelle fuer jedes Wort, das jemand liest
    Die Trennung in diesem Projekt laeuft nach Leserschaft: was ein
    Entwickler liest, ist englisch, was die Familie liest, ist ihre Sprache.
    Das funktioniert, solange die beiden sich nie begegnen. An genau einer
    Stelle tun sie es doch - das Bauprotokoll und die Fehlermeldungen
    schreibt die Kommandozeile, angezeigt werden sie in der Oberflaeche.
    texts.py loest das: 115 Schluessel, en und de nebeneinander. Wer eine
    Meldung ausloest, sagt welche und mit welchen Werten; wer sie anzeigt,
    entscheidet die Sprache.
    Bewusst ein Python-Dict und keine locales/*.json. Eine Uebersetzerin
    muss wissen, wo ein Text steht und wieviel Platz er hat - beim
    Geraetemen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
2026-08-21 Oberflaeche zweisprachig, mit Umschalter oben rechts
    Die Seite wird pro Anfrage in einer Sprache ausgeliefert: der Server
    setzt die ui.*-Tabelle in die Vorlage ein, das Markup traegt keinen Text
    mehr, und jede Beschriftung geht durch t(). Kein if/else pro Label und
    keine zweite Kopie aller Zeichenketten im Browser.
    Der Umschalter speichert wie jede andere Aenderung und laedt die Seite
    neu. Er zeigt die Sprachen in ihrer eigenen Sprache - wer Englisch
    sucht, kann nicht "Englisch" lesen muessen.
    Es ist dasselbe Feld wie fuers Geraet. Ein Talker, dessen Menue "back"
    sagt, waehrend der Rechner daneben "zurueck" sagt, waere nur eine
    weitere Sache, die synchron bleiben muss. Die Inhalte bleiben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
2026-08-21 Doku zur Zweisprachigkeit
    Die README sagte, das Produkt sei deutsch. Es gibt es jetzt auf beiden
    Sprachen, und die Trennlinie ist eine andere geworden: nicht mehr
    Oberflaeche gegen Code, sondern was jemand benutzt gegen was beim
    Weiterentwickeln gelesen wird.
    docs/software.md beschreibt das Feld, den Umschalter, und was es
    ausdruecklich nicht anfasst - die Inhalte.
2026-08-21 Sprachumschalter auf DE und EN kuerzen
    "Deutsch" und "English" lesen sich netter, kosten auf einem 375 px
    breiten Display aber ein Drittel der Kopfzeile. Ein zweibuchstabiger
    Sprachcode ist ausserdem das eine Etikett, das keine Uebersetzung
    braucht. Was der Kasten ist, sagt der Titel.
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2026-08-21 Ein Knopf statt zwei: Freigeben
    Speichern kann weg. Autosave laeuft seit jeher eine Sekunde nach dem
    letzten Tastendruck, und beforeunload warnt, wenn doch etwas aussteht -
    der Knopf hat nichts getan, was nicht ohnehin passierte.
    Bauen bleibt, heisst aber Freigeben. "Bauen" beschreibt, was der Rechner
    tut; interessant ist, was fuer das Geraet dabei herauskommt: dieser Stand
    ist jetzt abholbar. Der Titel sagt es auch so - "Es gibt Aenderungen, die
    das Geraet noch nicht holen kann" statt "Das Geraet bekommt erst durch
    Bauen und Aufspielen den neuen Stand".
    Getrennt bleiben die beiden aus einem Grund, der leicht untergeht:
    Freigeben loest Azure aus. Automatisch gekoppelt wuerde ein Satz beim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
2026-08-21 Firmware-CI war seit vier Laeufen rot
    test6_wlan.ino:24:10: fatal error: WiFiManager.h: No such file or directory
    Ich habe den Sketch in die Matrix eingetragen und die Bibliothek nicht,
    und danach nicht nachgesehen, ob es gruen wird. Vier Commits lang rot.
    WiFiManager wird jetzt mitinstalliert, und test7_sync steht auch in der
    Matrix - sonst passiert dasselbe gleich nochmal.
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2026-08-21 Stufe 7 und der Menuepunkt: Inhalte holen
    test7_sync macht den Abgleich und sonst nichts - keine Displays, kein
    Ton, kein Schlafen. Wenn am Sonntag etwas klemmt, ist es dann dieses eine
    Problem und nicht eins von sechs gleichzeitig. Dafuer sind die Stufen da.
    In der Hauptfirmware haengt es an Menuetaste 2. WLAN bleibt im normalen
    Betrieb aus: das Geraet wacht auf einen Tastendruck auf und muss sofort
    sprechen, ein Funkchip beim Aufwachen kostet Sekunden und den halben
    Akku - fuer etwas, das hoechstens woechentlich gebraucht wird. Es kommt
    hoch, wenn jemand danach fragt, und geht danach sofort wieder aus.
    Serveradresse und Schluessel fragt dasselbe WLAN-Portal ab wie die
    Zugangsdaten, gespe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
    [vorlaut.ino]
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2026-08-21 Mehrere WLANs, und ein Menuepunkt zum Nachtragen
    Der Talker faehrt mit: Kindergarten, Oma und Opa, Urlaub. Sprechen ging
    dort schon immer, das Nachladen nicht - es gab genau ein WLAN, einmal im
    Portal eingetippt und nur durch Zuruecksetzen zu aendern.
    networks.h haelt jetzt vier Netze, zuletzt benutztes zuerst. Der ESP32
    selbst merkt sich eines und WiFiManager gibt eines weiter, deshalb liegt
    die Liste daneben in NVS; WiFiMulti scannt und nimmt das staerkste
    bekannte aus der Luft. Ein Netz, das woanders steht, kostet nichts.
    Menuetaste 3 oeffnet das Portal ("neues WLAN"). Das Nachladen oeffnet es
    nicht mehr: in einem fremden Netz sagt es nach ein paar Sekunden "kein
    WLAN", statt mitten im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
    [texts.h, vorlaut.ino]
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2026-08-21 Ein frisch geflashtes Geraet spricht sofort
    Bisher zeigte ein Geraet nach dem ersten Flashen auf allen fuenf Displays
    "keine Inhalte". Richtig, dokumentiert - und die schlechtesten dreissig
    Sekunden des ganzen Projekts. Jetzt liegt der Beispielinhalt mit im
    Abbild: eine Datei schreiben, und der Talker sagt Ja!, Nein!, Stopp und
    Hilf mir.
    Dafuer liegen die vier Saetze fertig gesprochen in example/speech/.
    seed_example_speech() legt sie in den TTS-Cache, mehr braucht es nicht -
    der Build sucht einen Satz ueber seinen Fingerabdruck und nimmt eine
    Datei, die schon dort liegt, wie sie ist. Derselbe Weg, auf dem ein
    gecachter Satz ohne Schluessel neu gebaut wird.
    Ohne das braeuchte die Freigabe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
2026-08-21 Azure-Schluessel und METACOM beim Zahnrad
    Die beiden Abschnitte, fuer die das Blatt schon Ueberschriften hatte.
    Beide schreiben nach .env, ueber config.py.
    Der Schluessel geht nur vom Rechner selbst aus zu setzen. Inhalte vom
    Handy zu aendern ist der Sinn von --host 0.0.0.0, und daran ist nichts,
    was vor dem eigenen Haushalt geschuetzt werden muesste - beim Schluessel
    schon: er ist jemandes Rechnung und laesst sich wieder auslesen. Die
    Seite sagt das, statt das Feld zu verstecken. Im Container ist die Frage
    nicht zu beantworten - es kommt immer das Bridge-Gateway an -, also ist
    es dort erlaubt, sonst spraeche man jemanden auf seiner eigenen NAS aus.
    Zurueck an die Seite geht der Schluessel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
2026-08-21 Das Einstellungsblatt zeigt sich nur noch offen
    Die Regel fuer das Blatt hat display unbedingt gesetzt. Der Browser
    versteckt ein geschlossenes dialog aber nur aus seinem eigenen
    Stylesheet heraus, mit dialog:not([open]) { display: none } - und das
    verliert gegen alles, was hier steht. Damit stand das Blatt vom Laden an
    in der Seite: nicht mittig und nicht obenauf, sondern im normalen Fluss,
    also ganz unten hinter allem anderen. Schliessen nahm das open-Attribut
    weg und sonst nichts, und zu sehen war die nie gefuellte Vorlage, nicht
    der Dialog.
    Gekommen ist es mit dem scrollenden Blattkoerper, der die Flex-Spalte
    brauchte. Die Spalte bleibt, sie gilt jetzt nur noch mit [open].
    tests/test_d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
2026-08-21 build.py in sieben Module zerlegt, build.py bleibt die Fassade
    build.py waren 1181 Zeilen mit vier Aufgaben darin. Wer aendern wollte, wie
    eine Kachel gezeichnet wird, scrollte am Layout-Modell, am Binaerformat und
    am esptool-Aufruf vorbei. Die Abschnittskommentare markierten die Nahtstellen
    laengst - entlang dieser Naht ist jetzt geschnitten:
    buildbase.py BuildError, write_json, short
    layout.py layout.json - lesen, pruefen, zurueckschreiben
    tiles.py eine Symbolangabe und das Bild, das daraus wird
    layout_format.py layout.bin, die Tabelle fuer die Firmware
    manifest.py was in data/ liegt und ob es noch aktuell ist
    builder.py der Build selb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
2026-08-21 Retire the build.py facade and import from the modules that own the names
    When build.py was split into seven modules it stayed behind as a facade
    re-exporting the old public surface. That kept the split reviewable and left
    app.py alone while another session was rewriting it. Both reasons have since
    expired: app.py has been rewritten twice, the page was extracted out of it and
    the routing replaced, so the compatibility the facade held open was
    compatibility with nothing.
    It re-exported 81 names. Around 46 were imported by anyone, so more than a
    third of the surface existed for no caller, and every one of them put a module
    boundary between a reader and the definition - build.load_layout does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
    [layout_format.h, texts.h]
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2026-08-21 Translate the German left in builder.py
    Six places, which the umlaut rule never saw and the rule that replaced it sees
    only one of:
    the module docstring's "gesprochener Satz" for the WAV it writes
    the "# Kacheln" heading over the tile half of prune_cache
    "removed: Kachel <name>", printed per pruned tile
    "N verwaiste Sprachdatei(en) und M Kachel(n) removed", the prune summary
    "Fehler: {exc}" on stderr, twice, from both arms of main()
    tests/german.py flags only the summary line, because it counts German function
    words and the other five carry nouns - Kachel, Fehler, Satz. That is the limit
    the rename commit wrote down for identifiers, and it applies to nouns in prose
    the same way: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
2026-08-21 Move the language picker into the settings sheet, and let it say Deutsch
    The header carried a two-letter select. It cost 63px, and on a 375px phone
    that was the difference between a header of one row and a header of two: the
    release button did not fit beside it and dropped onto a line of its own.
    Shrinking the select does not help - 54, 44 and 34px all still wrap, because
    the four remaining items already fill the bar. Taking it out is the only
    thing that changes the outcome, and it does: 103px of header becomes 58px,
    and the bar now needs 321px rather than 493px to stay on one line.
    So it moves into the settings sheet, where there is room to write the
    languages out. It is the first section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
2026-08-21 Finish the sentence the countersink comment stops in the middle of
    spk_screws() carries a comment that ends on "narrower towards the" and then
    runs into code. It has read that way since 13915ea, which translated
    // Senkung von front: Loch unten weit, nach hinten enger — druckbar
    and dropped the last two words along with the line break. What went missing is
    not decoration: "druckbar" is the reason the cone is oriented that way round.
    Wide at the face and narrowing towards the back prints without support, and a
    countersink the other way up would need it - which is the one thing the whole
    model is built to avoid.
    Found while going over case/ for German after 0999827 had already transla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
    [vorlaut-case.scad]
2026-08-21 Pull the published image by default, and stop start.sh building anyway
    Three things stood between somebody with assembled hardware and a running
    setup, and all three were half-solved already.
    **The published image went unused.** .github/workflows/docker.yml builds
    ghcr.io/steffipetaffy/vorlaut:latest for amd64 and arm64 on every change to
    the Dockerfile or requirements.txt, with a comment saying the ARM build is
    there so a NAS can pull instead of build. But docker-compose.yml said
    "build: ." and operation.md told the reader to hand-edit that line into an
    "image:" - so the default did the slow thing and the fast one was an
    instruction to edit a file. Inverted: docker-compose.yml now names th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
2026-08-21 Bake the four voices into the image, at /voices
    The image paid 200 MB for onnxruntime and then shipped a talker that could
    not speak: a fresh container showed "Nothing here can speak yet" until
    somebody pressed Fetch voices and waited out a quarter of a gigabyte. The
    expensive half was paid and the cheap half skipped.
    Not under /app. docker-compose.yml mounts the project over it as ./:/app,
    and that mount replaces the directory wholesale - anything baked into
    /app/voices is invisible once the container runs, and looks exactly like a
    download that never happened. /voices is outside the mount, and
    VORLAUT_VOICES now really points at it, which tts.py has claimed since
    before the variable was s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
2026-08-21 Do not write a setting into .env that the environment hands in
    Opening the gear in the container and pressing save was enough to leave
    a .env that no longer starts: "bind source path does not exist:
    /metacom". The field shows VORLAUT_METACOM_DIR, docker-compose.yml sets
    that to /metacom - the path *inside* the container - and reads the same
    variable back for the host side of the mount. So the sheet offered the
    container's own path as if it were a setting, and saving wrote it over
    the host path the mount depends on.
    Nothing on screen changed at the time, which is why it went unnoticed:
    config.value() takes the environment first, so the line written into
    .env never reached the process that wr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
2026-08-22 Run the container as a user who is not root, and stop it shadowing its own code
    Three things that were wrong together, and are one change because each of them
    is what made the next one hard.
    Without a USER, everything the app wrote through the bind mount belonged to
    root on the host - on a NAS that means you cannot edit your own child's
    content over the share without sudo. There is a vorlaut user now, and /app
    stays root-owned so the app can read its code but not rewrite it.
    The cost is that the host's id has to be handed in: which id owns the files on
    the NAS is a fact about the NAS and nothing in the container can find it out.
    Hence user: "${VORLAUT_UID:-1000}:${VORLAUT_GID:-1000}" - nam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
2026-08-22 Wait on the healthcheck, and publish an image you can pin to
    The two files another session was in, now that both have landed.
    start.sh loses its curl loop. "docker compose up -d --wait" returns when the
    healthcheck passes, which is the interface answering, and fails the command if
    the container never gets there - so there is nothing left to poll and nothing
    left to check afterwards. What stays is the work the loop was never doing: the
    port-in-use check for a directly started app.py, and clearing away a container
    of the same name that Docker would otherwise refuse.
    It also makes data/ first. A missing bind source is not handled the same way
    everywhere - some Dockers refuse to start the cont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
2026-08-22 Translate the last German in tools/, and give the detector `fehlt`
    tools/icons.py still had German identifiers and one German string, the last of
    them anywhere in tools/. GROESSEN, quelle, groesse and ziel become SIZES,
    source, size and target, and "cairosvg fehlt." becomes "cairosvg is missing.".
    That message is the whole of what somebody sees when they edit the SVG without
    cairosvg installed, so it was also the last German a user of this repo could
    be shown from a tool.
    tools/voices.py and tools/wiring.py were read for the same thing and have
    none. The one German word left in tools/ is the path in voices.py's docstring
    to voices/LIZENZ.md, which is a filename rather than prose - the same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
2026-08-22 Let the image stand up without the compose file
    VORLAUT_CONTENT and VORLAUT_ENV_FILE were set in docker-compose.yml alone, so
    a plain "docker run" of the published image fell back to ROOT/content - that
    is /app/content, which is root-owned while the app is not - and died on
    PermissionError before serving anything. They are ENV in the Dockerfile now,
    next to VORLAUT_VOICES, and out of the compose file so there is one place to
    change them.
    With that, the README leads with a one-line "docker run" against a named
    volume. Docker makes the volume and it inherits /data's owner from the image,
    so the "mkdir -p vorlaut/data" the bind mount forced is gone from the way in -
    a missing bind source is a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
2026-08-22 Pin piper to the version the image already ships
    The Dockerfile installed piper-tts unversioned, so every unattended
    rebuild of the published image took whatever was current that day, and the
    last good one could not be reproduced. The image on ghcr.io today has
    1.7.0; that is what this pins to, so the pin records what has actually
    been running rather than introducing a change.
    Pinned exactly, and more tightly than Pillow, because the failure it
    guards against is different. Pillow can break an API and the build stops.
    piper renders the audio, and nothing downstream can tell that it changed:
    tts.fingerprint() covers the text, the model, the ffmpeg chain and
    PIPELINE_VERSION, but not the versi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
2026-08-22 Put the piper version in the fingerprint, so a bump renames what it changed
    A cached WAV is named by tts.fingerprint(), which covered the text, the
    model, the ffmpeg chain and PIPELINE_VERSION - but not the version of piper
    that spoke it. So a piper release that altered how a voice sounds left every
    existing recording in the cache under a name claiming it matched the new
    ones. Nothing anywhere would have said so; the first symptom would have been
    two sentences on one device sounding like two different people.
    A constant, not the installed version. Reading importlib.metadata would be
    the obvious way and is the wrong one: voice_config() promises a name derived
    from the voice id alone, no disk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
2026-08-22 Make the bring-up sketches and document usable at a bench
    The test sketches printed German diagnostics - `Stufe 1: Board`,
    `Versatz %d/%d`, `nicht verbunden` - and those lines are the only
    instrument there is when the hardware arrives. Translated all of them,
    plus the German comments in the same files and in pins.h. Seven stages
    now announce themselves the same way instead of three.
    tests/german.py gains the diagnostic nouns from those lines. They do not
    close the gap: a printed line is short and mostly format specifiers, so
    it carries no function words to count and the two-word rule for code
    still lets a single German noun through. Treating a quoted string as
    prose would close it and was m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
    [pins.h, test1_board.ino, test2_display.ino, test3_displays.ino, test4_buttons.ino, test5_sound.ino, vorlaut.ino]
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2026-08-22 Speak and level a sentence in a tab, and measure it against ffmpeg
    The app half is being rewritten as a static site, so the two programs that
    make a recording today - piper and ffmpeg - have to happen in a browser.
    mitreden's spike answered half of this already and its answer is taken as
    given: piper runs through vits-web, and ffmpeg.wasm must not do the levelling,
    because its core is built from ffmpeg 5.1.4 and gets the gain wrong by 13 dB
    on half of all short sentences without saying so.
    So the levelling is written out: trim, fade, pad, BS.1770, one gain, a true
    peak ceiling, a WAV header. No lamejs - vorlaut wants WAV, not MP3 - and no
    dependencies at all. It is free of the browser on pu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
    [leveling.py]
2026-08-22 Name it like the tile check, because it is the same arrangement
    tools/tilecheck.py landed on main while this was being written and is the same
    shape down to the details: a Python oracle, a page that runs the JavaScript
    rewrite of it, a PUT back so a shell can measure what the browser produced.
    There is no reason for the speech one to be called something else, so it is
    not: leveling.py is ttscheck.py, and the page moves to tools/ next to
    tilecheck.html.
    The page moving out of static/ is worth more than the naming. In static/ it
    was served to every user of the running app at /static/tts/check.html - a
    developer's page with a "Forget the models" button on it, shipped.
    Two fixes found while re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
2026-08-22 One list of modules the page has not reached yet, not three
    The static-site rewrite is landing a module at a time, each ahead of the page
    that will import it, and check_every_module_is_reachable() has to be told
    about each one. It was told twice, in two sets a hundred lines apart:
    NOT_ON_THE_PAGE for tiles.js and NOT_LOADED_YET for layout_format.js, with
    near-identical comments, written by two people who could not see each other.
    The speech modules would have been the third. They are all one idea, so they
    are now one dict - name to the test that runs the module, because that is the
    thing that makes the exception affordable.
    The glob is the real fix, though. scripts() looked at static/*.js a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
2026-08-22 Force the tainted-canvas path, and say what the device may carry
    Three things the board-designer session asked for after reading the first pass.
    The fallback now has a test that makes it happen rather than hoping it does
    not. It was the weakest part: the cross-origin path only appears when an image
    fetch fails, so it passes every local run and waits for a bad network to break
    a build. tools/symbolcheck.html now drives both halves — a plain <img>, which
    must come back tainted, and loadImage(), which must read back. Asserting the
    first is the point: without it the test would pass just as happily if the
    hazard had quietly gone away, and prove nothing about the guard.
    Vendoring is no longer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
2026-08-22 Put a seam between the page and the outside, before the browser fills it
    The four browser halves the rewrite needs already exist and are already
    measured against the Python they were ported from: tiles.js renders a tile
    byte for byte as tiles.py does, layout_format.js writes a layout.bin all
    three implementations agree on, tts/speak.js and tts/level.js speak and
    level a sentence, symbols.js finds a symbol through bildquelle. None of
    them is imported by anything. What was missing was not more browser code,
    it was somewhere to put it.
    The coupling is not in those modules - they are already transport-free,
    which is why they could be measured at all. It is in the other eight, which
    between them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
2026-08-22 Look below the top of static/ for markup built out of borrowed values
    check_no_composed_markup() is the guard against a module handing the HTML
    parser a string it composed rather than wrote, and scripts() fed it
    static/*.js - the top level and nothing under it. static/tts/level.js and
    speak.js were exempt from the rule entirely by sitting one directory down, and
    nothing said so. The same hole was in tests/test_ui_texts.py and 6920e89 closed
    it there; this is that fix, arriving late in the file next door.
    rglob alone would have been wrong, though. It would also start reading
    static/vendor/bildquelle/, which is three built files including a minified
    jszip. They pass today, so nothing would ha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
2026-08-22 Reserve the one operation that will not fit, before the file sets
    The seam names what the page asks the outside for, and every name in it is
    request/response: ask, get a value, done. Sending a build to the talker is
    not going to be, and it is the only thing in the eventual contract that is
    not. Over Wi-Fi the question does not arise - the device pulls on its own
    schedule and the page is not in the conversation - so the omission reads
    today as completeness rather than as a gap.
    Over a cable it becomes a gesture, a port the user grants, an open stream,
    about 1.5 MB with progress worth watching, a cancel that has to arrive
    mid-flight, and a close. Added later by someone matching the surroundin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
2026-08-22 Check the URL the page writes down against the one speak.js uses
    ui.html does not map onnxruntime-web yet - nothing it loads asks for one - so
    the entry sits in a comment there, written out for whoever wires speech up.
    That is the right call, but it leaves the same URL in two files with nothing
    reading one from the other, and a comment rots more quietly than a mapping
    would because nothing at all depends on it being true.
    The drift is the kind worth catching. vits-web loads its runtime binaries from
    a fixed 1.18.0 path, so a page naming a different onnxruntime fails deep inside
    the runtime with nothing readable attached - which is the exact failure the pin
    in speak.js exists to prevent, rei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
2026-08-22 Two things called rate, meaning a speed and a sample rate
    Found by the voice-package session porting speak.js to TypeScript, where the
    compiler refused what this accepted. speak() handed one options object to both
    halves and both read a field named "rate": to Azure it is how fast the voice
    speaks, "-5%", and to the levelling it is the sample rate of the WAV, 16000.
    Nothing set either, so nothing had gone wrong yet. The first caller to set one
    would have got the other one wrong.
    Neither direction failed the way the report expected, and one is worse. The
    sample rate reaching the SSML throws a TypeError about String.replace, which
    is ugly and four frames from the cause but is at least an error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
2026-08-22 Say "a byte above ASCII" with an escape, not with a German word
    test_language.py keeps German out of the code, and it only reads tracked
    files - so this fixture passed while it was still untracked and failed the
    moment it was committed. The escape is what the case was about anyway: the
    point is a byte the name may not contain, not which language it comes from.
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2026-08-22 Test the encoding, not the German
    tests/test_language.py was right to fail this. The fixture that exercised
    non-ASCII bytes did it with German prose - "Draußen", "Können wir rausgehen?"
    - because vorlaut's content usually is German, and the detector cannot tell a
    deliberate fixture from a line somebody forgot to translate. Nor should it
    have to: the rule is that the code is English, and a test reading as German
    because its subject is encoding is the code being unclear about what it
    checks.
    What the case is actually for is byte width, so it now says so: one character
    from each width UTF-8 has - ASCII, two bytes, three, and an emoji, which is
    four and a surrogate pair in JavaScript's own st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
2026-08-22 Let the bench push a real build, and write down what a first run has to show
    Two things ahead of the hardware, both from the sessions either side of this
    one.
    The bench can now take its payload from the editor rather than inventing one.
    buildManifest() and buildFile() in static/backend.js are the two operations the
    transport needs permanently - answered over HTTP today, out of local storage
    once the browser builds for itself - so pushing what build.py already made puts
    nothing of the browser rewrite in tonight's path. No File System Access, no
    tiles.js, no speak.js. If the transfer fails it is the wire or the firmware,
    which is the whole point of doing it in this order.
    That needs the page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
2026-08-22 Write down how to run the cable on a device, so nobody needs this session
    Prep rather than a run: the boards are here but the test is for later, so what
    was in my head goes in the document instead.
    Adds the steps end to end - the USB CDC On Boot setting that stops everything
    before it starts, flashing the program alone (the content does not have to go
    with it, which is the point of the cable), building something to send, serving
    the bench from app.py, and what to watch on the device rather than only in the
    page. Including the two symptoms that look like bugs and are not: a serial
    monitor holding the port, and a port that does not answer hello being a
    different problem from a transfer that f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
2026-08-22 Write down the outside opinions before they are deleted
    Four subsystems exist twice while the app moves into the browser, and the
    Python halves are on a deletion path. They are also most of the reason anybody
    knows the JavaScript halves are right. mitreden found out what that costs: when
    it deleted its Python half it discovered its browser audio tests measured the
    output with the same function that had decided the gain, and a wrong
    implementation would have satisfied every one of them.
    So the outside opinions are frozen now, while there are still outside opinions
    to freeze. Nothing is deleted here; this exists to make that safe.
    The speech chain was the worst of the three. test_browser_tts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
2026-08-22 Measure the four seconds instead of trusting them, and skip keywords properly
    CABLE_QUIET_MS is the one constant here with a real risk behind it: it has to
    outlast any pause LittleFS can take mid-transfer, and nothing on a computer can
    say what that is. A run that works only shows the pause did not exceed four
    seconds once. It says nothing about the margin, and a constant that survived
    one evening is not evidence.
    So the device reports two numbers before every ok:
    gap the longest stretch that file spent with nothing arriving
    stall the longest single write into LittleFS
    Two, because they are two different risks and one hides the other. gap is what
    the timeout is actually compared a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
    [cable.h]
2026-08-22 Say that freezing an oracle does not retire it
    The seam session read the previous commit and asked which of two things it
    was, having watched two people today act on a plausible reading and be wrong.
    The question was fair: a commit that freezes an oracle's output, and says it
    exists to make a later deletion safe, reads as though the deletion is now
    safe. It is not, and nothing here was deleted.
    The distinction the document was missing is the one that matters. A live
    oracle re-derives the answer for any input; a fixture only answers for what
    was recorded. So these files keep regression detection on the recorded set and
    do not keep the ability to say what the right answer is for a case nobody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
2026-08-22 Compare the bytes the device will get, not their length
    storecheck.html checked that a file came back from the store with the right
    byteLength and called it whole. That was enough while the store held nothing
    anybody else read. It no longer does: these bytes now go store -> buildFile()
    -> tools/cable.js -> LittleFS, and the transport session has already pushed a
    real build down that path.
    Nothing downstream re-derives them. A tile is named after its input, so a byte
    that changed in here would travel under a name saying it had not - past a
    CRC-32 taken over whatever the store handed back, which is the changed bytes -
    and the device would draw it. Length is the one property that survives almo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
2026-08-22 Say which module is missing, and that the references outlive it
    Another session is part-way through replacing static/tts/level.js with the
    vendored stimmquelle package. The suite met that as an ERR_MODULE_NOT_FOUND
    and a node stack trace, which is true and tells the reader nothing: the
    failure is about the subject of the test, not about the test.
    It matters more than an ordinary unhelpful error, because the obvious way to
    make it green again is to delete the suite along with the module - and that
    would throw away the only external check the speech chain has, at exactly the
    moment a reimplementation most needs one. The frozen references are not
    measurements of level.js. They are what real ff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
2026-08-22 Prove the cable checks bite, and fix the five faults they let through
    The freeze session's second lesson, taken: a fixture that catches nothing looks
    exactly like one that catches everything, because both pass. The only way to
    tell them apart is to break the thing on purpose and watch.
    tools/cablemutate.py introduces 23 faults one at a time and reports which ones
    the suite notices. The first run caught 12. Every one of the five misses was a
    real hole rather than a missing assertion:
    * A checksum that lost its zero padding. Every value in the fixture happened
    to have eight significant digits, so "%lx" and "%08lx" agreed on all of
    them - the case the format string exists for was th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
    [cablemutate.py]
2026-08-22 Write down what the mutation run showed, including what it cannot reach
    The evidence belongs next to the claim rather than in a commit message: 23 of
    23 with both controls surviving, the five that were missed first time and why
    each was a real hole, and the honest boundary - cable.h needs Arduino, is not
    compiled here, and so the .part rule, the timeouts and the drain have nothing
    behind them but a bench run.
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2026-08-22 Give an imported board the colour and the shape it arrived without
    documentToLayout() answered with sets whose colour was "" and whose slot count
    was whatever the foreign board felt like. That is not a layout anybody may
    save, and the function that fixes it is normalize_layout() - which is in
    layout.py rather than in obf.py, and is therefore the easiest half of this
    port to walk straight past. document_to_layout() ends in it, so a browser
    import without it stops one function short of a usable file.
    So it is ported and measured the same way the mapping was, against layout.py
    and on the inputs where two implementations of one rule drift: a timeout
    written as a string, as a float, as true, as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
2026-08-22 Write down what obf.py says, before it stops being here to ask
    The Python halves are being deleted now rather than after the browser has been
    proven on hardware, and the tests are being fixed forward. This is the part of
    that which cannot be done afterwards: obf.py is the only thing that has ever
    known whether static/obf.js maps a board correctly, and once it is gone the
    answer cannot be re-derived from anything in the repository.
    The other three subsystems each have a second opinion that survives - Pillow is
    one renderer among renderers, layout.bin has the firmware's own C reader
    compiled at test time, the speech chain has ffmpeg. A .obf is a mapping this
    project invented. There is no outs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
2026-08-22 Delete the Python half; the browser is the whole product now
    57 files: the server, the build, the converters, their tests, their tools and
    the two documents that were about them. What is left is a page, a firmware, and
    the checks that hold one to the other.
    Nothing here is the last step of a migration that had been planned in stages.
    The bar written down earlier was "replaced and proven on the bench", and the
    bench run has not happened - the boards arrived today and the cable path has
    never touched real hardware. Deleting first was decided anyway, on the grounds
    that nobody uses this yet, the formats are early, and carrying a second
    implementation to answer questions nobody is asking was th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
2026-08-22 Stop docs/cable.md telling people to run files that are not there
    The Python went, and this document was still giving instructions built on it:
    run build.py, run app.py, open the bench on port 8798. Every one of those is
    now a command that fails.
    What replaces them is shorter, because the bench needs less than it did. Any
    static server will do - it has no back end and localhost is a secure context,
    which is all WebSerial asks - and the payload comes from the directory picker,
    which reads firmware/vorlaut/data/ off the disk with nothing in between. For a
    first run on hardware that is the better source anyway: a failure is then the
    wire or the firmware rather than one of several new things at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
2026-08-22 Ask the OBF converter to close its own loop
    The seam session's idea, handed over as they ran out of context. A lock file
    answers for the cases recorded in it and no others, and for this converter that
    limit is permanent: obf.py is gone, so no case can ever be added. A round trip
    needs no oracle - documentToLayout(layoutToDocument(x)) == x holds for any
    correct mapping on any input - so it covers exactly what the lock cannot, and
    it survives having no Python.
    It found something on the first run. A layout with no sets cannot round trip:
    Open Board Format carries the locale on a board, and no sets means no boards,
    so the language has nowhere to travel and comes back as the default. That is
    the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
2026-08-22 Build the page with Vite and TypeScript, and let the types find the bugs
    The no-build-step stance is over, and it was load-bearing prose: backend.js,
    both VENDORED.md files and the workflow each argued that native modules and an
    import map were a destination rather than a stopgap, on the grounds that the
    project had no node_modules, no lockfile and no CI to run them. It has all
    three now, so those paragraphs are gone rather than left to read as current.
    npm was already the answer next door. bildhaft depends on bildquelle as
    github:Lautstark/bildquelle#<sha> - a git dependency pinned by commit, built
    through the package's own prepare script, no registry involved. That mechanism
    was available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
2026-08-22 Take stimmquelle v2.0.2, and delete the types workaround it needed
    The tsconfig comment said to delete the paths override once upstream pointed at
    its own declarations, and to let typecheck say whether it was needed. Upstream
    did, in 2.0.1: main and types named ./dist/index.js while tsc was emitting
    ./dist/src/index.js, and ./browser carried no types at all. Both fixed, so the
    override now names a path that does not exist. tsc -b is clean without it.
    2.0.2 is the one to take rather than 2.0.1: the committed browser build had
    become a re-export shim plus a chunk.js, which does not matter here now that
    this is a Vite app resolving through the exports map, but it does matter to the
    pin agreein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
2026-08-22 Build in the browser, so the Release button does what it says
    runBuild() was the last question in the seam with no answer behind it. It
    threw, and it threw in English into a page that may be German - the smaller
    half of the same problem: builder.py's orchestration went with the Python, and
    so did the 72 build.* labels the log was written in. Both halves land here.
    The orchestration is builder.py's, down to the order of the log: what is
    active, what has no symbol, what has no text, what would not speak, what was
    thrown away, what was written. Only the parts that were about a disk and a
    server had to move. Three are worth naming, because each could reasonably have
    gone the other way:
    The nam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
2026-08-22 Make the editing loop actually work, and hold it with a happy-path e2e
    The deployed page failed the first person who sat down with it, in ways the
    whole gate was blind to. Every press of a play button answered "Cannot play:
    is not in the catalogue, so it must not be fetched" - a refusal with no name
    in it - and the placeholders under the symbols named a symbols/ folder that
    died with app.py.
    The play failure is a parity bug from the deletion. To app.py, an empty voice
    meant "the board's chosen one", and local.ts forgot that when it took the
    route over: it handed "" straight to stimmquelle's catalogue, which refuses
    what it cannot find. synthesise() now falls back to the layout's voice, and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
2026-08-22 Resolve METACOM references by name, list Azure's voices, carry the key
    "metacom symbols still dont work" was three failures stacked, and the deepest
    one had never worked in any session. A metacom: reference stores a bare name -
    deliberately, so a board survives its collection moving to another disk - and
    bildquelle's ids are paths into one particular copy. Nothing translated
    between the two: getImageUrl("sprechen2") asked for a path that never existed,
    answered null, and every metacom: key drew its placeholder with the folder
    connected, the index built, and nothing anywhere saying why. bildquelle
    v1.1.0 adds idForName() - the stem, exact or null, never ranked - and
    picture() resolves through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
2026-08-22 Invert the panels, and settle the offsets on real hardware
    Stage 2 on the real ScreenKeys: every colour came out as its own
    complement - red as cyan, green as violet, blue as yellow. That is not
    the channel swap the doc anticipated, which would have left green alone.
    It is inversion: the library's Rcmd1 sends INVOFF, and these are IPS
    panels that want INVON.
    PANEL_INVERT carries the answer next to PANEL_INITR, overridable by -D
    the same way, and stages 2, 3, 4 and the firmware all call
    invertDisplay() with it.
    It was also hiding the other half of the stage: inverted, the black
    background is white and the white border on it is black, so there was no
    border to judge the offset against. With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
    [pins.h, test2_display.ino, test3_displays.ino, test4_buttons.ino, vorlaut.ino]
2026-08-22 Own the piper runtime, so Kerstin arrives at the device's own 16 kHz
    Issue #2. shippable() offered five voices and no German female one, and
    that was not a filtering choice: the only licence-clear candidates for the
    missing slots - de_DE-kerstin-low and en_US-john-medium - are exactly the
    two vits-web cannot speak, because it cannot phonemise her map and does not
    list him at all. Kerstin is also the one voice in the catalogue that is
    16 kHz native: every other offered voice is a 22.05 kHz model resampled
    down for the device, losing everything above 8 kHz on the way, and she
    alone arrives at its own rate untouched.
    stimmquelle has carried the door since 2.0.0 - usePiperRuntime() - and
    this w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
2026-08-22 Let the keyboard press what only the mouse could
    The symbol thumbs, the colour swatches and the "+ Set" tile were divs
    and a span with an onclick: nothing for focus to land on, nothing that
    answers Enter or Space. They are <button>s now, which brings both along.
    A button holding only an <img> says nothing to a screen reader, so the
    thumbs carry ui.pick_symbol, the same words their hover strip shows, and
    the swatches say with aria-pressed which one is the set's colour. The
    placeholder inside the thumb became a span on the way: phrasing content
    is all a button may hold, and the thumb's flex blockifies it, so it
    centres as before.
    The set tabs stay divs, because they are dragged to reorder and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
2026-08-22 Cut the root off a pick only when it is the root
    Yesterday's pickReference cut the first path segment off every METACOM
    hit, believing bildquelle ids always start with the collection root.
    They only do when the collection came in as a file list or a zip. A
    picked directory handle - the Chromium path most people are on -
    indexes paths without the root, so the first segment there is the
    rendering folder itself, and cutting it stored the bare stem: exactly
    the loss this reference exists to prevent, silently, in the most common
    setup. Both the unit test and the in-browser check fabricated
    collections through the file-list door, which is why everything looked
    green.
    The root is now compared inst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
2026-08-22 Stop stage 5 shouting, and find out what the click really is
    Two findings from the first run on real hardware, and the second one
    contradicts what this repo already believed.
    The stage drove its tone at amplitude 0.5, about 7 dB above where
    normalised speech sits. It was alarmingly loud held in the hand and said
    nothing about how the talker will sound. AMPLITUDE is 0.22 now, roughly
    the RMS of -16 LUFS speech, and at that level the volume was judged right
    for a talker a child holds - so the loudness was the test, and the
    MAX98357A's gain wants nothing done to it.
    The click is not the amplifier. bring-up.md said to fix it by lengthening
    the quiet before switching SD off; a recording of the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
    [test5_sound.ino]
2026-08-22 Give the two drags a keyboard path of their own
    Since "Let the keyboard press what only the mouse could" everything on
    the editor answers Enter - except the two operations that are drags:
    reordering sets and swapping the four speech keys. Now Alt+Arrow on a
    focused tab moves its set left or right, with focus travelling along,
    because render() rebuilds the row and would otherwise drop the keyboard
    onto the page. The grip takes the same hand-made button-ness as the
    tabs - it is dragged, so it cannot be a <button> - and Enter arms a
    swap that Enter on another key's grip completes; Escape lets go. The
    status line says what is armed, since arming moves nothing a screen
    reader would notice on its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
2026-08-22 Take stimmquelle 2.2.0, and move the one number the limiter moves
    The piper wiring stayed on 2.1.1 on purpose: 2.2.0 holds the ceiling
    with a limiter instead of giving gain away, and tts.lock.json is frozen
    evidence that must not move under a wiring change. This is the change
    it may move under.
    Exactly one number moves. Of the five utterance fixtures only burst is
    loud enough to reach the -1.5 dBTP ceiling; quiet, loud and short stay
    far below it and keep their tts_py numbers untouched, and spike carries
    none. For burst the old entry could not stay: -18.05 LUFS is what
    loudnorm's linear mode produced by giving gain away, and no run of
    tts.py - deleted anyway - could produce the limited file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
2026-08-23 Wear the family's clothes, and let a voice say what it is
    vorlaut styled the button element itself, kept its own copy of the field, the
    dialog and the folded panel, and offered voices as bare names. bildhaft and
    mitreden had already stopped doing the first three; the fourth mitreden fixed
    last, and this takes both.
    The pin goes to design v1.4.3 rather than v1.2.0, because that is where
    mitreden stands and it is the version that carries .segmented and .panel.
    components.css is imported between the tokens and ui.css, and ui.css stops
    being a second copy of the vocabulary: the bare `button` rule, button.primary,
    button.danger, input[type=text], the focus ring and the whole .panel block are
    gon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
2026-08-23 Say only what is known, and let the page follow the light
    Five things, and the first is a correction: the header shipped last time as it
    always was. The mockup that was shown moved the gear past Release, put the bar
    on --surface and set the wordmark to bildhaft's weight; the commit converted
    classes and carried none of that. It does now, and the `order` rules that used
    to pull the gear back beside the mark on a phone are gone with it - they
    existed because the markup put it second, and it is last on every width now.
    The ARASAAC notice comes from bildquelle. symbols.ts has exported
    attributionFor() the whole time, wrapping attributionsFor(), with a comment
    saying the notice "belongs anywhere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
2026-08-23 One collection at a time, and the picker says which
    A board a child reads is easier to read when its five keys are drawn in one
    hand, and two illustration styles side by side is a cost paid by the person
    least able to say so. bildhaft settled on one source for the same reason;
    this is vorlaut catching up.
    I argued against it, and the argument was wrong in a way worth writing down.
    The evidence I gave was that the board in content/ mixes - twelve METACOM keys
    and four ARASAAC ones - so mixing was something people did. It was not.
    Those four are what happens when METACOM search returns nothing and the only
    collection that answers is the other one, which is the bug fixed in the commit
    before t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
2026-08-23 Hang the keys off the mid plate, and give the case its 14 mm
    Five corrections from the first set of printed parts, and one bug that
    the checks had never been able to see.
    The carrier fouled the speaker chamber. Its cutout started at
    chamber_y + chamber_wall + 0.2 - which is 0.2 mm past the FAR side of
    that wall, a place the wall already occupies - so the plate ran through
    2 mm of solid PLA and simply would not go in. carrier_chamber_gap now
    puts the edge below the wall, and verify.py checks it.
    The ScreenKeys screw from behind. The thread is in the module, so the
    bosses on the front plate had nothing to offer; and the standoff that
    reaches the board is not the case's job either, because ea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
    [vorlaut-case.scad]
2026-08-23 Let CI say when a shared pin has gone stale
    Every shared package here is pinned to an exact release tag, so an install can
    never move what the build is made of. Nothing has ever noticed when one of those
    pins stopped being current, which is how this repository came to sit two design
    versions away from its siblings without anything going red.
    design@v1.8.0 ships pins.js for it: it reads this package.json, resolves the
    newest release of each github:Lautstark/* package it pins, and says which are
    behind. The step runs after npm ci, because it reads what npm ci installed.
    It warns and does not fail. Being a patch behind is not a reason to block a
    deploy that fixes something else, and a check t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
2026-08-23 Say which voice rushes a single word, because a talker's keys are single words
    Kerstin renders any word carrying no terminal punctuation at a near-fixed
    ~0.2 s, whatever the word is. "Nein" and "Fertig" get the same slot as "Ja"
    and arrive as mush; "Nein!" is 0.464 s and fine. Ten typical talker words
    measured: +58% duration on average, +123% at worst - Lautstark/stimmquelle#3
    holds the data. That is not an edge case here. Nearly every key on a board
    this program builds is one word, so the case the measurement calls broken is
    the ordinary one.
    The fact comes from the catalogue and is only carried through here.
    stimmquelle 2.5.0 puts rushesFragments on Voice, listVoices() already maps
    shippa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
2026-08-23 The export store.ts said was owed, and a folder that keeps it
    store.ts has carried this since it was written: "this is where the content
    lives, not where it is safe [...] an export somebody can put somewhere real
    is owed before anyone keeps a child's talker in here alone. That is not built
    yet." This is that, plus the folder that writes it unattended.
    Separate from the .obz beside it, and the separation is the point: an .obz is
    a board in the format other AAC software reads, this is the whole of what is
    in this browser in a shape only vorlaut reads.
    Two things must never make the trip into a synced folder, and they fail
    differently. The Azure key is a paid credential handed to whoever has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
2026-08-23 Drop the folder's save-now button, and name the file one for its destination
    vorlaut already had its two halves together, so only the redundant button
    goes: the folder is written on every change, so "Jetzt sichern" offered to do
    what was already happening. "Erneut versuchen" stays - after a failure there
    is nothing happening for it to be redundant with.
    "Sicherung speichern" becomes "Sicherung als Datei", which is the word all
    three products now use for the half that hands you a file.
    ui.folder_now goes with its button, in both languages.
2026-08-23 Take stimmquelle 2.5.1, so the base default is not a workaround we hold up
    2.5.1 fixes piperRuntime()'s base default, which answered / in every
    build whatever vite's base was: it bound import.meta to a local before
    reading it, and vite substitutes import.meta.env.BASE_URL textually and
    only where the expression is written out whole.
    Nothing here changes shape. local.ts has passed base explicitly since
    9dd407f - written because the package could not say it for us - and that
    line stays: it is correct, it is what a project site needs, and passing
    it is now optional rather than load-bearing. The bump is so this
    repository stops depending on a workaround for somebody else's defect
    that has since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
2026-08-23 Read the language back out of the layout, which nothing did
    boot.ts has said since it was written which half decides: the reader's own
    language "only until a layout is loaded - the language somebody picked lives
    in the layout beside the voice, and that one wins once it has been read."
    Nothing read it. setLanguage() had exactly one caller, the menu item, so the
    choice was written to the layout on every switch and read back on none. It
    lasted as long as the tab did, and the next visit opened in whatever
    navigator.languages asked for.
    The write half was never the problem, which is most of why this survived: the
    layout in the store holds the right answer the whole time, and a page that
    comes up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
2026-08-23 Say four packages where the file still said three, and check the pins by machine
    docs/packages.md was written when there were three shared packages pinned by
    hand, and every fact in it that a version number touches had gone stale.
    sicherung was missing entirely, all four pins in the example block named
    releases long since superseded, and design was described as the tokens alone
    when src/main.ts imports components.css and theme from it as well.
    The paragraph that mattered most was the one saying nothing compares a pin to
    upstream. That was the reason the file existed, and it is no longer true:
    pins.js ships in @lautstark/design, runs early in both workflows, asks each
    repository for its newe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
2026-08-23 Take the radio out, and say what that cost
    The Wi-Fi path was kept on one argument: it is a working way to get content
    onto a device while the cable is unproven. That argument expired when app.py
    was deleted and nobody noticed - the device could still find a network, and
    there was nothing on it to find. What was being kept as insurance was a radio,
    a captive portal, four stored networks and a token in NVS, all serving a path
    whose other end no longer existed.
    So it goes: discover.h, networks.h, sync.h, pairing.h and pair_format.h, the
    five digits on both sides, the setup portal, the NVS handle that held nothing
    else, and the seven one-word reasons a sync could fail. The sketch drops from
    13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
    [cable.h, cable_format.h, cablemutate.py, texts.h]
2026-08-23 Write the build where something other than this page can reach it
    The cable is the only way onto a talker, and it has never met one. That was
    survivable while it was one path of two; since the radio went it means a wrong
    guess about hardware leaves a device with no way to receive content at all -
    not for want of a radio, but because nothing wrote the files anywhere a second
    program could pick them up. build.py wrote firmware/vorlaut/data/, the browser
    build writes IndexedDB, and the backup export leaves build output out on
    purpose, so mklittlefs had nothing to image and the bench's folder picker had
    nothing to pick.
    So: Device -> Write the build into a folder, in the settings. It writes exa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
2026-08-23 Take the panel's table from the package, and the menu's mark from design
    design v1.10.0, sicherung v1.1.0.
    The six-branch switch deciding which buttons belong to which backup
    state is gone. It was the same switch in all three products — one
    behavioural contract with three copies and nothing asserting they
    agreed, which is the arrangement where one of them quietly stops
    offering a way out of `failed`. actionsFor() is that table, once. The
    ids it returns are this page's i18n keys after "ui.folder_", so what is
    left here is a lookup rather than a mapping that could disagree.
    The menuitemradio rule this stylesheet has been carrying since this
    afternoon is deleted; it is components.css's now.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
2026-08-23 Ship the program, and let the device make its own file system
    The release workflow has been broken since 2026-08-22: it ran
    `pip install -r requirements.txt` and `build.py --require-audio` to merge the
    four example sentences into the image, and both went with the Python. No tag
    has been pushed since, so nothing has gone red. The decision was between a
    program-only release and finding another way to build content in CI, and it is
    program-only: the build runs in a browser now, and a workflow cannot press a
    button in one.
    That costs the first flash its four spoken keys, which were worth having - a
    device that speaks straight out of the box checks the displays, the partition
    scheme, the file sy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
    [vorlaut.ino]
2026-08-23 Ask for the port where no build is waiting behind the dialog
    Pressing "Aufs Gerät übertragen" with no device granted opened the port picker,
    and dismissing it ran the whole build anyway to end at "gebaut, aber nichts
    übertragen". Somebody who closes a dialog has said no, and it should cost
    nothing - certainly not minutes of speech synthesis.
    The picker had to be there, given where it was. requestPort() needs transient
    activation and Chrome expires it in about five seconds, while a build with
    speech in it takes longer, so a picker on that button could only come before
    the build. The mistake was the button, not the ordering: docs/cable.md had
    already concluded "one explicit connect, the fi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
2026-08-23 Compile the sketches that are there, and check the list says so
    The firmware workflow names its sketches one per line, and still named
    test6_wlan and test7_sync - which went with the radio. So every push since has
    gone red on "Can't open sketch", a minute into installing the ESP32 core, for a
    reason that has nothing to do with the firmware. Checking the workflows for the
    library and the Python found the WiFiManager line and missed this one.
    The list is checked here now, both ways round. A sketch it names that is not
    there was today's failure. A sketch that is there and appears in no list is the
    one worth having: compiling the bring-up sketches is how a broken pins.h is
    caught before somebod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
2026-08-23 Ask for the port on the press again, and let a dismissal mean nothing
    Two commits ago the press opened the picker and, if it was dismissed, built
    anyway and reported that nothing was sent - so closing a dialog cost minutes of
    synthesis. The last commit fixed that by moving the picker out of the press
    entirely, and that was the wrong half to remove: the picker is what somebody
    pressed the button for. Pressing it then did a build nobody asked for either,
    and said to go and look in the settings.
    So the dialog is back on the press, where it was, and the dismissal is what
    changed: it ends there. No build, no log, nothing on screen touched. The
    ordering it forces is unavoidable - requestPort() ne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
2026-08-23 Let stages 2 and 3 chase a wire instead of holding a picture
    Stage 3 drew once in setup() and then sat in delay(1000). A panel keeps
    its picture in its own memory, so that is not a still image being
    maintained - it is nothing being sent at all. Move a CS line and the
    displays go on showing what they were given at boot, which makes the one
    thing this stage is for, finding a wire, into reset-look-reset-look. On
    real hardware that cost two wire swaps that looked like no change at all
    and sent the search off in the wrong direction.
    It re-inits and redraws all five every three seconds now, so a panel that
    was just reconnected joins in by itself. The shared RST pulses with it,
    so all five blink o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
    [test2_display.ino, test3_displays.ino]
2026-08-23 Say which way a search failed instead of finding nothing
    searchActive() caught everything and returned [], so the arm in doSearch()
    written to report a failure had been dead since it was written, and a page
    that never managed to ask was told the collection held nothing.
    Removing the catch is only half of it. A provider's search() must not throw -
    bildquelle's contract - so ARASAAC swallows its own fetch failures and reports
    them through status(). An empty list is therefore what a browser with no
    network gets, and status() is the only place the difference survives; the
    picker asks it before wording an empty answer.
    The German tables are a lazy chunk, and a failure to fetch one is not worth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
2026-08-23 Follow the folder when it arrives, not only when the page loads
    Reading the chosen collection once at boot was right about the moment it
    ran and wrong from then on. On Chromium a stored folder handle usually
    comes back needing its permission re-confirmed, so at load there honestly
    is no collection, readSettings() answers "arasaac", and METACOM appears a
    click later - with nothing reconsidering the choice at that point. The
    picker re-derives it whenever the provider's readiness changes.
    Two more in the same flow. paintSources() only ran from paintStates(), so
    a folder connecting while the sheet was open left the one control that
    chooses METACOM hidden on the panel that had just become choosa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
2026-08-23 Give the cable room to be ahead of the flash
    Stage 6 on the first real hardware failed on the first file every time,
    with "short", which reads as the browser having stopped talking. It had
    not: the console showed all seven chunks of a 26912 byte file written and
    resolved inside a second. The bytes were leaving and not arriving.
    Serial.begin() was called without setRxBufferSize(), so the buffer was
    the default 256 bytes. USB fills an empty one at about 490 KB/s and the
    receive loop is inside file.write() for up to 60 ms at a stretch, reading
    nothing; what lands in that window is discarded by the interrupt, and CDC
    has no way to say so. Silent at both ends - the browser reports success
    on eve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
    [cable.h, cable_format.h, vorlaut.ino]
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2026-08-23 Stop making her wait through a quarter second of silence
    The silence after a word, before the amplifier is switched off, was eight
    chunks - 256 ms at AUDIO_CHUNK and 16 kHz, and the fattest part of the
    ~740 ms every press cost. Three chunks is 96 ms, and no click came back
    on the hardware that had one to lose.
    It matters for more than the wait. A press that lands inside a word is
    held in one slot and the next one overwrites it, so the shorter a word
    occupies the device, the less often two collide. Ten presses gave six
    words before any of this, eight once a press could be remembered, and
    ten now - with only two needing the slot at all, where the same test
    needed six a moment ago. The gap did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
    [vorlaut.ino]
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2026-08-24 Write down why waking her device takes three presses
    Watched on a real morning, and only one of the three is the backlight
    bug the commit before this one fixes. One press wakes. One is made
    during the boot that follows and is thrown away by clearButtonStates(),
    because the rule that protects the waking press does not know the boot
    has not finished - and from the outside that press just does nothing.
    One finally speaks.
    No fix here, because the choice between the two depends on a number
    nobody has yet: shorten the boot until nobody presses into it, or
    remember a press made during it the way one made during a word now is.
    "ready N ms after waking" exists to produce that number.
    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
    [vorlaut.ino]
2026-08-24 Wake in half a second instead of four and a half
    Waking took 4299 ms, and 3800 of it was five panels being initialised one
    after another. The ST7735 sequence carries mandatory waits - 150 ms for
    the software reset, 500 for sleep-out, 10 and 100 for the display coming
    on - and the library pays them per panel, because it only ever knows
    about one. Behind an unlit screen, for four and a half seconds. That is
    what made a press into it look like a device that had not heard, which is
    what was watched happening on a real morning.
    Nothing in those waits is about the bus. They are the panel settling, and
    five panels settle at the same time as one.
    So the panels are not re-initialised at all. goToSl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
    [pins.h, test3_displays.ino, test4_buttons.ino, vorlaut.ino]
2026-08-24 Close the stage 5 click, since stage 7 has answered it
    The note said the amplifier question could not be judged until stage 7
    ran. It has run, on real hardware with real content, and the answer is
    that nothing needs doing: the amplifier is switched off across exactly
    the gaps where the bus starves, so the underrun is real and inaudible.
    Kept as a coupling rather than a fix, because it is expensive to
    rediscover. Holding the amplifier on would cure the pop, the quiet word
    start and a clipped fragment being mostly ramp - and it was tried on
    2026-08-24 and hissed. That hiss was this click, amplified for the first
    time. The amplifier may not be held on until I2S is fed continuously,
    and that is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
2026-08-24 Specify the board package the Android viewer imports
    An .obz profile of Open Board Format for builder-to-app transfer, with the
    fixtures a Kotlin importer is checked against. Nothing implements it yet.
    The talker is deliberately out of scope: it keeps its own board model, its own
    layout.bin and its own transfer path, and nothing here describes it. That is
    also why ext_lautstark_* and ext_vorlaut_* stay separate rather than being
    unified - half the talker's fields are meaningless off that device, and
    obf.lock.json can no longer be regenerated against anything but itself.
    adr/0001 records it, because the duplication looks like an oversight and will
    invite a cleanup.
    METACOM may be baked into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
2026-08-24 Write down stages 3 and 4, and what they failed to ask
    Both passed on 2026-08-23 and neither left a note, while stages 2, 5, 6
    and 7 all did. What they cost is in here now, because it was not the
    faults that were expensive.
    Stage 3 lied twice about display 4. It drew once in setup() and then sat
    in delay(1000), and a panel keeps its picture in its own memory - so two
    correct wire swaps in a row looked like nothing had changed and sent the
    search after the Feather, which was innocent. The swap that did settle it
    moved which pin drove which panel and the darkness stayed with the panel.
    It redraws every three seconds now, and the note says to check that
    something redraws before touching a wire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
    [vorlaut.ino]
2026-08-24 Fail loudly when node_modules is not what package.json pins
    A stale install did not announce itself. The four shared packages are git
    dependencies, nothing compared the installed copy with the pin, and the way it
    surfaced was as a test failing somewhere else entirely - a loudness assertion
    with real numbers and a sound story about limiters, in a recording chain that
    was correct, because the installed stimmquelle was older than the pinned one.
    A wrong answer that plausible costs more than an error, because it gets
    investigated as a bug.
    tools/installcheck.mjs compares four things already on disk - the tag in
    package.json, the version and commit in package-lock.json, the commit in
    node_module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
2026-08-24 Write down the three rules that keep parallel agents from colliding
    On 2026-08-24 three agents independently committed the same repository rename.
    None of them was wrong: the repository had been renamed, every one of them
    noticed, and each fixed it correctly. They were simply all allowed to.
    Naming, because the worktree names and branch names had drifted apart and then
    crossed - a worktree called lautstark-infrastructure held the rename branch,
    and the multi-board work sat in one called busy-yalow. Sorting out who had done
    what meant reading commit messages and guessing.
    Ownership, because one of the four agents could not be attributed at all. The
    description goes in at spawn time rather t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
2026-08-24 ci: gate conventional commits in CI, and widen the tests path filter
    Two changes with one cause: a check that only runs sometimes is not a check.
    The commit convention was enforced by .githooks/commit-msg alone, which is
    opt-in per clone. The failure it guards is silent - release-please reads the
    prefix and nothing else, so a commit without one lands with no changelog
    entry, no version bump and no complaint. A silent failure guarded by an
    opt-in check is not guarded, and it is the same silent-omission failure that
    deciding by path rather than by scope was meant to prevent.
    So .github/workflows/commit-messages.yml is now the gate. It checks every
    non-merge commit in a push, on main and on c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
2026-08-24 fix(exchange): make every fixture expectation agree with its package
    Board `essen` in multipage carried three columns and a Café button; its
    expectation described two columns and never mentioned the button. Found by the
    Android parser implementation, which is the wrong place to find it.
    The defect was cheap; the reason it survived was not. fixture() takes members
    and expected as two sibling literals, so nothing derives one from the other,
    and byte-reproducibility cannot help - both halves regenerate from the same
    source, so a wrong pair regenerates consistently wrong and
    tests/test_exchange_fixtures.py stays green on it. The README claimed an
    invariant that no code enforced.
    So the genera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
2026-08-24 docs(exchange): let index.json be the only place that counts the fixtures
    The count had drifted twice - the README said eleven when there were twelve,
    and adr/0005 said twelve within a day of being written. Correcting it a third
    time would only reset the clock, so it is gone instead.
    adr/0005 no longer states how many fixtures there are. An ADR records why a
    decision was made, not what the tree currently holds; the argument for fixtures
    over prose does not depend on how many of them there are, and reading a number
    there tells you only when the file was last touched.
    SPEC 13 and the README now point at fixtures/index.json and say plainly that no
    count appears in prose, so the next person is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
2026-08-24 refactor: take the confirm dialog from design, and guard the hang
    @lautstark/design/dialog carries the modal sheet now. Both halves of this
    page's copy go: shell/confirm.ts and the static markup in
    shell/templates/confirm.ts, since the shared one builds its own and removes it
    when it closes.
    The words stay here, which is the point of the shared one taking them: every
    label is a t() call at the call site, and the corner cross is deliberately not
    given the same word as the button beside it.
    **e2e/boards.spec.ts gains the test that was missing when this broke.** The
    confirm used to resolve from the dialog's close event alone, which hangs
    forever on a host that closes without firing it - the c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
2026-08-24 feat: Sammlungen, and the work head that belongs to one
    conventions.md applied to this page, and the word settled with it. What the
    sidebar lists is a Sammlung - the same thing mitreden and bildhaft call one -
    and *board* goes back to meaning a single OBF page, which is what
    exchange/SPEC.md has always used it for. `Collection` in the code and Sammlung
    on screen is design.md §3.6's split, so nothing German entered the source.
    **The work head** (§3.3). The name, the count, "Aufs Gerät übertragen" and the
    ⋯ are one row above the editor now. The transfer button was in the page header,
    where the thing it acts on had to be inferred - which is exactly the inference
    that goes wrong on a page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
2026-08-24 fix: follow the siblings' layout instead of a third answer
    Six things, and the layout ones came from the same mistake: the last pass
    applied conventions.md and invented everything the document does not cover.
    Opening mitreden and bildhaft side by side answers most of it.
    **There is no page header.** bildhaft's .topbar is display:none until the mobile
    breakpoint and mitreden's is the same; on a desktop the mark sits at the top of
    the sidebar, beside the control that puts the sidebar away, and nothing spans
    the window. This page had a bar carrying a mark, a toggle and a gear - three
    things with homes elsewhere, costing vertical room on every screen. It is gone,
    the mark is the sidebar's brand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
2026-08-24 fix: put the work head on the page's own ground
    It had --surface behind it and a rule under it, which made it a bar. A bar is
    furniture; this is not. It is the name of the thing you are looking at with the
    two acts that apply to it, and the width across the content column is already
    what gives it the top of the page - it does not need a box drawn round it too.
2026-08-24 fix: size the board for the height it costs, not the width it can have
    The thumbs are square, so the board's width is its height: three columns
    across, two rows down, and width taken here is paid for below the fold. 720px
    ended exactly at the fold on a 900px window and overflowed a 13-inch laptop,
    which is the machine this is used on.
    640 fits it - and it is where the column sat before it was ever widened. The
    rule the number stands for: as wide as the shortest laptop can show in one
    screen. Wider buys a bigger picture of a symbol somebody can already see, and
    charges for it in the two keys that drop off the bottom.
2026-08-24 fix: say "Zugriff bestätigen" in the heading and put the reason in the panel
    The Symbole panel's summary carried a whole instruction - "Ordner ist gemerkt,
    Zugriff mit einem Klick auf ... erneut bestätigen" - as its state line. A
    summary is one line, so it truncated mid-clause, and design.md §2 is explicit
    that a heading carries what a section IS set to rather than what to do about
    it. It says "Zugriff bestätigen" now, which is a state and fits.
    The sentence moved into the body, beside the button it names, and it is drawn
    as a warning rather than as another grey note. That is the second half of what
    was wrong: this is the one state in the panel that is a thing to do rather than
    a thing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
2026-08-24 feat: move the transfer flow into a dialog
    The log used to render under the work head, and the press went straight into
    a build with no chance to look at anything first. Two things were wrong with
    that: nobody was told what was about to be written before it was, and a page
    that grows a scrolling log under its work head is reporting a modal job in a
    place that is not modal.
    The press opens a @lautstark/design sheet instead, and everything happens in
    it without it closing between the steps: what is about to go - the Sammlung,
    how many of its sets are on, how many keys carry something, which port it is
    going to - then the transfer with the log, then how it ended. It stays open
    after that, beca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
2026-08-24 fix: say so when another tab is holding the database open
    indexedDB.open() at a higher version does not fail while an older connection
    is still held somewhere - it fires `blocked` and waits, with no timeout and
    no error. store.ts passed only `upgrade` to openDB(), so that wait was a
    promise which never settled, and every read and write in the tab waited on it
    for as long as the tab lived.
    That is what a browser saw when DB_VERSION went to 3 with a tab from before
    the change still open on version 2: an empty sidebar, no seed board made, the
    labels left in whatever language the browser had guessed because load() never
    reached the one in the layout, and the buttons that would have fixed it all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
2026-08-24 fix: follow the board's language in the symbol dialog's credit line
    The line under the symbol search is written by showSources() and by nothing
    else, so applyTexts() never reached it. chooseLanguage() has always called
    both; adoptLanguage() called only applyTexts(), and that is the path a page
    takes on load - so a board whose language differed from the browser's came up
    with one English sentence under a German heading.
    Visible only where the two disagree, which is why it sat there: on a German
    browser reading a German board there is nothing to see.
2026-08-24 fix: make a new board in the language the page is in
    blank() wrote language: "de" into every board it made. A board carries its
    language and load() adopts it, so a first visit rendered in the reader's own
    language for a moment and then turned German around them - on a browser that
    had asked for English, in a product whose whole audience is people who need
    the words to be theirs.
    boot.ts guesses from navigator.languages and says the board wins once it has
    been read. This is what makes the guess worth making: LANG is a live binding,
    read where the board is made, so a board made after a language switch is made
    in the language on screen.
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2026-08-24 fix: say which language a package is in, from the voice that speaks it
    exchange/SPEC.md §7.1 makes a board's `locale` the fallback that picks a voice
    when `ext_lautstark_tts_voice` is unavailable - and on Android it is nearly
    always unavailable, because the names vorlaut stores are piper models and Azure
    voices no tablet has. So `locale`, not the hint, is what decides how a package
    actually sounds.
    It was taken from `layout.language`, which is the language of *this page* and of
    the four menu labels the firmware draws, and which follows whatever the browser
    asked for. A German board built in an English browser therefore went out saying
    `locale: "en"`, and the tablet reads "Ich habe Hunger"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
2026-08-24 test: hold the rule that a stopped backup says how long it has been stopped
    The standing-backup panel is nearly all shared now: @lautstark/sicherung/ui owns
    which buttons a state offers, which states are somebody's to act on, and the
    arithmetic behind "vor 3 Minuten". What it deliberately does not own is words,
    because bildhaft has no t() to route them through - so the sentences stayed in
    all three products, and this rule with them, written out three times with
    nothing checking the three agree.
    The rule: `needs-permission` and `failed` both carry the age of the last real
    copy. Both mean no backup is being written and it will not resume by itself, and
    both are easy to put off - "es funktioni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
2026-08-24 fix: keep the shell the height of the window, so Einstellungen stays on screen
    The frame's height was a floor - `min-height: 100vh` - so a board taller than
    the window grew the page. The sidebar is a grid item stretched to that row, so
    it grew with it and carried its foot below the fold: „Einstellungen", the one
    entrance to the settings (design.md §3.4), was reachable only by scrolling a
    column with nothing in the middle of it to scroll to. Every window a five-key
    board does not fit in was affected, which is every 13-inch laptop.
    The board is what is too tall; the shell is not. So the frame is the window's
    height and `main` is the one thing that scrolls - the sidebar, its foot and the
    na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
2026-08-24 feat: a second editor, for the tablet boards the app renders
    editor-app sits beside editor-diy behind the same port: pages of a grid
    composing a sentence in a bar, which is what exchange/SPEC.md has always
    described and what vorlaut-app already renders. A Sammlung says which it
    is for when it is made, and never converts.
    The page graph is the part that was expensive to get wrong, so it is in
    pages.ts as plain functions over data. Deleting a page keeps every button
    that led to it - its label, its symbol, its colour, its cell - and takes
    only the edge. The three rejected answers are written down there, and the
    delete question counts what points at the page from elsewhere, because
    that is the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
2026-08-24 test: put a picture on the tablet board the sample is cut from
    The round trip is about two programs meeting, and an archive with no
    images in it never asks the viewer to resolve one.
2026-08-24 fix: give the tablet board the width eleven columns need
    main is capped at 640px because three cards across read better centred.
    Eleven cells across at that width are 45px each, and every label becomes
    an ellipsis - which takes away the thing a grid is for, knowing where a
    word is without reading it. The cap moves for this editor and only for
    it.
2026-08-25 fix: say "umstellen" where "die Seite" meant the other kind of side
    The note under the target choice read "eine Sammlung wechselt später
    nicht die Seite" - Seite as in side, three lines under a dialog whose
    other choice is about pages. The word is about to mean one thing on
    screen, so it cannot mean two here.
2026-08-25 fix: ask before deleting a set the way every other question here does
    conventions.md §3.4 forbids window.confirm outright - the browser's own
    chrome is the one surface no design token reaches - and names mitreden as
    the only product still using it. vorlaut had one left, on the set delete,
    and the divergence list recorded vorlaut as compliant.
    It failed §1.7 twice as well. The question named the set and counted
    nothing inside it, so it asked somebody to decide without the one fact
    that could change their mind; and the confirming button said OK, which
    asks the reader to hold what it refers to in their head.
    What it counts is the keys with something on them, not the four slots,
    which are al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
2026-08-25 test: a camera for the two editors, not a test
    Four states of each, same window, same content, written to disk so the
    two can be looked at side by side rather than described in a table. It
    asserts almost nothing on purpose - what it makes is for a person to
    judge, and an assertion here would only be the file agreeing with itself.
    Skipped unless SHOTS names a directory, so the suite does not spend
    twenty seconds writing images nobody asked for.
2026-08-25 fix: say DIY-Talker where a tablet is also a talker
    "Talker" is what this product calls the device everywhere, and everywhere
    else it is unambiguous because there was only one thing. On the target
    choice it is not: a tablet running a board is a talker too, in the same
    UK vocabulary, and this is the one screen where the two stand next to
    each other.
    Both notes under it described mechanism - how many keys go in a set, what
    the set key does - which is true and answers a question nobody has yet.
    What decides between the two is what one press gives you: a whole thing
    to say, or a word that joins a sentence. Both now say that, in the same
    shape, so the pair reads as one choice rather than two blu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
2026-08-25 feat: move a tablet button to another cell, by drag or by keyboard
    The five-key editor has had this since it was written; the tablet had
    none, so a button in the wrong place had to be deleted and rebuilt,
    losing its symbol, its word class and its recording.
    Dropping onto an empty cell moves, onto a full one swaps. Swap rather
    than push: pushing would move a third button nobody touched, and refusing
    would make a full board impossible to rearrange. It is also what the
    talker already does, where a fixed 2x2 made swapping the only
    unambiguous answer.
    The keyboard gesture is Alt and an arrow, which is what this product
    already uses to reorder the talker's sets. editor-diy's other gesture -
    arm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
2026-08-25 feat: name a picture-only button rather than call it empty
    A tablet button may carry a picture and no word - ordinary AAC, and
    exchange/SPEC.md 7.2 allows it. "leer" was the right name for a button
    nobody had filled in yet and is the wrong one for a button that is
    finished, so there is a word for the finished case.
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2026-08-25 feat: a word takes the picture's room, and clamps to two lines
    A text-only button is set more than twice the size, which is the ratio
    AsTeRICS Grid's TextConfig uses to make one read as deliberate rather
    than as a cell missing something.
    A label that does not fit clamps to two lines and then ellipses, rather
    than shrinking to unreadable type or truncating with no sign anything is
    missing. The picture is the part that gives way, so the two lines are
    always there; and the cell keeps its ratio, so one long word cannot push
    its whole row taller and leave the rest of that row short.
    Sized by how wide the cell came out rather than by a density class,
    because this board has none - it is sized by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
2026-08-25 refactor(picker): expose search, take and upload as a seam
    The tablet editor's button sheet carries the picture, its search and the
    upload in its own left column, so it needs what the picker dialog knows
    without opening that dialog on top of itself - a modal over a modal to
    choose a symbol is the second dialog the sheet design set out to remove.
    What it must not do is carry a second copy of the reasoning: which source
    is active, what an empty answer means, and the fact that an ARASAAC pick
    is a download while a METACOM one is a reference. All three stay here and
    the dialog now goes through the same three functions, so the two callers
    cannot drift.
    findSymbols() packages the part that is ea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
2026-08-25 test(editor-app): drive the sheets, and cover what a dismissal costs
    put() goes through the sheet a press opens, which keeps the point of driving
    the page rather than writing a layout into the store: the controls it fills
    are where the format's exclusivity lives, and the upload now happens inside
    the button's own sheet.
    Three new tests for the three things the redesign actually changed. That a
    sheet somebody closes writes nothing, on an empty cell and on a full one -
    the rule the whole draft model exists for, checked across a reload so it is
    the store being asserted and not the screen. That the four kinds are a
    relabelling and still carry the acts they always did. And that the page sheet
    of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
2026-08-25 docs: record what the two frozen references stopped answering for
    layout.lock.json and obf.lock.json both recorded the active flag, and
    removing it made one case and 151 field answers unreachable rather than
    wrong. Both are the case each lock's own invalidated_by anticipates, and
    neither is recoverable - the oracles went with the Python half.
    Also drops the stale mention of activeSets() as one of the two things
    layout_format.ts had.
2026-08-25 feat(editor-app): move the grid size off the editing bar, beside a colour choice
    The size sat in #appRows/#appCols next to the page tabs, where everything else
    belongs to the page. It belongs to the Sammlung: every page shares it, and that
    sharing is the whole reason a button keeps its place from one page to the next.
    A number field there also invited a typo that costs buttons.
    Two homes replace it. At creation, askTarget() asks the size as pictures rather
    than as a pair of numbers - miniature grids with their button counts, because
    what somebody is choosing is how much fits on a page. Afterwards, a card from
    the menu beside the Sammlung's name holds the size and the word-class colour,
    whic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
2026-08-25 fix(editor-app): retire the selection mark the panel left behind
    A cell drew an accent border and claimed aria-pressed="true" when its id
    matched `chosen`. That meant something while the property panel existed:
    one button was selected, the panel below showed it, and the border said
    which one the panel was about.
    The panel is a sheet now, and a sheet closes over the board. Nothing shows
    a selected button any more, so the border was announcing a selection that
    nothing could act on - it simply stayed on whichever cell was edited last.
    It survived the redesign because it was drawn from state that nothing read.
    With the drawing gone `chosen` was written in eight places and read in
    none, so it g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
2026-08-25 test(exchange): put a live talker field on the unknown-ext board
    The fixture carried ext_vorlaut_active on its board as the talker's
    board-level extension. That field went on 2026-08-25 with the
    active/inactive distinction, so the fixture was pinning an importer
    against a field no builder writes.
    Replaced with ext_vorlaut_color, which is what the talker's export
    actually puts on a board, and which makes the sharper trap: the board now
    carries ext_vorlaut_color and ext_lautstark_board_color at once, holding
    different colours. The expected board colour is the lautstark one, so an
    importer reading the wrong namespace produces #FF6B35 and fails, rather
    than passing because both fields happened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
2026-08-25 docs: follow the removed active field into ADR 0001
    The Context said the talker export writes four fields and named
    ext_vorlaut_active among them; it writes three. The Consequences bullet
    described the unknown-ext fixture as carrying the flag on a board, which
    it no longer does.
    The Why section counted the field too - "half of ext_vorlaut_* is about a
    device with four keys and a battery" was two fields in four and is one in
    three now. Left standing with the change noted rather than quietly
    restated: the claim was weakened by the removal, and papering over that
    is the kind of thing an ADR exists to stop.
    The status line keeps SPEC.md 1.0.0. Every ADR here names the version it
    was written ag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
2026-08-25 feat(app-package): write the shared first column onto every board
    exchange/SPEC.md §4.1 is explicit that persistence needs no field: a
    builder repeats those buttons on every board, and the viewer then opens
    an ordinary board that happens to start the same way. This is that
    builder. Reading the gap hint as an instruction to carry column one over
    would render one package right by accident and the next one wrong.
    The column goes first in each board's walk, so it owns column zero - a
    page button that somehow sits there is dropped by the rule that already
    refuses a second button in one cell. Ids stay per board, because
    appButtonId() is built from the board id: one authored button becomes
    board-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
2026-08-25 fix(ui): scope the settings sheet padding override to the settings sheet
    `dialog.sheet` took the shared 22px off every sheet in the page, and
    openDialog() puts `className: sheet` on the <dialog> element itself - so
    the rule reached all nine dialogs the shared helper builds, not the one
    it was written for. Their bodies had nothing to put back and came out
    flush against both edges, which is what somebody reported after looking
    at the button sheet. The width in the same rule was the same bug one
    property along: `.sheet--button` was prying itself back out of a 520px it
    never asked for.
    The two sheets that really do want it off are in the markup - the
    settings sheet, whose body is edge-to-edge f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
2026-08-25 fix(editor-app): the page card is the narrow sheet again
    openSheet puts sheet--button and sheet--page on the same dialog, so the
    520px had to out-specify dialog.sheet--button's 720px and did not. The
    card drew as a single column of fields adrift in the wide sheet.
2026-08-25 fix(shell): make the narrow sidebar a drawer over the work, like both siblings
    conventions.md 3.1 says the sidebar becomes a layer over the work with a scrim
    below roughly 820px. mitreden and bildhaft both do exactly that, at exactly that
    width. This page had a third answer: below 620px the column became a row across
    the top, with the Sammlungen scrolling sideways under it.
    The row was not an accident and the reasoning for it was half right - hiding the
    list outright would strand somebody on whichever board they opened on, which is
    true, and is not an argument for a row. A drawer answers it too, and answers it
    the way the other two already do. What the row cost was the top of every phone
    sc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
2026-08-25 fix(shell): tell the page's language apart from the Sammlung's
    One control set both: setLanguage(code) and state.layout.language = code on
    the same keystroke, with adoptLanguage() reading the layout's back on every
    arrival. So a carer whose editor is German could not give a child an English
    talker without turning their own editor English, and opening a Sammlung
    silently re-languaged the page around them. ui.language_title was the apology
    for it - "Sprache dieser Seite und des Menues auf dem Geraet".
    They are two settings now. The page's is the panel it always was, kept in this
    browser. The Sammlung's is a panel of its own beside the Sammlung and the
    Device panel, written to the layout, and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
2026-08-25 test(e2e): hold the two languages apart, from both sides
    language.spec.ts asserted the bug: that the layout carries the page's language
    and that localStorage does not. It now checks the page's choice survives a
    reload without the layout moving, that the Sammlung's lands in the layout
    without the page moving, and that opening a Sammlung leaves the editor alone.
    Both halves fail when the old lines are put back.
    The one in build.spec.ts was reading its labels out of BOARD.language, which
    was right only while opening a board re-languaged the page; the locale is
    pinned instead. sources.spec.ts asserted the same adoption on import.
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2026-08-25 style(board): put air between a symbol and its word
    Both editors. At 4px the picture and the label touched at the ascenders and
    read as one block - a symbol with a caption stuck to it rather than a symbol
    and the word it stands for, which is the pairing the board is there to teach.
    The picture is what gives up the height and it can afford to: it is capped at
    60% of the cell. 8px holds at eleven columns as well, so there is no second
    number - and the note left in the container query says why one could not have
    gone there in any case.
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2026-08-25 fix(tabs): make the page's ... a target, and hold the strip still
    It stays a control of its own rather than moving onto the tab. The tab is
    already a 100px target and a second press on the one you are standing on does
    nothing, so that press was free to take - but a modal that opens on the second
    click of the page you are already on is a modal that opens by accident, and
    the gesture has nothing on screen to announce it. Dropping the ... the other
    way loses the only labelled, keyboard-reachable way to a page's own card.
    What was wrong was the drawing: a glyph with 2px of padding round it, which is
    a 16x11 target for the thing the work head gives a 40px button to. It is a
    26px box now, past th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
2026-08-25 fix(sheet): stop the sheet body clipping the focus ring
    Reported on the talker's set sheet: the search field's ring is cut off on
    its left edge. The clipper is `.sheet > .body`, and not for the reason it
    looked like - the results strip's `overflow-y: auto` was the obvious
    suspect and the field is not inside it.
    The body is the sheet's one scrolling area. A box that scrolls in one
    axis clips in the other, so the body's padding box is the clip edge for
    everything in both columns, and the body has no padding of its own: the
    22px is the dialog's, outside the scroller. The pick column therefore
    starts exactly on the clip edge, and components.css's 2px ring at 2px
    offset paints four pixels outsid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
2026-08-25 style(app): shorten the whole-Sammlung export to one word
    "Als Paket exportieren" / "Export as a package" in the work head's slot, where
    what it acts on is the Sammlung named two controls to its left and the only
    export a tablet Sammlung has. The format is the sheet's first sentence. So:
    "Exportieren" and "Export".
2026-08-25 style(sheet): drop the ellipsis from "Eigenes Bild"
    The trailing ellipsis is not wrong on its own terms - it conventionally
    means a further dialog follows, and this button does open a file picker.
    It goes because it is the only one.
    Every button label in core/boot_data.ts, checked: "Ordner wählen" opens
    the browser's folder picker, "Sammlung importieren" a file picker, "Als
    OBF-Datei exportieren" a save dialog, and none of the three carries one.
    The only other ellipses in the table are on progress lines - "baut ...",
    "sucht ...", "lädt Bild hoch ..." - which are a different mark doing a
    different job. So the majority is unanimous and this was the exception.
2026-08-25 feat(sheet): a way to take the picture off a button
    Until now a picture could only be replaced. Every way out of the sheet
    either kept the symbol or put a different one in its place, so a button
    given the wrong picture was stuck with a picture.
    Nothing downstream had to learn anything: `symbol: ""` is what a button
    without a picture has always been in the model, and a picture-less button
    already draws its word large.
    Not a ✕ beside the search field, which is where it first wants to go. That
    field is an <input type="search"> and the browser draws its own ✕ inside
    it, which clears the word being searched for - two ✕ a few pixels apart
    meaning two different things is worse than the miss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
2026-08-25 style(sheet): a square preview, in a column wide enough for one
    Two changes and one decision, which is why they are one commit.
    The device's display is square: IMG_SIZE 128 with TILE_SIZE 116 in
    data/tiles.ts, and a tile is what a key actually shows. A 4:3 preview was
    the one place in the product that said a picture is wider than it is
    tall, and it lied about the thing it was previewing.
    design's docs/mocks/editor.css carries the reasoning being overruled, and
    it is a real cost honestly stated: a square preview at column width takes
    a third of the sheet to show what the cell behind the sheet is already
    showing. Overruled anyway - a preview that is the wrong shape is worth
    less than the roo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
2026-08-25 docs(css): the cells stopped being 4:3, the comment did not
    d17dff7 made the five-key board's cells square, which is the right shape
    for the display and 98px taller per board at the same cap. The paragraph
    over main's 640px still reasoned from 4:3, so it argued for a budget
    looser than the one the page actually has.
    Also says what the cap is not: a bill everything in the column pays. A
    row of tabs costs one line of height at any width.
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2026-08-25 feat(symbols): a METACOM folder becomes the source when it is added
    Two steps for one intention: metacomChoose and metacomFiles installed the
    folder, and "Diese Quelle verwenden" a panel further down switched to it.
    Nobody goes and finds their licensed METACOM collection in order to carry on
    rendering ARASAAC. bildhaft settled this the same way.
    metacomReady() and not merely "nothing was thrown", which is bildhaft's reason
    as well: a pick that produced no usable index would switch the whole app onto
    an empty source, blanking every search result in a way that reads as the
    collection having gone missing rather than as the pick not having worked.
    Adopting is asked for at two call sites and is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
2026-08-25 fix(css): let the tab strip out of the board's height budget
    Five sets with ordinary names measure about 685px in a row; the strip
    gets 600, so it wraps and the second line pushes the board down.
    main's 640px cap is a height budget for the board - the board's width is
    its height - and the strip was only paying it because it happens to live
    in the same column. So the cap moves onto the board itself, at the 600px
    that 640 minus the padding always drew, and main gets a wider cap for
    this editor alone. Only chrome uses the difference.
    Selector shape is the tablet's, one rule up: chosen by what is in the
    page rather than by a class the shell would have to set.
    The board keeps the column's lead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
2026-08-25 fix(shell): ask about a restore in a dialog, and say how much it replaces
    conventions.md 3.4 and 1.7. This was the last window.confirm() in the family,
    and it was on the most destructive path in the product.
    Restoring a Sicherung replaces every Sammlung in this browser rather than
    merging into them - 1.10 allows that, because a whole-library restore is a
    different act from an import. What it did not do was ask properly. The question
    was a native confirm() saying "Die Sicherung ersetzt alle Boards, die hier
    liegen. Fortfahren?": drawn in the browser's own chrome, which no token reaches
    and which is the one surface in the product that cannot follow the scheme.
    It also named nothing. A person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
2026-08-25 fix(css): let the create dialog's target question actually hide
    .sizeask carries display: grid, which is an author rule and beats the user
    agent's [hidden] - so sizes.hidden = true had never hidden anything, and the
    grid question sat under the talker choice offering to size a board that has
    no grid.
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2026-08-25 docs(cable): fix the prose the Device panel left stale, and name what it cost
    Six places still sent the reader to a settings panel that is gone, and two of
    them were load-bearing rather than incidental:
    * device.ts's header carried the *argument* for the whole design - a picker
    with no build waiting behind it - and pinned it to the settings sheet.
    Rewritten so the rule survives its move: the button is the one inside the
    transfer sheet now, and whoever puts a picker back behind the press that
    builds will rediscover the same lost minutes.
    * release.ts said changing the port later was in the settings. It is
    askAgain, and err.cable_no_device already tells the reader so.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
2026-08-25 feat(app-package): name the odd keys out when §5.1 refuses
    "Replace the odd ones out" is a sentence somebody can only act on by
    opening every sheet in the Sammlung one at a time: which collection a
    picture came from is a fact about the reference, and the reference is
    the one thing no editor shows.
    So the walker over a Sammlung's symbols carries where each one sits -
    the button and its page, or the key and its set - and the refusal names
    the minority, which is the shorter list to put right. Three of them at
    most; a sentence naming forty buttons is a sentence nobody reads.
    Still one walker, for the reason references() always gave: a new place
    to put a symbol that only one of them learns abo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
2026-08-25 docs(cable): the pre-build probe is a bad trade, and the firmware says why
    The Device panel's removal left the two-build path as the only way back from
    a wrong port, and named the fix: probe the talker before the build, as open,
    hello, close, build, open again. Three files carried that as worth doing.
    Checked it against the firmware before building it, and it should not be
    built. `hello` is not a quiet question. cable.h calls progress("hello") and
    vorlaut.ino answers by putting Kabel on all five displays, deliberately - the
    comment says it is meant to be obvious that the keys have stopped. Closing
    the port does not take it back, because nothing on the wire tells the device
    the browser has g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
2026-08-25 feat(editor)!: ask what a press does first, and offer three kinds
    The button sheet asked four questions in the wrong order. "Beim Druecken"
    came last and decided whether the fields above it meant anything: a
    navigation button says nothing, so its Gesprochen field and its play
    button were two dead controls with nothing on screen saying so. It is
    asked second now, directly under the label, and the rows follow it -
    Gesprochen and its play button are gone for a button that leads to a
    page, and the target list is there instead.
    Three kinds rather than four. vorlaut-app draws Speak, Undo and Clear as
    permanent chrome on the message bar (TalkerScreen.kt, design.md 4.3,
    with Speak as the screen's o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
2026-08-25 test(e2e): drive the sheet in its new order, and cut a sample without the bar
    The helper fills the act before Gesprochen, because that is the sheet's
    order now and a fill before the act is chosen would type into a row
    about to be hidden. `home` goes through the target list rather than
    through a kind of its own.
    The sample loses its two bar-control buttons, which cannot be authored
    any more, and gains the exclamation it never had - so the archive still
    carries a button whose press speaks at once, with the clip that earns.
    `:home` still arrives, from the button on the second page.
    And the case the sheet can no longer make: a `sayBar` act written
    straight into the stored layout, which is the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
2026-08-25 test(cable): refuse every verb until greeted, in both stand-ins for the device
    cable.h keeps one rule with `open`: a session starts ungreeted, a hello opens
    it, and a transfer given up on shuts it again - so "not greeted yet" and
    "just lost a file" are the same state, and the way back is always hello.
    Both stand-ins modelled only the second half. tools/cable_mock.js and the Fake
    in tests/cable_dump.cpp each called it `broken`, starting false, so a verb
    sent before any hello was answered as though the device had been greeted.
    They drifted the same way, which is why neither caught the other, and
    check_sessions() could not see it either: it compares the files a session
    ends with, and this is a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
2026-08-25 docs(packages): sequence the bildquelle 1.6.0 bump before cutting it
    The pin says 1.5.0 and the main checkout was running 1.6.0, so tests taken
    there measured one version while naming the other. installcheck caught it and
    npm ci put it back; what was missing was any record of why 1.6.0 was on disk
    at all, and of what the bump it belongs to still needs.
    Not an accidental re-resolution, and it could not have been: 1b0c0c2 exists
    only on this machine, node_modules/.package-lock.json still recorded a correct
    1.5.0 install at 95ed75c, and dist/, src/ and package.json inside the package
    had been overwritten a minute later, byte-identical to the bildquelle working
    tree, while LICENSE and README be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
2026-08-25 Switch the symbols too, not just the labels
    The language menu has moved every string on this page since it was built,
    and never moved the one thing underneath them: symbol search asked
    ARASAAC's German endpoint and ran the German pipeline whatever the page
    said. An English reader got an English interface over a German lookup.
    It failed quietly, which is why it lasted. ARASAAC's German endpoint does
    not reject an English word - it answers one, out of its tags and synsets -
    so "water" came back as a water-transport sign. Nobody saw an error. They
    saw a board with the wrong picture on it, which is worse than an empty
    square: an empty square is something a carer fixes.
    bildquelle 1.6.0 is what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
2026-08-25 docs: say what the 0.1.0 notes are missing, and why it is not a rebase
    fa6e4d2 landed on main without a conventional prefix, so release-please
    cannot see it: the Release the builder run after it left the pending
    changelog untouched, which is the silent failure commit-messages.yml
    exists to catch. It caught it, after the push.
    The commit is not rewritten. It is shared history with two merges on top,
    and the check's own guidance for one already on main is to leave it and
    say so in the next release's notes. This is saying so, in the file whoever
    merges that release will be reading, with the line to paste.
    The clone it was written in had no core.hooksPath, which is exactly the
    case the section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
2026-08-25 docs: drop the 0.1.0 note now that 0.1.0 is out
    The section said to delete it once the release was cut, and it is: the
    line it was holding is in CHANGELOG.md and in the builder-v0.1.0 release
    notes, so the note has nowhere left to point. It was a record of one
    commit rather than a rule, and leaving it would read as one.
    What stays is the section above it, which is the rule: the gate is CI
    because core.hooksPath is per-clone and the failure it guards is silent.
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2026-08-25 test: let the changelog quote the German it changed
    Cutting 0.1.0 created CHANGELOG.md, and the language sweep failed on it
    the moment it existed: one entry reads `say "Zugriff bestätigen" in the
    heading and put the reason in the panel`, and the umlaut is the whole of
    what is wrong with it.
    Nothing is wrong with it. A commit subject that quotes the German string
    it changed says which heading, and the sweep's own rule is that *we*
    write English - nobody writes this file. release-please assembles it out
    of subjects that are published history, so the German cannot be edited
    out of it later without moving tags that consumers already resolved.
    german.ALLOWED was the other option and does not h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
2026-08-25 fix(case): give the Feather's connectors their own number, not an allowance
    The cables arrive in black push-on Dupont shells that slide down over the
    headers and stand well above them, and they need room to go on and come
    off. That room was never modelled. It was standing in a generic
    extra_above_carrier "cable headroom" figure above whatever part happened
    to be tallest, which is exactly the shape of thing that gets trimmed when
    somebody is shrinking a case - and it was, twice, from 14.00 to 6.00 to
    0.00. Each time it looked like removing slack and was really taking the
    connectors' room away.
    feather_headroom = 14.00 now, named after the thing that needs it, and
    inner_z_h takes whichever fl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
    [vorlaut-case.scad]
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2026-08-25 fix(editor): say what the first column costs across the sheet, not above one field
    "Diese Taste steht in der ersten Spalte ..." is about the button as a
    whole - that this edit lands on every page, and that the same press can
    take it off all of them. It was pushed into `rows`, and those become the
    form column, so a sentence about the button stood over `Aufschrift` in
    the narrower measure of the two and read as a note about that field.
    openSheet() grows a slot of its own for it. `.sheet--button > .body` is
    a two-column grid, so spanning is `grid-column: 1 / -1` on a child of the
    body rather than a row inside a column - which is also what keeps it
    right where there is only one column: the page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
2026-08-25 refactor(editor): one line per question in the tablet button sheet
    Gesprochen was the last row still saying what an empty one means from
    inside the field. A placeholder is gone the moment somebody types - and
    what it says is *about* the empty field, so it disappears exactly when
    somebody is wondering how to get back to it. It moves onto the caption's
    line, the treatment Aufschrift already has, and the field is left bare
    rather than saying the same thing twice.
    Both sentences are shortened, and that is the condition of the treatment
    rather than a tidy-up. The caption's line is the form column less the
    caption - 312px at 1280x720 - and a note that wraps there is two lines
    where the note under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
2026-08-25 feat(case): put the icon and a name you can set on the front
    The top margin the Feather's bay opened up leaves a band above the keys.
    The speech bubble goes there with the device's name beside it - icon
    first, then the name, as the child reads them. One string sets it:
    name_text = "Bente"; // "" for none
    Everything else follows. mark_y comes from whatever reaches highest on the
    face, the key cutouts or the speaker grille, against the top edge less its
    chamfer - so the band cannot be got wrong by moving something else. The
    pair is centred and comes to 52 mm on a face with 123.5 mm of flat.
    Cut in rather than raised, and that is not a preference. The tub prints
    front face DOWN on the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
    [vorlaut-case.scad]
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2026-08-25 feat(editor): cross a key's picture out from the sheet that opens it
    A checkbox under the two things done to the picture as a whole, in the picture
    column both editors share, so one control serves the five-key board and the
    tablet. Not a third button beside them: those change which picture is on the
    key and this says what the key means by it, and it stays true while the
    picture under it is swapped.
    Hidden while there is no picture, for the reason the ✕ is - there is nothing
    to cross out - and back the moment one is picked.
    Not on a set key. That is navigation rather than a word, so there is nothing
    on it to negate and BoardSet grows no field.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
2026-08-25 fix: file a crossed-out picture apart from the one it is drawn from
    Every picture in this repository was filed under its reference alone - the
    tile cache in the build, the baked images in a package. A cross is baked into
    pixels, so a reference and a crossed-out reference are two files; keyed by the
    reference the two shared one, and whichever was drawn first won both.
    What that looks like is a board saying "Brot" where it was built to say "kein
    Brot", silently, everywhere except on the device.
    pictureKey() is the name both ends now agree on, and symbolPlaces() carries
    which places wanted which - the bake loop walks that rather than references(),
    because a list of references cannot say it.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
2026-08-25 fix(obf): keep a crossed-out key crossed out through a document
    A board that leaves as a document and comes back has to be the same board, and
    the normalizer rebuilds a slot field by field - which is exactly how a field
    added later gets dropped on every import without a word.
    ext_vorlaut_negated, this file's own namespace, and deliberately not
    ext_lautstark_: that list belongs to exchange/SPEC.md, is closed at v1 §4.3
    and is read by software that is not this repository. Written only when it is
    true, so every board frozen in tests/reference/obf.lock.json is still the
    document it was.
2026-08-25 test: hold the cross to every side of the seam that has to agree about it
    Twelve unit checks over the pixels, the picture keys and the round trip, and
    one end-to-end test per editor: the five-key board's own, and the tablet's,
    which exports the package and opens it to see two PNGs from one upload on two
    buttons that name different ones.
    That last assertion is the feature. A cross drawn in the wrong place is a bug
    somebody sees; two keys sharing one baked file is a board that says the
    opposite of what it was built to say.
2026-08-25 docs: correct why a cross beats a negation symbol of its own
    The note on Slot.negated said METACOM ships no negation symbol "and
    never will". It does: bildquelle's src/metacom.ts files it under
    nichtkein in Kleine_Worte, the negation pair run together because a
    filename cannot hold the slash, and 1.6.4 exists to split it so a search
    for either half reaches it. vorlaut took 1.6.4 in e8fa30c, so the claim
    was contradicted by the dependency bump one commit earlier.
    The feature is right and the justification was not. A negation symbol on
    its own key says the negation; it cannot say which word is negated, and
    a four-key set has no sentence bar to join the two. That argument holds
    whatever any co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
2026-08-25 feat(import): read a Sicherung of one Sammlung through the door that adds
    The Board panel took an .obf or an .obz, and both of those become a talker
    layout on the way in - at most five sets of four keys. So a tablet Sammlung
    had exactly one way into a browser: the Daten panel's restore, which replaces
    the whole library to do it. Somebody wanting one board beside the ones they
    have had to export their own Sicherung first and merge the two by hand.
    The same button reads a Sicherung now, provided it holds exactly one
    Sammlung. What makes this an import rather than a restore is that the id
    stays behind: the file may well be a Sicherung this browser wrote an hour
    ago, and carrying the id through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
2026-08-25 docs: answer 0006's first condition, and say what the device format is missing
    ADR 0006 names four conditions for revisiting the one-repository decision, and
    condition 1 asks whether layout.bin and the cable protocol are frozen for good.
    Measured against the week of history, they are not: the transport was replaced
    entirely three days ago, cable_format.h names a pending change to both halves
    of the protocol, and layout_format.ts had a breaking change yesterday that
    permanently cost one of the seventeen frozen cases.
    So the recommendation is not to split. What the proposal does instead is design
    the fixture set the split would need, because the same fixtures close holes that
    exist today insi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
2026-08-25 feat(device): drop the per-set colour from layout.bin
    The set entry opened with two bytes of RGB565 and no longer does: 184
    bytes per set instead of 186. The colour is going from the talker
    entirely - the editor's swatches and the app package's field go in their
    own commits, and the firmware stops drawing it in the one beside this.
    LAYOUT_VERSION goes to 2 with it. A file written before this is not a
    shorter file but a differently shaped one, and its length still adds up
    - 186 per set is more than 184, never less - so parseLayout() would take
    it and hand back every name and hash read two bytes late. Version 2
    turns that into a refusal, which the device shows as no content and a
    reason on th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
2026-08-25 feat(firmware): draw the five tiles without a set colour
    SetEntry loses its colour, parseLayout() reads the name from the front
    of the entry, and drawTile() takes no frame argument. The six pixels
    round the symbol are blacked out instead of coloured, and nothing
    replaces the colour: a border in one fixed value would be identical on
    every key of every set, which is exactly the information the colour
    carried and no longer has to. They are still painted rather than left
    alone, because drawMenuKey() puts a grey frame on those same pixels and
    coming back out of the menu has to take it off.
    The menu keeps its grey frame and keeps saying what it said - a frame
    against no frame reads at least as cl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
    [layout_format.h, vorlaut.ino]
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2026-08-25 fix(diy): call a set a Seite, the word the tablet editor already uses
    Two editors, one idea, two nouns: the tablet's boards are Seiten and the
    talker's were Sets. The talker's on-screen word moves. Nothing under it
    does - the board ids in exchange/, SET_BUTTON in firmware/, DiySet and
    the ui.set_* keys themselves all keep their names, because a wire name
    that changes is a format change and this is not one.
    Seite is the word this repository has already collided with once, in
    cb8debb, where "eine Sammlung wechselt später nicht die Seite" meant a
    side. Two live collisions turned up this time, both against Seite the
    *web page* rather than Seite the side:
    - The transfer sheet says "danach find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
2026-08-25 style(sheet): take the colour row out of the Set sheet
    The last thing the swatches were waiting on was the firmware, and it has
    stopped reading the colour, so the row goes with it. What is left in the
    card is a name and a picture - which is what a set is told apart by on
    the device, and what the set key has carried all along.
    Three other renderings of the same value go too:
    - the board's device preview. previewInto() filled the 128x128 with the
    set's colour and drew the 116x116 tile inside it; it fills black now,
    which is what drawTile() fills those pixels with. The preview is only
    worth having while it is the device.
    - the set key's edge, which promised a border the device no longer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
2026-08-25 style(sheet): give the create dialog its own rhythm, since p + p gives it none
    components.css spaces a sheet body with `.sheet > .body > p + p`, which is the
    rhythm of prose and holds only while a body is nothing but paragraphs. This
    body is two <button> cards, a conditional <div> question and a closing <p>, so
    the adjacency never matched and `margin: 0` was the whole of what applied: the
    two cards touched each other and the note stood on the second card's border.
    The gap goes on the body rather than on the note. What is missing is this
    dialog's rhythm, not anything about a .note - and a rule naming .note here
    would be this file redefining a shared component from underneath, which is the
    mi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
2026-08-25 fix(shell): the open Sammlung's row follows what is done inside it
    The sidebar row draws two things off state.layout - how much is in the
    Sammlung, and on a tablet how big its pages are - and paintCollections()
    only ever ran when the *list* changed: opened, made, renamed, deleted. An
    edit inside the open Sammlung changes neither, so placing a button left
    the row at its old count and resizing the grid left the row naming the
    old size while the panel that had just changed it named the new one an
    inch away. Both came right on the next switch or reload, which is the
    shape of a bug that reads as lost work.
    The repaint goes in each editor's commit(), not in save(). The row goes
    stale the moment s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
2026-08-25 fix(editor-app): give the Raster panel's options back the rules they lost
    The word-colour choice and the two first-column switches carry `.does` and
    `.does__opt`, written for the button sheet's "what a press does" chooser. That
    chooser became a dropdown in 2d18063 and the rules went out with it, but this
    markup stayed - so since then both groups have drawn as a run-on paragraph:
    "Als FlächeDie ganze Taste in der Farbe ihrer Wortart. Als RahmenNur der
    Rand.", three choices wrapping into each other with no box, no gap and nothing
    to show which one is in force except a radio dot.
    Nothing about what the panel does changes. The rules are the deleted ones, put
    back under `.opts`, which says what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
2026-08-25 fix(shell): even the steps between the first board and 6x11
    3x5 -> 4x6 -> 5x8 -> 6x11 grew by one row each step but by one, two,
    then three columns, so the offered sizes were not the even ladder the
    comment beside them describes. 4x7 and 5x9 make each step +1 row and
    +2 columns, and both stay inside minRows..maxColumns.
2026-08-25 fix(board): give dark line art a light ground in dark mode
    A METACOM symbol is black strokes on transparency and carries no ground
    of its own, so on a dark cell it took the cell's and disappeared - "Wort"
    and the question mark went to nothing at #1f1f22. "Haus" survived, and
    only because it happens to be filled white.
    The white goes under the <img>, not on the cell. Making the cell light in
    a dark scheme is one rule fewer and turns a 3x5 board into fifteen white
    rectangles; this leaves the board dark and gives paper to the one thing
    that needs it. It also decides per picture without being told which is
    which, because a background behind a fully opaque edge-to-edge image is
    never seen - whic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
2026-08-25 fix(save): visiting a Sammlung is not editing it, so it does not rise
    Switching Sammlung saves the one being left, so that what happens next
    reads a store the screen agrees with - and doSave() wrote whether or not
    anything had changed. Every write is a touch of updatedAt (data/store.ts)
    and the sidebar is ordered by it, so a save with nothing behind it said
    "somebody has just worked on this one" about a Sammlung nobody had
    touched, and paintCollections() then redrew the list in that order.
    The list therefore reordered itself around the pointer. Leaving a
    Sammlung floated it to the top, which moved every row below it at exactly
    the moment somebody was reading them, and the row that had just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
2026-08-25 feat(sheet): cut somebody's own picture to a square before it is kept
    A photo off a phone has always worked and has never filled a key. tiles.ts
    fits a picture into the device's 116x116 preserving its proportions and
    centres it on the set's colour, and app_assets.ts does the same at 512 for
    the tablet's package - so a 4:3 photo arrives as a strip with a quarter of
    the key given over to ground colour and the child's face smaller than it
    needed to be. This is about filling the key, not about fixing a fault.
    Only ever somebody's own file. A METACOM pick is a reference into a folder
    the family licensed and a crop is a derivative, which SPEC.md §5.2 forbids;
    ARASAAC pictograms are already squar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
2026-08-25 feat(tiles): the symbol fills the key, and the reference was re-frozen
    TILE_SIZE is IMG_SIZE. There was a BORDER of 6 between them and the tile
    was the 116x116 square inside it; the border was the set's colour, and
    once that went the six pixels were being blacked out to say nothing. A
    symbol has them now - a tenth wider in each direction on a key 15.21 mm
    across, for 22% more bytes a file. TILE_PIPELINE goes 2 to 3, which is
    what makes every device fetch every tile again rather than mistake an
    old one for current.
    tests/reference/tiles.lock.json IS rewritten, and it is the first lock
    here that ever has been. It could not be narrowed the way the other two
    were: a different target size means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
2026-08-25 feat(firmware): draw the tile edge to edge
    drawTile() writes the whole panel from the file: setAddrWindow(0, 0,
    128, 128) and no surround. The four fillRects went with the six pixels
    they used to paint, and so did the clear before them - a tile that
    reaches the edge covers whatever was on the panel, including the grey
    frame drawMenuKey() leaves behind. Only the missing-file path still
    clears, and it clears the screen.
    TILE_BORDER was two things wearing one name: the tile's inset and the
    menu's frame width. The first no longer exists, so the constant is
    MENU_BORDER and belongs to the menu alone. TILE_W and TILE_H stay as the
    names for what a file holds - DISPLAY_W and DISPLAY_H now, the same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
    [vorlaut.ino]
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2026-08-25 fix(sheet): the sheet's Fertig keeps the open crop instead of dropping it
    Reported from actual use, one try in: choose a picture, move it about, press
    the one primary button on the screen — and nothing arrives on the key, with
    no sentence anywhere saying why.
    It was defensible written down. Nothing is written until the confirming
    press, so the crop was dropped and the key kept what it had, and no way out
    of this sheet had cost anything. That rule is right and it stays; what was
    wrong is which presses it covers. A foot button *is* the confirming press.
    The corner ✕, Escape and a press outside still cost nothing, which is the
    same line openSheet already draws between a press that resolves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
2026-08-26 refactor(sheet): the crop keeps no buttons of its own
    The second one goes the way the first did. The sheet's foot already says
    Fertig and its corner already says ✕, and both mean here exactly what they
    mean everywhere else in this sheet - keep what is in it, and never mind.
    A control in the picture column repeating either of them a few inches higher
    is not a choice, it is a question about which of the two is the real one.
    That question is what produced the report this started from, when there were
    two buttons meaning yes.
    So the row of buttons goes entirely while a square is being chosen - the row
    and not only the buttons in it, because an empty flex box is still a grid
    item and .pick's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
2026-08-26 refactor(builder): the device's audio format leaves the build's orchestration
    16000 was a literal inside VORLAUT in backend/local.ts, which is where the
    recording chain is asked for a word. That put the browser's whole opinion
    of the device's audio format in the middle of the orchestration, and the
    consequence is the one docs/device-interface.md names: what the device
    accepts is whatever seekToWavData() walks past, and nothing on this side
    was ever held to it.
    The three numbers move to data/audio_format.ts, beside layout_format.ts
    and tiles.ts, where device/fixtures/audio/ can hold both ends to them.
2026-08-26 feat(device): conformance fixtures both ends are held against
    docs/device-interface.md recommendation 2: write the fixtures, and write
    them first. Not as preparation for a split - recommendation 1 is not to
    split, and the evidence there says the condition is not close to met -
    but as the check this repository is missing today, inside one repository,
    with both implementations sitting next to each other.
    38 fixtures over the four gaps that had nothing holding them together:
    layout/ every field and stride, and all five refusal codes.
    tests/reference/layout.lock.json has seventeen frozen cases
    and refuses none of them, because a capture can only contain
    what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
2026-08-26 test(device): two runners over the fixture index, and a mutation pass
    tests/unit/device_fixtures.test.ts is the builder's half - renderLayoutBin
    must write these bytes, TILE_SIZE must be this number, hashBytes must read
    this hash out of this name, and the cable client must write these host
    lines when it is given these device lines. Needs node.
    tests/test_device_host.py is the firmware's half - parseLayout,
    seekToWavData, tileReadRow, hashPath, cableNameOk and setLanguage,
    compiled from the headers the sketch includes and run against the same
    index from the other side. Needs a compiler. Neither reads the other.
    Neither replaces test_layout_frozen.py or test_cable_format.py, which
    hold the t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
    [devicemutate.py]
2026-08-26 fix(device): four holes the mutation run found, and one it cannot reach
    45 of 50 faults caught on the first run. The five that were not:
    The fixture runner's import of tools/cable.js escaped the repository root
    - three ../ where two belong - and Vite resolved it to something stale
    rather than failing. Every cable check on the browser side was passing
    against a copy of the client that no edit reached. Two mutants were
    "missed" for that reason alone and are caught now.
    The short tile said where the file ran out and nothing about what was
    there instead, so removing the zero fill changed no number it asserted.
    A reader that drew whatever was left in its row buffer would report
    exactly the same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
    [devicemutate.py]
2026-08-26 docs(adr): 0009 records the fixture set, and 0006 gains its dated line
    docs/device-interface.md says what would earn an ADR: not the answer to
    0006's revisit clause, which concludes 0006 was right and is therefore not
    a new decision, but the fixture set - a third artefact both implementations
    are held against, in a directory belonging to neither half, with a fourth
    tag prefix. That has the shape adr/README.md describes: a thing that looks
    like an oversight from outside, whose cleanup would undo something decided
    on purpose. The cleanup section names the two that will be proposed.
    0006 is not superseded and its status does not change. It gains an
    Examined section saying condition 1 was measu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
2026-08-26 fix: reassemble "liest … vor" and "häng … auf" into one word
    Pins bildquelle v1.6.5, which is where the German lexicon lives. It
    gained vorlesen and aufhängen, so a split separable verb the tables did
    not hold now comes back as one word with one symbol rather than as a
    verb and a stray preposition.
    Data only — no export moved and no rung of the ranking ladder changed,
    which is the kind of change picker_match watches for. It and the rest of
    the suite ran against the commit before the tag was cut.
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2026-08-26 feat(app): a new Sammlung starts with a way back to the start page
    A blank tablet Sammlung was one empty page on a 3x5 grid, and the first
    thing every board built on it got wrong was the same thing: a subpage with
    no way back. That is silent - the board looks finished, and it strands a
    child on whichever page they pressed into.
    So a new Sammlung is handed four starting values. The first column belongs
    to the Sammlung rather than to each page, drawn with the gap that says those
    keys stay put; the lower-left cell of that column is a `home` key, which
    exports as SPEC.md §7.4's `action: ":home"`; and colour by word class is off,
    because a Fitzgerald key nobody has assigned yet paints every but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
2026-08-26 fix(app-package): hand the package over as .zip, so Android takes it
    The package downloaded as `<name>-app.obz` and Android would not have it.
    Chrome goes by the blob's media type where the extension is unregistered,
    so a file declared `application/zip` and named `.obz` is one the download
    manager refuses — and a package that cannot reach the tablet it was built
    for is worse than one whose name does not say what it is.
    The bytes are unchanged and nothing on the far side can tell. Verified on
    the emulator before changing anything: the same package renamed to .zip
    imports cleanly, because neither BoardPackageImporter nor the viewer's
    import path ever reads a filename, and `application/zip`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
2026-08-26 feat(editor): a page picker at the right edge, listing every page
    The strip is about to stop being a tab per page, and this is what has to exist
    first. The row that replaces it shows the pages the page on screen opens, so a
    page nothing opens will be in no row anywhere - and the wrapping strip was how
    an orphan got reached, fixed or deleted. Landing the row before this would
    take away the only door to a page somebody built, which is worse than the
    problem being solved.
    So: every page, reachable or not, in the order they sit in the Sammlung,
    behind a control labelled with how many there are. The count includes orphans,
    because this is where orphans live and a count that skipped them would
    di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
2026-08-26 feat(editor): one row of what this page opens, in a height that cannot grow
    The strip was flex-wrap with no cap, no scroll and no max-height. Twenty-one
    pages already wrapped to three rows and forty would take six, and it grew
    downward - so the board being edited went off the bottom of the screen because
    of the chrome describing it. It failed in the one direction that cannot be
    lived with.
    What replaces it is one row of the pages the page on screen opens. Pressing
    one makes that page current and the row is replaced, never added to: no second
    level, no indentation, no tree. Depth is the path's and the path's alone.
    Two rows' worth of height, always reserved, so the board's top edge holds
    st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
2026-08-26 fix(design): take v1.17.0, so a card has an edge that can be seen
    The planes moved apart and --line stopped being a shade: 1.45:1 against
    --surface became 3.05:1 in dark and 3.13:1 in light, which is what WCAG
    1.4.11 asks of anything saying where a component is. A Sammlung row used
    to sit on the page at 1.10:1 with an outline nobody could see.
    Pin rather than a range, as every consumer of this repo does — the tag is
    what makes the tokens reproducible.
2026-08-26 fix(symbols): name the rendering in the start key's METACOM reference
    HOUSE.metacom was "Haus/haus4SW" - a category and a file, with no rendering
    folder. METACOM ships every symbol in parallel folders holding identical file
    names, so that stem named four files in one licensed copy: PNG and JPEG, framed
    and unframed. Resolution answered with whichever the index walked first, and the
    framed rendering carries a border and the word printed into the picture - which
    is how a prescribed key came to show a caption nobody wrote.
    This is the fault pickReference() was written to fix, arriving at the one
    reference in the product that never goes through it, because it is written by
    hand. It is also the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
2026-08-26 fix(editor): draw the board's start key as the tablet draws it
    HOME_TONES already described the intended rendering - black strokes to #EBEBF0,
    the white interior to the plate's own #24242A - but the treatment was applied in
    exactly one place: .pick__hit--home, the picker's preview. The board cell got
    nothing, so the editor showed a white tile where the tablet shows a two-tone key,
    and the one cell the editor could not preview was the one cell that does not look
    like its own picture.
    The cell is now marked by BoardScreen.kt's own test, restated rather than
    approximated so the two cannot answer differently on the same button: a bare
    :home, no fill, no border. An appending one really is a word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
2026-08-26 fix(editor): put the pages nothing leads to back on the page strip
    The row over the board holds the pages the page on screen opens, so on a
    Sammlung nobody has linked yet it holds nothing - which is every Sammlung
    for the whole of its first sitting, and linking pages is the work the
    editor exists for. Three pages and no navigation drew a sentence, a count
    at the far end of the bar, and no page anywhere.
    They are drawn at the end of the row now, each wearing the same warning
    glyph the picker and the path already use. That mark is the only
    difference between such a tile and any other: a label over the run and a
    dashed edge on every tile in it were both drawn and dropped, because on a
    board wh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
2026-08-27 fix(editor): mark a way onward by its corner and a way back by its edge
    Three marks on a cell, and two of them had something better beside them.
    A goto button carried an arrow badge in one corner and, since the page
    tiles went, the corner that follows the link in the other. Two arrows on
    one cell saying the same thing, one of which does nothing when pressed.
    The badge goes.
    A home button carried a house at 11px. The way back to the start page is
    the one button on a board somebody reaches for without reading the word on
    it, so it wants to be findable from further off than a glyph manages: it
    wears a heavier edge instead, on every home button rather than only on the
    ones with no colour of th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
2026-08-27 fix(editor): give a cell's two corners seats that never move
    The corner that follows a link and the one that plays a word shared the
    top right, with the follow stepping a button's width to the left where
    both were drawn - a goto button that carries its word into the sentence
    has something to audition as well as a page to follow.
    It worked, and it was the wrong shape. A rule that holds only while a
    class is applied and an offset stays in step with a clamp is one that
    comes apart quietly, and it looked broken to anybody who saw the app
    between the two commits. Two seats that never move cannot: the follow is
    top left, the play is top right.
    The left seat is free exactly when the follow exists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
2026-08-27 fix(shell): one scrolling area in the settings sheet, and a foot for the panel
    The voice list was a box of its own - 340px of overflow inside a body of
    about 460 - on the argument that a personal Azure key brings hundreds of
    rows. The argument is true and the box was still wrong.
    @lautstark/design says of this very sheet that two nested scrollers are
    "a way to lose the Save button without noticing it is there", and that is
    what happened: a wheel gesture latches to whatever is under the pointer
    for its whole run, so with the pointer over the voices the sheet did not
    move at all and the button at the foot of the panel below could not be
    reached. Which is why it only happened sometimes - it dep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
2026-08-27 feat(firmware)!: acknowledge every window of a cable transfer
    The device now sends its window with "go", writes at most that much file
    content before answering "ack" with the running total, and the browser sends
    nothing until it has. The bytes in flight are bounded by what the device asked
    for rather than by how fast the browser can write.
    That is what CABLE_RX_BUFFER was standing in for and it goes. 64 KB was sized
    against a burst - 490 KB/s of USB against a 46 ms flash write - and it was a
    bound rather than a guarantee: a longer stall on a fuller partition would have
    overrun it too, and CDC has no way to say so. The receive buffer is now one
    window, because one window is by construction t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
    [cable.h, cable_format.h, vorlaut.ino]
2026-08-27 feat(tools)!: the browser waits for each window to be acknowledged
    put() takes the window off the "go" line, sends that much, and waits for an
    "ack" carrying the running total before sending any more. The number is read
    rather than assumed: the device is the end that knows how much room it has,
    and a browser that decided for itself would be back to guessing.
    The mock gains the other half, and a way to be slow. A device made of a Map
    answers instantly, so a client that never waited would pass against it
    forever - the thing being waited for is a flash write. So it can be given a
    stall, and anything arriving beyond the window while it is in there is thrown
    away rather than stored, which is wha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
2026-08-27 docs: survey what is still moving in the three formats
    adr/0006's dated line of 2026-08-26 rested on one pending change, found
    by grepping for the word. This is the whole list, so that a freeze can be
    a decision rather than a hope.
    Six pending items across layout.bin, the cable and the package format.
    Two of them block a device freeze, four can wait behind a version, and
    none invalidates a lock as it stands - though two would if they were
    resolved in the reader rather than in the writer, and layout.lock.json
    has no oracle left to be rewritten from.
    The two that are new findings rather than restatements:
    sleep_timeout_seconds has a value at each end that the format allows
    and the reade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
2026-08-27 test(device): hold both halves to the acknowledged transfer
    The transcripts gain the window and the acks, and one of them - several-windows
    - announces 256 where every other announces 4096, so a browser that had kept a
    chunk size of its own agrees with the rest and fails that one. Its last window
    is short on purpose: the end of the file ends the window.
    The browser-side runner gained the check that makes any of this mean something.
    The bytes of a file are the same bytes whether they were sent a window at a
    time or all at once, so comparing them says nothing about the waiting - and the
    waiting is the change. What differs is that one of them has run ahead, so the
    runner now refuses a client t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
    [cablemutate.py, devicemutate.py]
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2026-08-27 docs: the .obz can carry the device build, in a form of its own
    Corrects the previous commit, whose answer was no and whose reason was wrong.
    SPEC.md §5.2 does not forbid baking METACOM pixels; it forbids baking them into
    a file that travels, and blesses the sideload case by name. The device build is
    already that case - picture() resolves a metacom: reference out of the licensed
    folder and renderSymbol() puts it on the wire, with no gate anywhere on that
    path and none wanted.
    The error underneath was testing the two existing exports as candidates. One is
    a document for other AAC software, so it carries references; the other is a
    delivery for a tablet, so it carries Android's shapes. The de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
2026-08-27 docs(cable): the window replaces the receive buffer
    The protocol section gains the go's window and the ack's running total, and a
    section of its own for why the number is the device's to choose and the
    browser's to read.
    The measurement table is the part that had to be rewritten rather than
    extended. Its numbers were taken under version 1, where the browser sent
    whether or not the device was listening, and a gap of 0 ms meant a 64 KB buffer
    was swallowing the burst rather than that the wire was quick. They are kept as
    history and marked as such, and what version 2 has to report is written down
    before the run instead: a gap that is small and NOT zero, a stall that no
    longer matters, a rate s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
2026-08-27 fix(build): an empty key is blank on the device, not a missing picture
    A slot holding neither a word nor a picture drew tiles.placeholder() - the grey
    cross that says "no picture yet" - so a key nobody had put anything on looked
    on the device like a key whose symbol had failed to arrive. The tablet had it
    right all along: diyBoards() writes no button there and the cell renders empty.
    Nothing could have caught it. The build walks a Layout and writes tiles, the
    export walks the same Layout and writes an .obz, and neither has ever read the
    other's output, so the disagreement had no test to fail. It was found by
    comparing the two by hand while answering whether an .obz could be the build's
    inpu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
2026-08-27 docs(adr): 0006 gains the distinction its argument was missing
    The Why rejected extraction with "used by each other and by nothing
    else", which states one criterion where there are two. A second
    consumer is the test for extraction; a second implementation is the
    test for a specification. The device format meets the second and not
    the first, so the answer it asks for is a written format with fixtures
    rather than a move — which ADR 0009 already built.
    Somebody reading the old sentence concludes there is nothing here to
    share, and that is why the question kept coming back. The working out
    is docs/obz-as-device-input.md §12, recommendation 5.
    An amendment, recorded as a dated line in Examin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
2026-08-27 docs(format-freeze): repair the citations §9 found, and the ones it missed
    §9 listed six places where prose points at a file that was deleted. Two of
    them travel across a repository boundary: layout_format.h is the file another
    repository would pin, and cable.h promised a second transport - "This does NOT
    replace sync.h. Both are compiled in and both work." - eight months after
    sync.h went with the radio.
    Corrected rather than cut. Every one of these paragraphs is a right argument
    with a wrong pointer in it, so what moves is the name: layout_format.h now
    names renderLayoutBin() and test_layout_frozen.py, cable_format.h's orphaned
    comment becomes the record of why the constant is absent, n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
    [cable.h, cable_format.h, layout_format.h, test5_sound.ino, vorlaut.ino]
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2026-08-27 feat(export): the device build's own .obz, as a third door
    A device build lives in one browser's IndexedDB, on one machine. Nothing
    anywhere said "this is what is on that talker" in a form somebody can diff,
    archive, or hand to whoever is debugging at a bench - the folder export writes
    the loose files and cannot be read back. This writes a file that can:
    readDevicePackage() and compileDevice() turn it into exactly the bytes
    runBuild() puts in the store.
    docs/obz-as-device-input.md is the measurement it comes out of, and its four
    form rules are what this implements. images/ holds the *sources*, at their own
    size and un-crossed, because compiling a tile out of the tablet's fitted PNG
    resample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
2026-08-27 test(export): a device build, out of the export and back
    The comparison nothing in this repository performs. runBuild() walks a Layout
    and writes tiles, WAVs and layout.bin; diyBoards() walks the same Layout and
    writes an .obz; neither has ever read the other's output, so anything the two
    disagreed about had no test to fail. That is how the empty-slot divergence
    survived until yesterday, and the export is where the two paths finally meet.
    What is compared is not a tautology. The expectation is built from the Layout
    with the same two primitives the build uses - tiles.renderPixels() and
    renderLayoutBin() - because those are the device format and a second tile
    renderer in a test would be a sec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
2026-08-27 feat(shell): offer the way back into a METACOM folder where somebody is standing
    A Sammlung whose symbols come from METACOM, opened in a browser whose
    permission for the folder has lapsed, got a paragraph in the picture
    column telling it to go to the gear: close the sheet, find the panel two
    screens away, press the button that chooses a folder, come back. All for
    one browser prompt.
    The sentence was not wrong - the gear is still where a folder is
    connected - it was one step longer than necessary once the Sammlung's own
    panel grew a button for it.
    The seam handed back a string and sheet.ts drew it as a paragraph, which
    is why the button could not simply be added: a sentence is drawn and a
    b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
2026-08-27 fix(layout): the sleep timeout gains a range, and the reader a clamp beside the parse
    Both ends of the field were values the format allowed and the device could not
    use. Zero meant ten minutes through a `? :` in vorlaut.ino carrying a bare 600,
    which src/data/obf.ts had arrived at separately as DEFAULT_SLEEP_TIMEOUT; and
    the top of the uint32 wrapped in `idle * 1000UL`, so the largest timeout the
    format could express was not the largest the device could wait for.
    parseLayout and renderLayoutBin are both untouched. tests/reference/layout.lock.json
    froze the reader's answer for a timeout of zero and one of 0xffffffff, and that
    writer's bytes for the same input, and it cannot be rewritten - th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
    [devicemutate.py, layout_format.h, vorlaut.ino]
2026-08-27 refactor(shell): build canReconnect out of bildquelle's needsAttention
    The rule I wrote yesterday - a folder is one a click can wake when the
    status is needs-setup with permission-needed - is the first half of a rule
    the shared package already owns and bildhaft already uses.
    needsAttention is broader: it counts a folder that could not be *read* as
    well, a path that has gone or an empty directory. Those are somebody's to
    act on and are not things a permission prompt mends, so the narrowing
    stays - a button offering to fix them would open a dialog that changes
    nothing. What goes is the copy of the half both share, which agreed with
    the package on the day it was written and would have drifted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
2026-08-27 fix(cable): the client compares CABLE_VERSION, and a mismatch says which half to change
    The number had been in the greeting since the beginning and nothing that ran
    compared it: findTalker() tested hello.version for truthiness, so any non-zero
    version was accepted and the device driven as whatever this browser speaks, and
    the only other reader was a test grepping tools/cable.js for the digit. That
    was survivable while there was one protocol. Chunk acknowledgement landed on
    2026-08-27 and made version 1 and version 2 two protocols that really exist and
    really cannot drive each other.
    versionVerdict() is the comparison, beside CABLE_VERSION so the number and its
    meaning are one edit apart. Re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
    [devicemutate.py]
2026-08-27 feat(loader): a page that takes an exported file to the talker
    Choose a file, check it, compile it, connect, send - five steps down one
    page, saying what it found at each. It is entirely client-side: the file is
    read with the File API and compiled in the browser, and the only thing that
    leaves the machine is what runs down the cable. exchange/SPEC.md 5.2
    permits a METACOM licensee to bake their own symbols into a package for the
    person they support and sideload it, which is exactly what this is; a page
    that uploaded one anywhere would turn that blessed case into the travelling
    file the rule exists to prevent.
    Checking is the new job. The talker's constraints used to be implicit in
    the only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
    [devicemutate.py]
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2026-08-27 fix(tests): a Trouble word may be built, not only written out
    test_texts_used.py landed an hour ago and turned main red on the next merge but
    one. It reads `new Trouble("folder_stale")` as a lookup of `err.folder_stale`,
    because that is what it is - but it only ever read the literal form, and the
    CABLE_VERSION work landing beside it throws
    new Trouble(`cable_${verdict}`, { device: ..., browser: ... })
    so `err.cable_device_newer` and `err.cable_device_older` arrived reachable by
    nothing the check could see, and it called two live keys dead.
    The rule it already states is the fix: a template names a family. It said that
    about keys passed to `t()` and forgot to say it about words passed t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
2026-08-27 docs(adr): the editor exports a file, the talker's repository sends it
    The live proposal in docs/obz-as-device-input.md and docs/repository-map.md
    was: the editor keeps a device-shaped dependency and pins a compiler package
    published by the firmware's repository. That was replaced on 2026-08-27 by
    something simpler, and nothing in the repository said so.
    ADR 0011 records it. The editor exports a file and stops - one action,
    whatever kind of board it is, no Web Serial, no layout.bin, no tile
    rendering, no build, no transfer sheet. The talker's own repository gains a
    page a person opens with a talker in front of them: choose the file,
    validate, compile, connect, send. No shared package and no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
2026-08-27 fix(loader): name the export the way the menu names it
    The hint on the first step pointed at a menu entry called "Write out for
    the device", and the entry is called "Export as a device package". A
    sentence that sends somebody looking for a control that is not there is
    worse than no sentence.
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2026-08-27 docs: the bill for the split, answered name by name
    tests/unit/layers.test.ts asks that every name crossing src/ <-> loader/
    be answered for before anybody moves a directory. This is the answer:
    ten names one way, thirteen the other, a disposition for each.
    The three that took reading the code rather than the prose:
    data/device_package.ts divides by role. The nine names loader/ takes
    out of it are near enough the reader, and the writer is what stays -
    so the cut on the day is the import list, and what holds the halves
    together afterwards is a package kind under device/fixtures/. That
    is also what device_roundtrip.test.ts has to become, since after the
    split no repository has both ends of i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
2026-08-27 docs: point split-crossings.md at a decision that has landed
    That page and adr/0012 were written the same afternoon and each
    anticipated the other. It asked two questions of 0012 directly and said
    its answer wins; here are both answers.
    The editor pinning device/fixtures/ from the other repository does not
    make it a third owner. adr/0009's rule is about who may change a format,
    and pinning is consumption - vorlaut-app pins exchange/ and acquires no
    authority over it either. 0012's Why says so now.
    Widening the directory by a package kind is not 0012's to draw and it
    does not draw it. 0012 decides where the fixtures live and stops;
    whether they grow a kind is that page's proposal to argue o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
2026-08-27 test(device): refuse a draft version on the fixture set, which is now 1.0.0
    Item 7 of docs/format-freeze.md section 8. device/fixtures/index.json said
    device_interface_version 0.1.0-draft from the day it was written, and ADR 0009
    makes that number the version of the whole interface rather than LAYOUT_VERSION
    or CABLE_VERSION - so a device-v1 cut over it would have been a tag
    contradicting the thing it tags.
    Why 1.0.0. Reaching 1.0.0 from a 0.x is not a breaking change; it is the
    statement that the thing is now stable, which is what a freeze is. ADR 0009's
    MAJOR rule - a device already flashed MISREADING a payload a conforming builder
    writes - governs the increments after 1.0.0, and nothing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
2026-08-27 docs: the loader takes the Pages root when the editor leaves
    Stefanie decided it: the talker's page is the one that picks a file,
    picks a device and sends it, and after the split that is the whole of
    this site. It serves from the root, and there is no landing page.
    This reverses 7c69083, which weighed the question and answered it the
    other way. That page is gone rather than amended - a decision document
    for a settled question is something somebody later has to read to find
    out it decided nothing.
    What is left is the line the decision falsifies. The move costs said the
    talker page's address never changes; its path does, from <base>loader/
    up to <base>. Nothing is bookmarked either way yet,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
2026-08-27 docs: rehearse the split on a copy, and correct the Python division
    git filter-repo was run against a throwaway clone to find what reading the
    code does not. 805 commits in, 496 out, blame intact; nineteen import sites
    break in six targets, and ADR 0012's count of eight crossing unit tests is
    now measured rather than asserted.
    Two things the documents had wrong. e2e/ divides file by file the way
    tests/unit/ does and nothing said so. And repository-map.md had the editor
    "keeping" test_links.py and test_language.py: both are needed by both
    halves, because test_language.py allowlists firmware/vorlaut/texts.h and
    test_links.py checks prose that mostly goes with the talker.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
2026-08-27 feat(device): a package kind under device/fixtures/, and the interface at 1.1.0
    Seventeen fixtures for the .obz the editor writes and the loader page reads:
    six that a conforming writer produces, eleven refusals, and two divergences
    recorded rather than blessed. Authored from one literal by make_fixtures.mjs,
    which goes on importing nothing from src/, loader/, tools/ or firmware/ - the
    manifests, the board documents and the archive framing are laid out from the
    field values, which is what makes a refusal possible at all.
    The archives are stored rather than deflated and their pictures are BMPs, for
    the same reason: this directory regenerates byte for byte, and both a deflate
    stream and a PNG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
2026-08-27 test(device): hold each half of the device package to the fixtures, not to the other
    device_roundtrip.test.ts ran buildDevicePackage() against compileDevice() in
    one process. It was the most valuable check on adr/0011's boundary and it is
    the one the split adr/0012 decided deletes, because afterwards no repository
    has both halves. Three files stand where it stood:
    device_package_writer.test.ts the Sammlung a fixture states, in; the
    fixture's manifest and boards, out
    device_package_reader.test.ts the fixture's archive, in; the fixture's
    answers or its refusal, out
    device_compile.test.ts a committed package comp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
    [devicemutate.py]
2026-08-27 docs(adr): 0013 - device/fixtures/ covers the package as well as the interface
    device/README.md scoped the directory to the bytes between the browser and the
    talker. A package kind widens it to a format between two browsers, which
    docs/split-crossings.md says in terms is a real change of meaning that needs a
    line in an ADR rather than a commit message. ADR 0012 settled where the
    directory lives and deliberately said nothing about what may be added to it.
    The scope is now a rule rather than a place: every format in this toolchain
    with two implementations that have to agree and cannot be released together,
    which is two boundaries and one directory. 0013 also says what does not
    qualify, before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
2026-08-27 fix(store): carry the boards across a DB_VERSION bump, or change nothing
    upgrade() dropped every store on any version bump, on page load, silently.
    It was argued rather than overlooked - conventions.md's rule about its own
    rules, one user and disposable data - and that paragraph names the moment to
    re-read it. On 2026-08-27 the bump to 4 took every board its author had.
    adr/0015: the upgrade now reads the whole database out through the upgrade
    transaction, drops and recreates the schema as before, and writes the salvage
    back - all of it inside that one transaction, so it commits together or not at
    all. data/rescue.ts holds one reader per shape this database has ever had, two
    of them coverin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
2026-08-27 refactor(store): migrate one step per version, instead of sniffing the shape
    adr/0015 landed hours ago with the right decision and the wrong mechanism: it
    dumped every store, recognised the shape of what came out, and rewrote the
    whole database through the current schema.
    Two things wrong with that. It dispatched on a guess when upgradeneeded had
    already handed over oldVersion - the readers needed a validation pass whose
    only job was to notice the guess had been wrong. And it did O(the whole
    database) of work for changes that are O(one store): version 4, the bump that
    cost somebody every board she had, is deleteObjectStore("data") and nothing
    else. A migration that never reads a layout cann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
2026-08-27 feat!: the talker keeps the repository, and the loader page takes the root
    The other half of adr/0012. Lautstark/vorlaut-editor stands with 574 commits
    of filtered history, a green suite and a deployed page, so nothing removed
    here is lost - it is already running somewhere else.
    Gone: src/ and exchange/, the 25 e2e specs and 31 unit tests the editor took,
    the OBF/TTS/symbol locks and their fixtures, the four bench pages and
    obffreeze.py. The old root index.html goes with them and loader/index.html
    takes its place, because Vite emits an entry point at its own path and naming
    loader/index.html alone would go on publishing <base>loader/ for a site with
    nothing else in it. The base is unchanged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
    [test5_sound.ino]
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2026-08-27 docs(cable): four of the six bench rows, from a first run on real hardware
    A full payload reached a talker and it spoke. 25 tiles at exactly 32768 bytes
    - five keys by five sets, none short - 20 WAVs, and a layout.bin of 932 B
    that parses into "set 1: Sprechen", where before the transfer the device
    answered "No content on the device". free is 131072 of 1572864, so 91.7%
    full: the worst case row one asks for, met rather than approximated.
    A second export moved nothing and the device came back byte-identical, which
    with content-addressed names is proof that nothing moved rather than that
    nothing was checked.
    Left blank on purpose: the cable pulled mid-send, and the reconnect. Neither
    happens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
2026-08-27 feat(loader): the step states, the browser gate, and the tokens the design package ships
    A UI pass over the five steps. The largest single finding is that this page
    had a secondary voice written down and none of it on the screen:
    loader/src/style.css asked for --muted and --panel in six rules, and
    @lautstark/design has never exported either - they are mitreden's old names
    for --text-dim and --surface. An undefined custom property invalidates its
    whole declaration silently, so the privacy note, the notes in a finding list,
    the preview lead and the board captions all rendered at full --text, and the
    log and the board block had no fill at all.
    What was wrong:
    * --muted and --panel, six time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
2026-08-27 docs: the talker has run, and the docs said it had not
    The README opened with "has not run on real hardware yet" and closed with a
    callout saying no board had run any of it. Both were already wrong when
    619c5e3 filled in four of cable.md's six acceptance rows, and are wronger now:
    row five is ticked too. A granted port survived the device re-enumerating, so
    getPorts() finds it again and Connect does not have to ask - which was the row
    that could have put a picker on every transfer.
    Five of six. Row three is what is left and it needs a hand on the cable, so it
    is written as still open rather than inferred from a run that went well. The
    version 2 numbers - gap, stall, the rate - have still no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
2026-08-28 feat(cable): the greeting names the build, not only the protocol
    `hello` said one number about a device and it was the wrong one to ask
    which firmware a talker is carrying. CABLE_VERSION moves when the two
    ends can no longer drive each other - rarely, and on purpose - so it
    answers the same 2 for every release in a year. The greeting now carries
    a second word, `firmware`, which is the build.
    Where the word comes from is the part worth reading: nobody edits a
    constant to cut a release. release.yml compiles with -DVORLAUT_VERSION
    out of GITHUB_REF_NAME, through a new `version` input on the firmware
    action, and version.h's default stands everywhere else - a sketch off a
    desk says `dev`, which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
    [cable.h, version.h]
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2026-08-28 chore: read the Renovate preset from Lautstark/.github
    This repository and vorlaut-editor each carried a copy of the shared preset,
    and the two were byte-identical - checked, not assumed. That is the thing the
    file's own header was written to end: it says how to lift it into
    Lautstark/.github without an edit, and both copies were waiting for somebody to
    do it. Now that the organisation repository holds it, both point there and the
    local copies are gone.
    Two references went with it. ci-tests.yml listed the deleted file in its paths
    filter, where a path that matches nothing is not an error and would have sat
    there. docs/releases.md named it while explaining where the fix(deps)/
    chore(deps) sp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
2026-08-29 fix(case): three fits measured on the printed parts
    The mid plate reaches 2 mm further toward the speaker.
    carrier_chamber_gap goes 2.80 to 0.80. That is the cutout's edge, so no
    hole moves, and 0.80 is still four times the 0.20 that made the very first
    plate run into the chamber wall. 2.80 was generous and the amplifier's end
    of the plate wanted the material back.
    The USB-C window moves 5 mm up its wall, toward the end the Feather's bay
    is at. usb_y_shift, measured on the printed case rather than derived.
    The Feather's bracket slot goes from 2.00 to 5.00 mm. This one was a plain
    mistake: the header pin tails stick out of one face of the board and the
    bracket's long wall is on exactly that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
    [vorlaut-case.scad]
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2026-08-30 feat(firmware): leiser and lauter in the menu, kept in NVS
    The volume that landed an hour ago was a constant: right level, wrong place.
    Somebody holding a talker in a room they are in cannot recompile a sketch, and
    the number that needs moving is one only they can judge.
    Nothing had to be given up for it. The menu has had three dark keys since
    fetching content, Wi-Fi and pairing went with the radio, so Info and Back both
    stay and the row now reads Info | Ton 60% | leiser | lauter | zurück. The
    number sits between the two keys that move it, on the same screen, because
    somebody making a device quieter is listening rather than navigating - it was
    going to be a line on the info page, which is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
    [texts.h, vorlaut.ino]
2026-08-30 fix(loader): the page reboots the talker itself, because the buttons are inside the case
    The first person to use the firmware section could not do what it told them.
    "Hold BOOT, tap RESET" is written for a bare Feather on a bench, and this page
    exists for the device after that - an assembled talker, where both buttons are
    sealed in. adr/0017's "not to be fixed later" argued for keeping the reset
    manual; the argument was about convenience, and a closed case is not an
    inconvenience. It is amended rather than ignored, with what the bench said.
    **In.** intoWriteMode() opens the running talker's port at 1200 baud and closes
    it - the Arduino IDE's own touch, which the core's USB stack answers by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
2026-08-31 fix(firmware): a word is read whole before it is played
    The same key sounded metallic on one press and fine on the next. The two
    things that observation rules out are the two everybody looks at first: it did
    not get worse with the volume up, so it is not the case rattling, and it was
    not tied to particular words, so it is not the recordings - which measure
    clean anyway, no clipping anywhere, peaks between -1.5 and -6.7 dBFS, every
    file topped and tailed with silence.
    What differs between two presses of the same file is the file system.
    Playback streamed one 1 KiB read every 32 ms with nothing read ahead, and the
    device it was noticed on is 92% full, where LittleFS does markedly more work
    pe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
    [vorlaut.ino]
2026-08-31 fix(firmware): every select high before any panel is initialised
    Keys 2 and 3 came up rotated half a turn after a flash, and were right again
    after the first sleep and wake. That is two setup paths disagreeing, and only
    one of them is ever seen: waking is what happens all day, and a cold boot only
    follows a flash - which is why this survived until flashing became something
    somebody does twice in an evening.
    What it is not: the rotation table is one table and both paths read it, and
    the library's setRotation() was held against adoptAwake()'s hand-written copy
    for INITR_144GREENTAB - same MADCTL, same rowstart, byte for byte. The release
    before this one touches no drawing at all; its whole di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
    [vorlaut.ino]
2026-08-31 docs(case): the assembly step asks for the foam block the case actually has
    Step 2 told a builder to cut 40 x 40 x 8 mm against "6.7 mm of chamber depth",
    which is the case as it was before it grew. The corrected figures - 20.7 mm of
    depth, a block of roughly 40 x 40 x 22 mm - were written into "The speaker is
    not screwed down" and never reached the numbered steps, which are the part
    somebody builds from.
    The consequence is not cosmetic. That block is the only thing holding the
    driver: it is located sideways by four ribs, sealed to the front plate by tape,
    and pressed onto that seal by the foam when the lid is tightened. A block cut
    to 8 mm stops 14 mm short of the lid and holds nothing, so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
2026-08-31 docs(device-interface): the three uncounted cells carry their date
    The table in section 1 still says the tile, the audio payload and the name
    rule are held together by nothing, and the paragraph under it still says
    TILE_W lives in vorlaut.ino where no test can include it. Both were true on
    2026-08-26 and neither has been true since ADR 0009: TILE_W and TILE_H are in
    tile_format.h, tests/device_host.cpp includes them, and the length rule the
    paragraph calls written down nowhere is device/fixtures/tile/short and
    over-long, checked from both sides.
    The measurement is not rewritten - sections 1 to 8 are what ADR 0009 was
    written out of, and the document says so at the top. What is added is one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
2026-08-31 fix(devicemutate): the writer end left with the editor, and this went on naming it
    tools/devicemutate.py has not run since 2026-08-27. Its baseline asks all its
    runners to pass first - the point of the tool being that a fault nothing
    catches is only meaningful if everything passed before it - and one of them was
    `npx vitest run tests/unit/device_package_writer.test.ts`, a file the split
    took to vorlaut-editor along with the writer it tested. So every invocation
    printed "the fixture runners do not both pass to begin with" and stopped, which
    looks exactly like a tool nobody needs.
    The eight faults it put into that writer go rather than being pointed at a
    copy: a vendored writer is the edit do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
    [devicemutate.py]
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2026-09-01 feat(collections)!: the device holds several collections, and the menu switches between them
    A talker carried one collection in /layout.bin and every transfer replaced
    it. Three finished collections are waiting and they fit - about 6500 KiB
    against the 7040 the file area has - so what did not fit was the format.
    A collection is now one file, c<hash>.bin, holding exactly the bytes
    layout_format.h has always read. The list of collections is not a structure
    anybody maintains: it is what lies in the directory. The device reads 44
    bytes of each file to learn its name and parses only the one it is showing,
    so a second game costs disk and not the 13580 bytes of SRAM a layout takes.
    The greeting s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
    [cable.h, cable_format.h, collections.h, panel_text.h]
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2026-09-01 feat(audio)!: a recording may travel compressed, and the device says whether it can play one
    The other half of adr/0022: the codec landed in 05a83ad, and this is who gets
    which form. Four collections beside each other are 6031 KiB of speech against
    about 6500 KiB of file area - 93 per cent of what is occupied - and at 60 KB a
    second that is a hundred seconds of somebody holding a talker still.
    Measured on the 36 recordings of Spiegel und Ei, read back off a real device
    and put back compressed: 2914 KiB to 709 KiB, factor 4.11, and 2204 KiB freed
    on the partition. Signal to noise 18.0 dB at worst and 31.7 at best - better
    than the four short example words, which are the hard case at 15.0.
    T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
    [cable.h, cable_format.h, vorlaut.ino]
2026-09-01 fix(collections)!: a collection travels with its own name and its own identity
    adr/0021 gave the talker several collections a day ago. Looking at the three
    real ones it was built for rather than at the format found that it could not
    tell them apart, and for two reasons that are one omission: a device package
    carried no package identity at all.
    **Every Sammlung was the same file.** A collection's file is named for what
    identifies it, and that was read off the root board - on the reasoning written
    into device_package.ts that a root board's id was "the only thing in a .obz
    that is about the Sammlung rather than about a board". It is about a board.
    The editor's boardId(at) is `set-${at + 1}`, s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
2026-09-01 docs(adr): what the talker actually sounded like, and what the log said
    Heard on 2026-09-01: almost identical, with a faint click, and kept on that
    judgement. Whether the click is a new one was not established - bring-up.md
    stage 5 ends with one that survived all four bench experiments and was never
    accounted for, so there is an old one to confuse it with.
    The log says the decoder is not what is producing it either way: played came
    out 3 to 4 per cent below expected on all five words, and a starved I2S stream
    overshoots rather than undershoots.
    And the thing nobody was aiming at - a 3.6-second word is 117 KiB as PCM and
    29 as ADPCM, so it now fits AUDIO_PRELOAD and plays out of RAM instead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
2026-09-01 fix(loader): the same-name warning names a rename that changes the menu name
    The sentence told somebody to give the collection a different name in
    the editor. Today that does nothing.
    What the device shows is the head of the collection file, and
    compileDevice() puts the Sammlung's name there only where the package
    carries one. The editor half of 827e33c has not landed - it is blocked
    on that repository's device export being an ADR behind - so every .obz
    in existence has an empty ext_lautstark_package_name and the slot keeps
    the first set's name.
    That lands exactly on the one case this warning can still fire in. Two
    collections from today's editor share a file name, because identity
    falls b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
2026-09-01 feat(firmware): the first menu screen only points, one screen per thing
    The volume moves one level down, beside the collections, and the screen
    the menu opens on carries nothing but the two doors and two dark keys.
    The comment beside AUDIO_VOLUME_PERCENT argued the other way and is
    pulled through rather than left standing: the volume is still the one
    thing in here anybody presses more than once, and that was the wrong
    thing to weigh. A first screen that carries controls of its own does not
    grow - this one was full at two things, and the third would have gone a
    level down, leaving some of the menu above and some below with no rule
    visible from the outside.
    The set key means back on all thre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
    [texts.h, vorlaut.ino]
2026-09-01 fix(release): a tag deploys the page, instead of waiting for a merge
    adr/0017 has the page carry the firmware image as an asset of its own
    deploy and resolve it at deploy time, and calls a deploy per release
    cheap because "main deploys on every merge already". True, and it does
    not cover a tag: a v* tag is cut from a commit already on main, so it
    pushes nothing, and pages.yml triggers on branches: [main]. The newest
    release reached the page on somebody's next unrelated merge - hours or
    days - and until then the page went on offering the tag before it
    without saying anything was missing.
    release.yml now dispatches pages.yml as its last step, after the release
    exists so the deploy can find it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
2026-09-01 fix(cable): the quiet window starts when the device stops talking
    CABLE_QUIET_MS is the browser's four seconds to answer, and serve() was
    measuring it from the moment a command arrived rather than from the moment
    the reply to that command finished going out. So the device's own answer was
    charged to the browser's window.
    A get is where this showed. sayFile() reads the file twice - once for the
    checksum in the head, once for the bytes - and blocks in Serial.write() until
    the host drains it, and all of that came off the window. A browser that
    replied the instant it had the file could still be late, and the next verb
    then met a session that had already been shut and came back "err session",
    wi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
    [cable.h]
2026-09-01 fix(loader): a failed look leaves the way to ask again, and a waiting step says what it wants
    Two things somebody pressing "Have a look" ran into.
    The failure was a dead end. look() calls collections.begin(), which
    replaceChildren()s the button out of the body, and the catch wrote its
    sentence and returned without putting one back - so the only way to ask a
    second time was to reload the page. drop()'s own catch has always re-added it;
    this is that line, in the other handler. It goes beside the failure rather
    than through collectionsSection(), which would redraw over the sentence that
    has just been written.
    The five steps were four dimmed headings with nothing under them. "Check",
    "Compile"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
2026-09-01 feat(loader): the device's own words get sentences, in both languages
    "Sending failed: session" was a protocol token printed where a sentence
    belonged, and on a read-only look it was not even sending. errors.ts has said
    what to do about that since it was written - a word is a case, and a case has
    a line in boot_data.ts - but only Trouble was routed that way. CableError
    carries the word the device answered with and is not a Trouble, so every one
    of them fell through to the generic template.
    All nine the firmware can send now have a line: session, short, lost, crc,
    nospace, write, missing, verb, bad. Each says what happened, what state that
    leaves the device in, and what to do next - the thre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
2026-09-01 fix(cable): a write that went short was counted as sent
    From a real talker: "Sending failed: the device sent 570 of 1072 bytes and
    stopped", reading a collection back.
    Serial.write() is not a promise. On the S3's native USB it returns how many
    bytes it managed, and a full transmit queue makes that fewer than it was asked
    for - the call gives up on its own timeout rather than blocking until the host
    catches up. sayFile() and put() ignored that number and counted the whole
    chunk as gone, so the device believed it had sent bytes that never left. The
    browser then waited for a file short by exactly the amount dropped, and its
    own watchdog named the device.
    receive() has always checked the other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
    [cable.h]
2026-09-01 fix(cable): a file arriving in one read with its own head is still a file
    The bug behind "the device sent 570 of 1072 bytes and stopped", and it is on
    this side of the wire rather than the device's.
    USB does not promise that one write is one read. A small file leaves the
    talker as a head line, a body and a tail line and can arrive as a single
    buffer. #chew() parsed the head, resolved the promise `get` was waiting on -
    and carried straight on through the same synchronous loop, because the code
    that awaited that promise cannot run until the loop lets go. So the file was
    read as conversation and handed to onLog byte for byte, and the raw read set
    up a microtask later waited for bytes that had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
2026-09-01 feat(loader): the firmware and the collections are the cards they were drawn as
    The connect-first page moved these two sections into the talker view and
    reordered them, and left both of them looking exactly as they had. That was
    half the change, and the half nobody can see.
    **The firmware pair.** `v0.10 -> v0.11` says what the talker has, what the
    page has, and that there is a difference, before a word of prose is read. It
    replaces flash.carries and flash.device_says at the top of the panel, which
    said the same thing at four times the length and pushed the sentence that
    mattered - the verdict - into third place. The arrow appears only where the
    two are ordered; where they are not, because a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
2026-09-02 docs: the page is a door, a talker and a task
    Part of the change that made it one, not a sweep: README and docs/cable.md both
    described five steps down one column, which stopped being true this afternoon
    and was wrong in the two places somebody reads before they open the page.
    docs/cable.md gains the half that is worth writing down rather than
    rediscovering: the door is not a gate. WebSerial is Chrome and Edge and so is
    showDirectoryPicker(), so a page that asks for a talker before it will say
    anything is the mistake gate() exists to undo, in a better-looking shape. The
    second way in is on the same card and is the primary button where there is no
    cable to be had.
    And connecting is describe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
2026-09-02 fix(loader): a walk through a full file system outlasts one answer
    A talker that had been filled up stopped answering the loading page, and
    said so in the words for a device that is not there: "Nothing answered.
    Is the cable in, and is the device awake?" The cable was in and the
    device was awake.
    `hello` and `list` both make the firmware walk its file system, and the
    walk is the cost rather than the wire. Measured on the device on the
    bench, v0.11, a 7040 KiB partition holding 322 files:
    0.0s < firmware v0.11
    0.7s < free 3231744
    7.1s < files 322 <- the walk
    7.1s < end hello
    Every line before and after the count came instantly. The client gave
    each answer 5000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
2026-09-02 fix(loader): only a device that has answered gets the walk's patience
    The fix one commit back gave every line of the greeting the thirty
    seconds the file-system walk needs, and a greeting is also the probe:
    findTalker() greets every granted port to find out which one is a
    talker. So a port that is not a talker went from costing three attempts
    of five seconds to three of thirty, and somebody who picked a printer in
    the chooser would have sat through a minute and a half of nothing before
    being told.
    e2e/loader.spec.ts caught it - "a port that answers nothing gets the
    chooser offered again, and says so" and "a port that answers nothing is
    offered a first flash" both ran past their timeout - wh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
2026-09-02 fix(loader): a port that would not open says so instead of blaming the cable
    findTalker() greets every granted port to find the talker among them, and
    the loop's catch was bare. Every way a port can fail arrived at one
    sentence: "Nothing answered. Is the cable in, and is the device awake?
    Only a key press brings it out of sleep, not the cable."
    That is right for a printer and wrong for a port another program is
    holding, which is the commonest reason a port will not open at all - a
    second tab of this page, a serial monitor, the Arduino IDE. It happened
    on the bench: a script had the port, the page said the cable might be
    out, and the cable was in and the device awake the whole time. The
    sent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
2026-09-16 test: run the TypeScript harnesses under plain node, not vite-node
    Node strips types itself since 22.18. What it does not do is resolve the
    `.js` names the sources import each other by to the `.ts` files they are,
    and tests/node_ts.mjs is that one hook, registered with --import. It is the
    whole of what vite-node was doing for the four tests that drive loader/src -
    tiles, their compression, the layout writer and the ADPCM encoder - and the
    reason this repository could not leave vitest 2: vite-node is vitest 2's
    loader and is not in vitest 4. Nothing has to be installed for this half of
    the suite any more; the install check stays because the references are
    still compared against what package.j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
2026-09-16 docs(renovate): the shared packages stay github: tags, followed through github-tags
    The family decided against a registry the same afternoon the npm path landed. What this file said about npmjs.org is corrected; the bildquelle exception names the pin under both spellings the datasource can report.
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2026-10-01 ci: run on Node 24, the active LTS
    Node 22 is in maintenance, and its npm 10 disagrees with npm 11 - the one
    Renovate and a current machine write lockfiles with - about what a
    lockfile must hold, which is what failed bildquelle and sicherung today.
    @types/node follows the runtime CI tests on. typecheck, unit tests and
    build are green on a clean install.
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2026-10-01 test(fixtures): a set key crossed out, so a writer is held to the flag
    make_fixtures.mjs wrote `negated: false` on every set key, outright, so no
    package fixture ever asked a writer for ext_vorlaut_negated on the set key's
    button. The editor's writer duly left it off: the editor drew the fifth panel
    crossed out and the device drew the plain picture - "ja" where the child had
    been shown "nicht ja". The loader already read the flag and the compiler
    already drew it; the gap was only that nothing stated it.
    package/set-key-crossed-out puts the crossed-out reference on a set key with
    a word of its own, beside the same picture plain on a speech key, so the
    archive holds one member and the flag is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
